ehughes/NEOS_2ND_GENERATION/TOOLS/NEOS_CAN_ADAPTER/SRC/WINDOWS/CAN_SNIFFER/bin/Debug/LightRingSelectorPanel.png

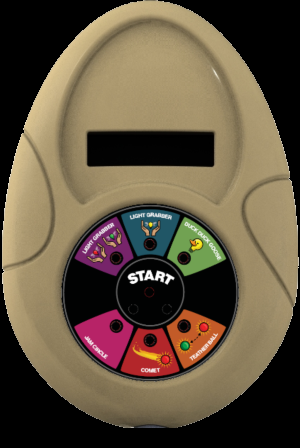
TOOLS/NEOS_CAN_ADAPTER/SRC/WINDOWS/CAN_SNIFFER/bin/Debug/LightRingSelectorPanel.png
