ehughes/NEOS_2ND_GENERATION/TOOLS/NEOS_CAN_ADAPTER/SRC/WINDOWS/CAN_SNIFFER/bin/Debug/AllAroundSelectorPanel.bmp

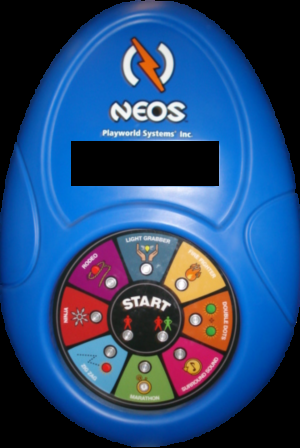
TOOLS/NEOS_CAN_ADAPTER/SRC/WINDOWS/CAN_SNIFFER/bin/Debug/AllAroundSelectorPanel.bmp
