ehughes/NEOS_2ND_GENERATION/SCH/ELC0102 - Scoreboard/BUILD_PACKAGE/GERBERS/readme.txt

Technical POC:   Eli Hughes    ehughes@wavenumber.net  814 574 7755

PCB Fab Notes.

File List:
---------------------------------------------
PCB0010.GM1   Outline
PCB0010.GM2   Dimensions
PCB0010.GM3   Cutouts

PCB0010.GTL   Top Copper
PCB0010.GTS   Top Soldermask
PCB0010.GTO   Top Silkscreen
PCB0010.GTP   Top Pastemask

PCB0010.GP1   Ground Plane   -  Negative Layer!
PCB0010.GP2   Power Plane    -  Negative Layer!

PCB0010.GBL   Bottom Copper
PCB0010.GBO   Bottom Silkscreen
PCB0010.GBS   Bottom Soldermask
PCB0010.GBP   Bottom Pastemask

PCB0010.TXT   NC Drill

4-layer Stack Up:
-------------------------------
Top  Copper
Ground Plane
Power Plane
Botton Copper

Notes:
--------------------------------------------
ALL DIMENSIONS ARE FINISHED DIMENSIONS
OVERAL DIMENSION: 15" x 7"
ALL HOLES ARE PLATED THRU W/ MIN .001 (1 OZ) COPPER.
FINISH: GOLD FLASH OVER ALL EXPOSED COPPER
MAT'L: FR-406 OR EQUIVALENT ROHS COMPLIANT, .062 THK.
NOTES:  UNLESS OTHERWISE SPECIFIED
POWER AND GROUND LAYER - 0.5 OZ COPPER.
RADIUS OF INSIDE CUTOUT - 50 MIL - SEE CUTOUTS LAYER
SILKSCREEN COMP SIDE W/ WHITE EPOXY INK, OVER SOLDERMASK.
SOLDERMASK BOTH SIDES OF BOARD. L.P.I. OVER BARE COPPER, RED.
TOP AND BOTTOM LAYER - 1 OZ COPPER AFTER PLATING.
VENDOR'S UL APPROVAL MARK MUST BE ON BOARD, 94V-0.
WEEK & YEAR OF FABRICATION TO BE STAMPED ON BOARD.
