ehughes/NEOS_2ND_GENERATION/DOCS/USB_CAN_IF.pptx

NEOS Can Bus Interface Module

FT245 USB/FIFO Interface IC

Incoming Message Queue

Outgoing Message Queue

NEOS
CAN Bus

NEOS Microcontroller

FT245 low level Interface

USB Cable to PC
