ehughes/NEOS_2ND_GENERATION/SRC/PRODUCTION_RELEASE/MASTER/SHREK/Shrek Game Mods.docx

Don’t reset back to station ID

Three chances for full game

Generate new sequence on failure

Time on inactivity should be 10 seconds, After 6 second of inactivity, count as a bad

Play sequence at One Second per button
