ehughes/NEOS_2ND_GENERATION/TOOLS/NEOS_ALL_AROUND_CONTROL_PANEL/Images/dagobert83_USB.png

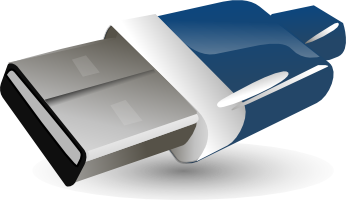
TOOLS/NEOS_ALL_AROUND_CONTROL_PANEL/Images/dagobert83_USB.png
