ehughes/NEOS_2ND_GENERATION/SCH/ELC0102 - Scoreboard/BUILD_PACKAGE/BOM/Bill of Materials-ELC0102 - Scoreboard(MAIN_BUILD).xls

Sheet: Part List Report
 | Assembly Sheet |  |  | ELC0102 - NEOS Scoreboard
 |  |  | Variant: | MAIN_BUILD
 | Report Date: |  | 12/13/2010 | 7:01:08 AM
 | Print Date: |  | 2010-12-13 | 7:05:29
# | Quantity | Designator | Description | Manufacturer | Manufacturer Part Number | Supplier 1 | Supplier Part Number 1
1 | 18 | C1, C3, C4, C10, C11, C17, C28, C30, C31, C37, C46, C47, C48, C49, C50, C51, C52, C53 | CAP .10UF 50V CERAMIC X7R 0805 | Kemet | C0805C104K5RACTU | Digi-Key | 399-1170-1-ND
2 | 3 | C2, C23, C32 | Panasonic 10uF 16V SMT | Panasonic - ECG | EEE-FK1C100R | Digi-Key | PCE3782CT-ND
3 | 2 | C8, C9 | Kemet Tantalum 47uF 35V EIA7343-43 | Kemet | T491X476K035AT | Digi-Key | 399-3821-1-ND
4 | 1 | C15 | CAP 10000PF 50V CERAMIC X7R 0805 | Kemet | C0805C103K5RACTU | Digi-Key | 399-1158-1-ND
5 | 2 | C20, C24 | CAPACITOR TANT 68UF 16V 10% SMD | Kemet | T495D686K016ATE150 | Digi-Key | 399-3889-1-ND
6 | 2 | C22, C26 | CAP CERAMIC 18PF 50V NP0 0805 | Kemet | C0805C180J5GACTU | Digi-Key | 399-1112-1-ND
7 | 1 | D1 | Diode 3A 600V SMC | ON Semiconductor | MURS360T3G | Digi-Key | MURS360T3GOSCT-ND
8 | 1 | D2 | IR Schottky Diode 8A 80V D2PAK | Vishay IR | 8TQ080SPBF | Digi-Key | 8TQ080SPBF-ND
9 | 20 | D3, D4, D5, D6, D7, D8, D9, D10, D11, D15, D16, D17, D18, D19, D20, D21, D22, D23, D24, D25 | Zener 3.0V SOD-123 | ON Semiconductor | MMSZ5225BT1G | Digi-Key | MMSZ5225BT1GOSCT-ND
10 | 84 | DS1, DS2, DS3, DS4, DS5, DS6, DS13, DS14, DS15, DS16, DS17, DS18, DS25, DS26, DS27, DS28, DS29, DS30, DS37, DS38, DS39, DS40, DS41, DS42, DS49, DS50, DS51, DS52, DS53, DS54, DS61, DS62, DS63, DS64, DS65, DS66, DS73, DS74, DS75, DS76, DS77, DS78, DS85, DS86, DS87, DS88, DS89, DS90, DS97, DS98, DS99, DS100, DS101, DS102, DS109, DS110, DS111, DS112, DS113, DS114, DS121, DS122, DS123, DS124, DS125, DS126, DS133, DS134, DS135, DS136, DS137, DS138, DS145, DS146, DS147, DS148, DS149, DS150, DS157, DS158, DS159, DS160, DS161, DS162 | Optek LED Red /Clear High Brightness T1-3/4 | TT Electronics/Optek Technology | OVLFR3C7 | Digi-Key | 365-1182-ND
11 | 84 | DS7, DS8, DS9, DS10, DS11, DS12, DS19, DS20, DS21, DS22, DS23, DS24, DS31, DS32, DS33, DS34, DS35, DS36, DS43, DS44, DS45, DS46, DS47, DS48, DS55, DS56, DS57, DS58, DS59, DS60, DS67, DS68, DS69, DS70, DS71, DS72, DS79, DS80, DS81, DS82, DS83, DS84, DS91, DS92, DS93, DS94, DS95, DS96, DS103, DS104, DS105, DS106, DS107, DS108, DS115, DS116, DS117, DS118, DS119, DS120, DS127, DS128, DS129, DS130, DS131, DS132, DS139, DS140, DS141, DS142, DS143, DS144, DS151, DS152, DS153, DS154, DS155, DS156, DS163, DS164, DS165, DS166, DS167, DS168 | Optek LED Green/Clear High Brightness T1-3/4 | OPTEK | OVLFG3C7 | Digi-Key | 365-1181-ND
12 | 4 | J11, J12, J16, J17 | Deutsch 12P Sealed PCB connector | Deutsch | DT15-12PA | LADD Industries Inc. | DT15-12PA
13 | 1 | J13 | CONN HEADER VERT 6POS 5.08MM | Phoenix Contact | 1755778 | Digi-Key | 277-1154-ND
14 | 1 | L1 | Magnetic-Core Inductor | Coilcraft | DO5022P-333MLD | Coilcraft | DO5022P-333MLD
15 | 20 | Q1, Q2, Q3, Q4, Q5, Q6, Q7, Q8, Q9, Q10, Q11, Q12, Q13, Q14, Q15, Q16, Q17, Q18, Q19, Q20 | HEXFET Power MOSFET | STMicroelectronics | VNB14NV04 | Digi-Key | VNB14NV04-ND
16 | 42 | Q22, Q23, Q24, Q25, Q26, Q27, Q28, Q29, Q30, Q31, Q32, Q33, Q34, Q35, Q36, Q37, Q38, Q39, Q40, Q41, Q42, Q43, Q44, Q45, Q46, Q47, Q48, Q49, Q50, Q51, Q52, Q53, Q54, Q55, Q56, Q57, Q58, Q59, Q60, Q61, Q62, Q63 | NPN SOT23 Silicon Planar Small Signal Transistor | Fairchild Semiconductor | BCX70K | Digi-Key | BCX70KINCT-ND
17 | 108 | R3, R6, R7, R8, R9, R10, R11, R12, R13, R14, R15, R17, R19, R33, R34, R35, R36, R37, R38, R39, R40, R41, R42, R43, R44, R45, R46, R47, R48, R49, R50, R51, R52, R55, R62, R63, R64, R65, R66, R69, R70, R71, R72, R73, R84, R85, R86, R87, R88, R89, R90, R91, R92, R93, R94, R95, R96, R97, R98, R99, R100, R101, R102, R103, R104, R105, R106, R107, R108, R109, R110, R123, R124, R125, R126, R127, R128, R141, R142, R143, R144, R145, R146, R159, R160, R161, R162, R163, R164, R177, R178, R179, R180, R181, R182, R195, R196, R197, R198, R199, R200, R213, R214, R215, R216, R217, R218, R231 | RES 5.10K OHM 1/8W 1% 0805 SMD | Panasonic - ECG | ERJ-6ENF5101V | Digi-Key | P5.10KCDKR-ND
18 | 1 | R18 | RES 1.00K OHM 1/8W 1% 0805 SMD | Panasonic - ECG | ERJ-6ENF1001V | Digi-Key | P1.00KCCT-ND
19 | 1 | R29 | RES 5.60K OHM 1/8W 1% 0805 SMD | Panasonic - ECG | ERJ-6ENF5601V | Digi-Key | P5.60KCCT-ND
20 | 1 | R32 | RES 0.0 OHM 1/8W 5% 0805 SMD | Panasonic - ECG | ERJ-6GEY0R00V | Digi-Key | P0.0ADKR-ND
21 | 1 | R56 | RES 7.50K OHM 1/8W 1% 0805 SMD | Panasonic - ECG | ERJ-6ENF7501V | Digi-Key | P7.50KCCT-ND
22 | 1 | R57 | RES 2.49K OHM 1/8W 1% 0805 SMD | Panasonic - ECG | ERJ-6ENF2491V | Digi-Key | P2.49KCCT-ND
23 | 42 | R111, R112, R113, R117, R118, R119, R129, R130, R131, R135, R136, R137, R147, R148, R149, R153, R154, R155, R165, R166, R167, R171, R172, R173, R183, R184, R185, R189, R190, R191, R201, R202, R203, R207, R208, R209, R219, R220, R221, R225, R226, R227 | RES 180 OHM 1/4W 1% 1206 SMD | Panasonic - ECG | ERJ-8ENF1800V | Digi-Key | P180FTR-ND
24 | 42 | R114, R115, R116, R120, R121, R122, R132, R133, R134, R138, R139, R140, R150, R151, R152, R156, R157, R158, R168, R169, R170, R174, R175, R176, R186, R187, R188, R192, R193, R194, R204, R205, R206, R210, R211, R212, R222, R223, R224, R228, R229, R230 | RES 120 OHM 1/4W 1% 1206 SMD | Panasonic - ECG | ERJ-8ENF1200V | Digi-Key | P120FCT-ND
25 | 8 | U1, U14, U19, U20, U21, U22, U23, U24 | Octal D-Type Transparent Latch with 3-State Outputs | NXP Semiconductors | 74HC573D-T | Digi-Key | 568-1477-1-ND
26 | 1 | U3 | Microchip dsPIC30F6014A 80-TQFP | Microchip Technology | DSPIC30F6014A-30I/PT | Digi-Key | DSPIC30F6014A30IP-ND
27 | 1 | U5 | CAN Transceiver 3.3V w/standby | Texas Instruments | SN65HVD230DR | Digi-Key | 296-11654-1-ND
28 | 1 | U7 | Simple Switcher Power Converter 150 kHz 3A Step Down Voltage Regulator | NATIONAL SEMICONDUCTOR | LM2676S-ADJ/NOPB | Newark | 41K4150
29 | 2 | U8, U12 | National Voltage reculator 3.3V DPAK | National Semiconductor | LP2950CDT-3.0 | Digi-Key | LP2950CDT-3.0-ND
30 | 2 | U10, U18 | Octal Buffer and Line Driver with 3-State Outputs | Texas Instruments | SN74HC541DWR | Digi-Key | 296-1202-1-ND
31 | 1 | U25 | 3-Line to 8-Line Decoder / Demultiplexer | STMicroelectronics | M74HC238RM13TR | Digi-Key | 497-1800-1-ND
32 | 1 | Y1 | CRYSTAL 8.192MHZ 18PF SMD | Abracon Corporation | ABLS-8.192MHZ-B2-T | Digi-Key | 535-9090-1-ND
Approved |  |  |  | Notes

Sheet: Project Information
Project Full Path | C:\eli\DATA\consulting\PLAYWORLD_SYSTEMS\NEOS\SCH\ELC0102 - Scoreboard\ELC0102 - Scoreboard.PrjPcb
Project Filename | ELC0102 - Scoreboard.PrjPcb
Variant Name | MAIN_BUILD
Data-Source Filename | ELC0102 - Scoreboard.PrjPcb
Data-Source Full Path | C:\eli\DATA\consulting\PLAYWORLD_SYSTEMS\NEOS\SCH\ELC0102 - Scoreboard\ELC0102 - Scoreboard.PrjPcb
Title | ELC102 - NEOS Scoreboard
Total Quantity | 500
Report Time | 7:01:08 AM
Report Date | 12/13/2010
Report Date & Tine | 12/13/2010 7:01:08 AM
Output Name | Bill of Materials
Output Type | BOM_PartType
Output Generator Name | BOM
Output Generator Description | Bill of Materials
