ehughes/NEOS_2ND_GENERATION/SCH/ELC0205 - Power Entry Module/BUILD_PACKAGE/BOM/Bill of Materials-ELC0205.xls

Sheet: Part List Report
 | Assembly Sheet |  |  | Bill of Materials For Schematic Document [ELC0205.SchDoc]
 |  |  | Variant: | None
 | Report Date: |  | 11/3/2010 | 6:34:29 AM
 | Print Date: |  | 2010-11-03 | 6:34:32
# | Quantity | Designator | Description | Manufacturer | Manufacturer Part Number | Supplier 1 | Supplier Part Number 1
1 | 1 | D1 | 15000W Axial Leaded Transient Voltage Suppressor | Littelfuse Inc | 15KPA24CA-B | Arrow | 15KPA24CA-B
2 | 1 | D2 | LED 5MM GAP RED RT ANGLE HOUSING | Avago Technologies US Inc. | HLMP-3301-D00B2 | Digikey | 516-1761-ND
3 | 1 | F1 | Shock-Safe Fuseholder, 5 x 20 / 6.3 x 32 mm, Slot Knob, horizontal | Schurter | 0031.2500 | Avnet | 0031.2500
4 | 1 | JP1 | Fixed Terminal Blocks MKDSP 10 HV/ 3-10. | Phoenix Contact | 1929520 | Mouser | 651-1929520
5 | 1 | R1 | RES 1.0K OHM CARBON FILM 1/4W 5% | Panasonic - ECG | ERD-S2TJ102V | Digikey | P1.0KBACT-ND
Approved |  |  |  | Notes

Sheet: Project Information
Project Full Path | C:\eli\DATA\consulting\PLAYWORLD_SYSTEMS\NEOS\SCH\ELC0205 - Power Entry Module\ELC0205 - Power Entry Module.PrjPCB
Project Filename | ELC0205 - Power Entry Module.PrjPCB
Variant Name | None
Data-Source Filename | ELC0205.SchDoc
Data-Source Full Path | C:\eli\DATA\consulting\PLAYWORLD_SYSTEMS\NEOS\SCH\ELC0205 - Power Entry Module\ELC0205.SchDoc
Title | Bill of Materials For Schematic Document [ELC0205.SchDoc]
Total Quantity | 5
Report Time | 6:34:29 AM
Report Date | 11/3/2010
Report Date & Tine | 11/3/2010 6:34:29 AM
Output Name | Bill of Materials
Output Type | BOM_PartType
Output Generator Name | BOM
Output Generator Description | Bill of Materials
