ehughes/NEOS_2ND_GENERATION/TOOLS/NEOS_CAN_ADAPTER/SCH/Project Outputs for NEOS_CAN/BOM.xls

Sheet: Part List Report
 | Assembly Sheet |  |  | NEOS USB to CAN
 |  |  | Variant: | None
 | Report Date: |  | 4/1/2008 | 11:42:52 AM
 | Print Date: |  | 2008-04-01 | 11:42:53
# | Quantity | Designator | Description | Manufacturer | Manufacturer Part Number | Source | Source Part Number
1 | 10 | C1, C2, C6, C7, C8, C9, C10, C11, C12, C13 | 0.1uF | Murata Electronics North America | GRM188R71C104KA01D | Digikey | 490-1532-1-ND
2 | 2 | C3, C4 | CAP CER 18PF 50V 5% C0G 0603 | Murata Electronics North America | CAP CER 18PF 50V 5% C0G 0603, GRM1885C1H180JA01D | Digikey | 490-1409-1-ND
3 | 1 | C5 | 10uF 1206 | Murata Electronics North America | GRM31CF51E106ZA01L | Digikey | 490-3382-1-ND
4 | 4 | D1, D2, D3, D4 | LED ALINGAP RED CLEAR 0805 SMD | Dialight | 598-8110-107F | Digikey | 598-8110-107F
5 | 1 | J1 | DTM13-12PA-R008 | Duetsch IPD | DTM13-12PA-R008 | Ladd Industries | DTM13-12PA-R008
6 | 1 | J2 | USB TYPE B R/A PCB | FCI | 61729-0010BLF | Digikey | 609-1039-ND
7 | 1 | J14 | CONN HEADER VERT 6POS 5.08MM | Phoenix Contact | 1758050 | Digikey | 277-1132-ND
8 | 2 | Q1, Q2 | TRANSISTOR NPN 100V 3A SOT-23 | Zetex Inc | ZXTN25100BFHTA | Digikey | ZXTN25100BFHCT-ND
9 | 1 | R1 | 100 | Yageo | RC0805FR-07100RL | Digikey | 311-100CRCT-ND
10 | 1 | R2 | 10k | Yageo | RC0805FR-071KL | Digikey | 311-1.00KCRCT-ND
11 | 1 | R3 | 0 | Yageo | RC0603JR-070RL | Digikey | 311-0.0GRCT-ND
12 | 1 | R4 | 3.9k | Yageo | RC0805FR-073K9L | Digikey | 311-3.90KCRCT-ND
13 | 5 | R5, R7, R8, R12, R13 | 1k | Panasonic - ECG, Yageo | RC0805FR-071KL | Digikey | 311-1.00KCRCT-ND
14 | 4 | R6, R9, R10, R11 | 300 | Yageo | RC0805FR-07300RL | Digikey | 311-300CRCT-ND
15 | 1 | U1 | IC REG LDO 500MA 3.3V SOT-223 | National Semiconductor | LM2937IMP-3.3/NOPB | Digikey | LM2937IMP-3.3CT-ND
16 | 1 | U2 | Microchip dsPIC30F6014 80-TQFP | Microchip Technology | DSPIC30F6014A-30I/PT | Digikey | DSPIC30F6014A30IP-ND
17 | 1 | U3 | IC 3.3V CAN TXRX W/STNDBY 8-SOIC | Texas Instruments | SN65HVD230DR | Digikey | 296-11654-1-ND
18 | 1 | U4 | CRYSTAL 12.288 MHZ SMT 18PF | Citizen America Corporation - Component Sales Division | HCM49 12.288MABJ-UT | Digikey | 300-8550-1-ND
19 | 1 | U5 | USB Interface ICs USB TO PARALLEL FIFO 28 PIN SSOP | FTDI | FT245RL | Mouser | 895-FT245RL
20 | 1 | U6 | PHOTOCOUPLER PHOTORELAY 4-SOP | Toshiba | TLP172A(F) | Digikey | TLP172AF-ND
Approved |  |  |  | Notes

Sheet: Project Information
Project Full Path | C:\ELI\DEVELOPMENT\NEOS_CAN_ADAPTER\SCH\NEOS_CAN.PrjPcb
Project Filename | NEOS_CAN.PrjPcb
Variant Name | None
Data-Source Filename | NEOS_CAN.PrjPcb
Data-Source Full Path | C:\ELI\DEVELOPMENT\NEOS_CAN_ADAPTER\SCH\NEOS_CAN.PrjPcb
Title | NEOS USB to CAN
Total Quantity | 41
Report Time | 11:42:52 AM
Report Date | 4/1/2008
Report Date & Tine | 4/1/2008 11:42:52 AM
Output Name | Bill of Materials
Output Type | BOM_PartType
Output Generator Name | ReportComponents
Output Generator Description | Component Reports
