ehughes/NEOS_2ND_GENERATION/SCH/ELC0103 - Master & ELC104 - Slave/BUILD_PACKAGE/ELC0104_NEOS_MASTER/BOM/Bill of Materials-NEOS Master-Slave(MASTER - ELC0104).xls

Sheet: Part List Report
 | Assembly Sheet |  |  | Bill of Materials For Variant [MASTER - ELC0104] of Project [NEOS Master-Slave.PrjPcb] (No PCB Document Selected)
 |  |  | Variant: | MASTER - ELC0104
 | Report Date: |  | 10/30/2010 | 5:32:35 PM
 | Print Date: |  | 2010-10-30 | 17:32:39
# | Quantity | Designator | Description | Manufacturer | Manufacturer Part Number | Supplier 1 | Supplier Part Number 1
1 | 10 | C1, C3, C4, C8, C11, C13, C23, C33, C37, C42 | CAP .10UF 50V CERAMIC X7R 0805 | Kemet | C0805C104K5RACTU | Digikey | 399-1170-1-ND
2 | 2 | C2, C21 | CAP ELECT 10UF 16V FK SMD | Panasonic - ECG | EEE-FK1C100R | Digikey | PCE3782CT-ND
3 | 2 | C16, C20 | CAP CERAMIC 18PF 50V NP0 0805 | Kemet | C0805C180J5GACTU | Digikey | 399-1112-1-ND
4 | 1 | D1 | DIODE ULTRA FAST 3A 600V SMC | ON Semiconductor | MURS360T3G | Digikey | MURS360T3GOSCT-ND
5 | 3 | D3, D4, D5 | Diodes Inc BAS16 75V 200mA | Diodes Inc | BAS16-7-F | Digikey | BAS16-7-F
6 | 1 | DS49 | LED 631NM TAPERED RED 5MM | TT Electronics/Optek Technology | OVLGS0C8B9 | Digikey | 365-1189-ND
7 | 1 | DS50 | LED 525NM ROUND GREEN 5MM | TT Electronics/Optek Technology | OVLFG3C7 | Digikey | 365-1181-ND
8 | 1 | J14 | CONN HEADER VERT 6POS 5.08MM | Phoenix Contact | 1755778 | Digikey | 277-1154-ND
9 | 3 | JP3, JP4, R8 | RES 0.0 OHM 1/8W 5% 0805 SMD | Panasonic - ECG | ERJ-6GEY0R00V | Digikey | P0.0ACT-ND
10 | 11 | R1, R2, R3, R6, R10, R14, R19, R21, R23, R26, R27 | RES 100K OHM 1/8W 1% 0805 SMD | Panasonic - ECG | RC0805JR-07100KL | Digikey | 311-100KARCT-ND
11 | 2 | R4, R112 | RES 10.0K OHM 1/8W 1% 0805 SMD | Panasonic - ECG | ERJ-6ENF1002V | Digikey | P10.0KCCT-ND
12 | 1 | R24 | RES 7.50K OHM 1/8W 1% 0805 SMD | Panasonic - ECG | ERJ-6ENF7501V | Digikey | P7.50KCCT-ND
13 | 1 | R25 | RES 2.49K OHM 1/8W 1% 0805 SMD | Panasonic - ECG | ERJ-6ENF2491V | Digikey | P2.49KCCT-ND
14 | 2 | R28, R40 | RES 1.00K OHM 1/8W 1% 0805 SMD | Yageo | RC0805FR-071KL | Digikey | 311-1.00KCRCT-ND
15 | 1 | R128 | RES 3.16K OHM 1/8W 1% 0805 SMD | Panasonic - ECG | ERJ-6ENF3161V | Digikey | P3.16KCCT-ND
16 | 1 | R129 | RES 20.0K OHM 1/8W 1% 0805 SMD | Panasonic - ECG | ERJ-6ENF2002V | Digikey | P20.0KCCT-ND
17 | 4 | U1, U4, U8, U9 | 64 MBit Serial SPI NOR FLASH | STMicroelectronics / Numonyx | M25P64-VMF6P | Mouser | M25P64-VMF6P
18 | 1 | U2 | IC DSPIC MCU/DSP 144K 80TQFP | Microchip Technology | DSPIC30F6014A-30I/PT | Digikey | DSPIC30F6014A30IP-ND
19 | 1 | U3 | IC 3.3V CAN TXRX W/STNDBY 8-SOIC | Texas Instruments | SN65HVD230DR | Digikey | SN65HVD230D-ND
20 | 1 | U7 | IC REG VOLT MICROPWR 3.3V TO-252 | National Semiconductor | LP2950CDT-3.3/NOPB | Digikey | LP2950CDT-3.3-ND
21 | 1 | U12 | OPTOCOUPLER TRANS-OUT 2CH 8-SOIC | Fairchild Optoelectronics Group | MOCD207M | Digikey | MOCD207M-ND
22 | 1 | U14 | IC USB-TO-UART BRIDGE 28MLP | Silicon Laboratories Inc | CP2102-GM |  | Digikey
23 | 1 | Y1 | CRYSTAL 8.192MHZ 18PF FUND SMD | Abracon Corporation | ABLS-8.192MHZ-B2-T | Digikey | 535-9090-1-ND
Approved |  |  |  | Notes

Sheet: Project Information
Project Full Path | C:\eli\DATA\consulting\PLAYWORLD_SYSTEMS\NEOS\SCH\ELC0103 - Master & ELC104 - Slave\NEOS Master-Slave.PrjPcb
Project Filename | NEOS Master-Slave.PrjPcb
Variant Name | MASTER - ELC0104
Data-Source Filename | NEOS Master-Slave.PrjPcb
Data-Source Full Path | C:\eli\DATA\consulting\PLAYWORLD_SYSTEMS\NEOS\SCH\ELC0103 - Master & ELC104 - Slave\NEOS Master-Slave.PrjPcb
Title | Bill of Materials For Variant [MASTER - ELC0104] of Project [NEOS Master-Slave.PrjPcb] (No PCB Document Selected)
Total Quantity | 53
Report Time | 5:32:35 PM
Report Date | 10/30/2010
Report Date & Tine | 10/30/2010 5:32:35 PM
Output Name | Bill of Materials
Output Type | BOM_PartType
Output Generator Name | BOM
Output Generator Description | Bill of Materials
