ehughes/NEOS_2ND_GENERATION/SCH/ELC0103 - Master & ELC104 - Slave/BUILD_PACKAGE/ELC0104_NEOS_SLAVE/BOM/Slave Board BOM-NEOS Master-Slave(SLAVE - ELC0104).xls

Sheet: Part List Report
 | Assembly Sheet |  |  | Slave Board BOM For Variant [SLAVE - ELC0104] of Project [NEOS Master-Slave.PrjPcb]
 |  |  | Variant: | SLAVE - ELC0104
 | Report Date: |  | 10/30/2010 | 5:31:55 PM
 | Print Date: |  | 2010-10-31 | 9:49:32
# | Quantity | Designator | Description | Manufacturer | Manufacturer Part Number | Supplier 1 | Supplier Part Number 1
1 | 11 | C1, C3, C6, C8, C10, C13, C17, C24, C32, C34, C37 | CAP .10UF 50V CERAMIC X7R 0805 | Kemet | C0805C104K5RACTU | Digikey | 399-1170-1-ND
2 | 5 | C2, C9, C14, C19, C21 | CAP ELECT 10UF 16V FK SMD | Panasonic - ECG | EEE-FK1C100R | Digikey | PCE3782CT-ND
3 | 2 | C5, C7 | CAPACITOR TANT 47UF 35V 10% SMD 7343-43 (EIA) | Kemet | T491X476K035AT | Digikey | 399-3821-1-ND
4 | 2 | C12, C26 | CAP 10000PF 50V CERAMIC X7R 0805 | Kemet | C0805C103K5RACTU | Digikey | 399-1158-1-ND
5 | 2 | C15, C28 | CAP 1UF 25V CERAMIC X7R 1206 | Panasonic - ECG | ECJ-3YB1E105K | Digikey | PCC1893CT-ND
6 | 2 | C16, C20 | CAP CERAMIC 18PF 50V NP0 0805 | Kemet | C0805C180J5GACTU | Digikey | 399-1112-1-ND
7 | 4 | C18, C22, C30, C31 | CAPACITOR TANT 68UF 16V 10% SMD | Kemet | T495D686K016ATE150 | Digikey | 399-3889-1-ND
8 | 1 | C25 | CAP .33UF 25V CERAMIC X7R 1206 | Panasonic - ECG | ECJ-3VB1E334K | Digikey | PCC1889CT-ND
9 | 1 | D1 | DIODE ULTRA FAST 3A 600V SMC | ON Semiconductor | MURS360T3G | Digikey | MURS360T3GOSCT-ND
10 | 2 | D2, D7 | DIODE SCHOTTKY 80V 8A D2PAK | Vishay IR | 8TQ100SPBF | Digikey | 844-8TQ100SPBF
11 | 24 | DS1, DS2, DS5, DS6, DS9, DS10, DS13, DS14, DS17, DS18, DS21, DS22, DS25, DS26, DS29, DS30, DS33, DS34, DS37, DS38, DS41, DS42, DS45, DS46 | Vishay Red LED PLCC-3 | Vishay | TLMK3210-GS08 | Future | TLMK3210-GS08
12 | 24 | DS3, DS4, DS7, DS8, DS11, DS12, DS15, DS16, DS19, DS20, DS23, DS24, DS27, DS28, DS31, DS32, DS35, DS36, DS39, DS40, DS43, DS44, DS47, DS48 | 120-degree, 3.3 x 3.5-mm, SMT LED in green color with water-transparent lens | Cree | LM1-PPG1-01-N1 | Marktech Optoelectronics | LM1-PPG1-01-N1
13 | 1 | J14 | CONN HEADER VERT 6POS 5.08MM | Phoenix Contact | 1755778 | Digikey | 277-1154-ND
14 | 2 | JP3, R8 | RES 0.0 OHM 1/8W 5% 0805 SMD | Panasonic - ECG | ERJ-6GEY0R00V | Digikey | P0.0ACT-ND
15 | 2 | L1, L2 | 33uH 3A Surface Mount Inductor | CoilCraft | DO5022P-333MLB | CoilCraft | DO5022P-333MLB
16 | 2 | Q1, Q2 | MOSFET N-CH 30V 8.5A 8-SOIC | Fairchild Semiconductor | FDS8884 | Digikey | FDS8884CT-ND
17 | 5 | R4, R11, R20, R112, R130 | RES 10.0K OHM 1/8W 1% 0805 SMD | Panasonic - ECG | ERJ-6ENF1002V | Digikey | P10.0KCCT-ND
18 | 4 | R7, R17, R28, R40 | RES 1.00K OHM 1/8W 1% 0805 SMD | Yageo | RC0805FR-071KL | Digikey | 311-1.00KCRCT-ND
19 | 2 | R9, R128 | RES 3.16K OHM 1/8W 1% 0805 SMD | Panasonic - ECG | ERJ-6ENF3161V | Digikey | P3.16KCCT-ND
20 | 1 | R12 | RES 499 OHM 1/8W 1% 0805 SMD | Panasonic - ECG | ERJ-6ENF4990V | Digikey | P499CCT-ND
21 | 1 | R13 | RES 3.32K OHM 1/8W 1% 0805 SMD | Panasonic - ECG | ERJ-6ENF3321V | Digikey | P3.32KCCT-ND
22 | 1 | R15 | RES 47.5K OHM 1/8W 1% 0805 SMD | Panasonic - ECG | ERJ-6ENF4752V | Digikey | P47.5KCCT-ND
23 | 2 | R16, R129 | RES 20.0K OHM 1/8W 1% 0805 SMD | Panasonic - ECG | ERJ-6ENF2002V | Digikey | P20.0KCCT-ND
24 | 1 | R18 | RES 1.65K OHM 1/8W 1% 0805 SMD | Panasonic - ECG | ERJ-6ENF1651V | Digikey | P1.65KCCT-ND
25 | 6 | R19, R21, R23, R26, R27, R30 | RES 100K OHM 1/8W 1% 0805 SMD | Panasonic - ECG | RC0805JR-07100KL | Digikey | 311-100KARCT-ND
26 | 1 | R24 | RES 7.50K OHM 1/8W 1% 0805 SMD | Panasonic - ECG | ERJ-6ENF7501V | Digikey | P7.50KCCT-ND
27 | 1 | R25 | RES 2.49K OHM 1/8W 1% 0805 SMD | Panasonic - ECG | ERJ-6ENF2491V | Digikey | P2.49KCCT-ND
28 | 24 | R46, R47, R48, R49, R50, R51, R52, R53, R54, R55, R56, R57, R88, R89, R90, R91, R92, R93, R94, R95, R96, R97, R98, R99 | RES 15.0 OHM 1/4W 1% 1206 SMD | Panasonic - ECG | ERJ-8ENF15R0V | Digikey | P15.0FTR-ND
29 | 24 | R58, R59, R60, R61, R62, R63, R64, R65, R66, R67, R68, R69, R100, R101, R102, R103, R104, R105, R106, R107, R108, R109, R110, R111 | RES 32.4 OHM 1/4W 1% 1206 SMD | Panasonic - ECG | ERJ-8ENF32R4V | Digikey | P32.4FTR-ND
30 | 1 | U2 | IC DSPIC MCU/DSP 144K 80TQFP | Microchip Technology | DSPIC30F6014A-30I/PT | Digikey | DSPIC30F6014A30IP-ND
31 | 1 | U3 | IC 3.3V CAN TXRX W/STNDBY 8-SOIC | Texas Instruments | SN65HVD230DR | Digikey | SN65HVD230D-ND
32 | 1 | U5 | IC DAC 24BIT 192KHZ 10-TSSOP | Cirrus Logic Inc | CS4344-CZZ | Digikey | 598-1051-5-ND
33 | 2 | U6, U11 | Simple Switcher Power Converter 150 kHz 3A Step Down Voltage Regulator | NATIONAL SEMICONDUCTOR | LM2676S-ADJ/NOPB | Newark | 41K4150
34 | 1 | U7 | IC REG VOLT MICROPWR 3.3V TO-252 | National Semiconductor | LP2950CDT-3.3/NOPB | Digikey | LP2950CDT-3.3-ND
35 | 1 | U10 | IC AMP AUDIO PWR W/SHUTDN 8-SOIC | National Semiconductor | LM4861M | Digikey | LM4861M-ND
36 | 1 | U12 | OPTOCOUPLER TRANS-OUT 2CH 8-SOIC | Fairchild Optoelectronics Group | MOCD207M | Digikey | MOCD207M-ND
37 | 1 | U13 | TI Tri State Buffer Single Gate | Texas Instruments | SN74AHC1G125DBVR | Digikey | 296-8744-1-ND
38 | 1 | Y1 | CRYSTAL 8.192MHZ 18PF FUND SMD | Abracon Corporation | ABLS-8.192MHZ-B2-T | Digikey | 535-9090-1-ND
Approved |  |  |  | Notes

Sheet: Project Information
Project Full Path | C:\eli\DATA\consulting\PLAYWORLD_SYSTEMS\NEOS\SCH\ELC0103 - Master & ELC104 - Slave\NEOS Master-Slave.PrjPcb
Project Filename | NEOS Master-Slave.PrjPcb
Variant Name | SLAVE - ELC0104
Data-Source Filename | NEOS Master-Slave.PrjPcb
Data-Source Full Path | C:\eli\DATA\consulting\PLAYWORLD_SYSTEMS\NEOS\SCH\ELC0103 - Master & ELC104 - Slave\NEOS Master-Slave.PrjPcb
Title | Slave Board BOM For Variant [SLAVE - ELC0104] of Project [NEOS Master-Slave.PrjPcb] (No PCB Document Selected)
Total Quantity | 170
Report Time | 5:31:55 PM
Report Date | 10/30/2010
Report Date & Tine | 10/30/2010 5:31:55 PM
Output Name | Slave Board BOM
Output Type | BOM_PartType
Output Generator Name | BOM
Output Generator Description | Bill of Materials
