ehughes/NEOS_2ND_GENERATION/SCH/ELC0205 - Power Entry Module/BUILD_PACKAGE/GERBERS/readme.txt

Technical POC:   Eli Hughes    ehughes@wavenumber.net  814 574 7755

PCB Fab Notes.

File List:
---------------------------------------------
PCB0007.GM1   Outline
PCB0007.GM2   Dimensions

PCB0007.GTL   Top Copper
PCB0007.GTS   Top Soldermask
PCB0007.GTO   Top Silkscreen
PCB0007.GTP   Top Pastemask

PCB0007.GBL   Bottom Copper
PCB0007.GBS   Bottom Soldermask
PCB0007.GBP   Bottom Pastemask

PCB0007.TXT   NC Drill

2-layer Stack Up:
-------------------------------
Top  Copper
Botton Copper

Notes:
--------------------------------------------
ALL DIMENSIONS ARE FINISHED DIMENSIONS
OVERAL DIMENSION: 4.0" x 2.5"
TOP AND BOTTOM LAYER - 2 OZ COPPER AFTER PLATING.
ALL HOLES ARE PLATED THRU W/ MIN .001 (1 OZ) COPPER.
FINISH: GOLD FLASH OVER ALL EXPOSED COPPER
MAT'L: FR-406 OR EQUIVALENT ROHS COMPLIANT, .062 THK.
NOTES:  UNLESS OTHERWISE SPECIFIED
SILKSCREEN COMP SIDE W/ WHITE EPOXY INK, OVER SOLDERMASK.
SOLDERMASK BOTH SIDES OF BOARD. L.P.I. OVER BARE COPPER, RED.
VENDOR'S UL APPROVAL MARK MUST BE ON BOARD, 94V-0.
WEEK & YEAR OF FABRICATION TO BE STAMPED ON BOARD.
