ehughes/NEOS_2ND_GENERATION/SCH/ELC0103 - Master & ELC104 - Slave/BUILD_PACKAGE/ELC0104_NEOS_MASTER/GERBERS/readme.txt

See PCB0010 gerbers with the slave build package.  NEOS Master and Slave Assemblies use the same PCB.
