ehughes/NEOS_2ND_GENERATION/SCH/ELC0103 - Master & ELC104 - Slave/BUILD_PACKAGE/ELC0104_NEOS_MASTER/PCB_PRINTS/readme.txt

See PCB prints with the NEOS slave build package.  NEOS Master and Slave Assemblies use the same PCB (PCB0009).
