ehughes/NEOS_2ND_GENERATION/SCH/ELC0103 - Master & ELC104 - Slave/BUILD_PACKAGE/ELC0104_NEOS_SLAVE/GERBERS/readme.txt

Technical POC:   Eli Hughes    ehughes@wavenumber.net  814 574 7755

PCB Fab Notes.

File List:
---------------------------------------------
PCB0008.GM1   Outline
PCB0008.GM2   Dimensions
PCB0008.GM3   Cutouts

PCB0008.GTL   Top Copper
PCB0008.GTS   Top Soldermask
PCB0008.GTO   Top Silkscreen
PCB0008.GTP   Top Pastemask

PCB0008.GP1   Ground Plane   -  Negative Layer!
PCB0008.GP2   Power Plane    -  Negative Layer!

PCB0008.GBL   Bottom Copper
PCB0008.GBO   Bottom Silkscreen
PCB0008.GBS   Bottom Soldermask
PCB0008.GBP   Bottom Pastemask

PCB0008.TXT   NC Drill

4-layer Stack Up:
-------------------------------
Top  Copper
Ground Plane
Power Plane
Botton Copper

Notes:
--------------------------------------------
ALL DIMENSIONS ARE FINISHED DIMENSIONS
OVERAL DIMENSION: 5.5" x 5.5"
ALL HOLES ARE PLATED THRU W/ MIN .001 (1 OZ) COPPER.
FINISH: GOLD FLASH OVER ALL EXPOSED COPPER
MAT'L: FR-406 OR EQUIVALENT ROHS COMPLIANT, .062 THK.
NOTES:  UNLESS OTHERWISE SPECIFIED
POWER AND GROUND LAYER - 0.5 OZ COPPER.
RADIUS OF INSIDE CUTOUT - 50 MIL - SEE CUTOUTS LAYER
SILKSCREEN COMP SIDE W/ WHITE EPOXY INK, OVER SOLDERMASK.
SOLDERMASK BOTH SIDES OF BOARD. L.P.I. OVER BARE COPPER, RED.
TOP AND BOTTOM LAYER - 1 OZ COPPER AFTER PLATING.
VENDOR'S UL APPROVAL MARK MUST BE ON BOARD, 94V-0.
WEEK & YEAR OF FABRICATION TO BE STAMPED ON BOARD.
