ehughes/NEOS_2ND_GENERATION/SCH/ELC0102 - Scoreboard/BUILD_PACKAGE/ELC0102 - Scoreboard Post Assembly Wiring Notes.pdf

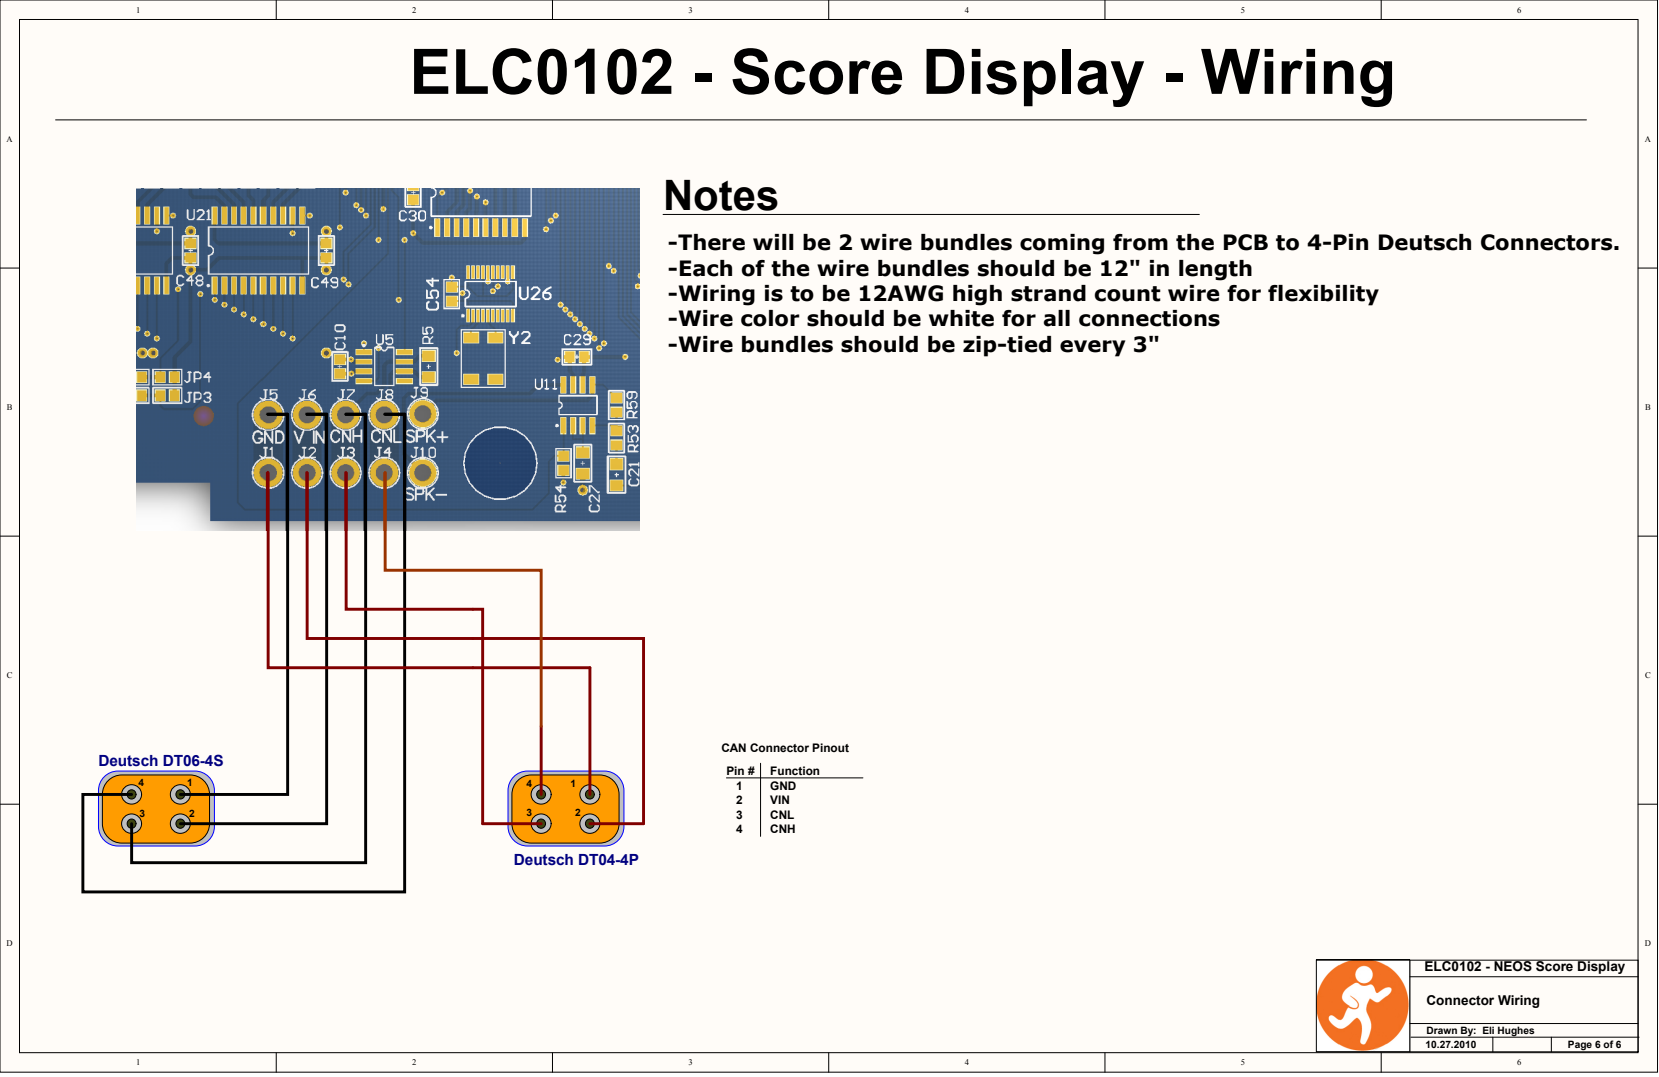
[picture p5: page 1]

-There will be 2 wire bundles coming from the PCB to 4-Pin Deutsch Connectors.
-Each of the wire bundles should be 12" in length
-Wiring is to be 12AWG high strand count wire for flexibility
-Wire color should be white for all connections
-Wire bundles should be zip-tied every 3"

Drawn By: Eli Hughes
10.27.2010 Page 6 of 6
