ehughes/NEOS_2ND_GENERATION/SCH/ELC0205 - Power Entry Module/BUILD_PACKAGE/WIRING_NOTES.pdf

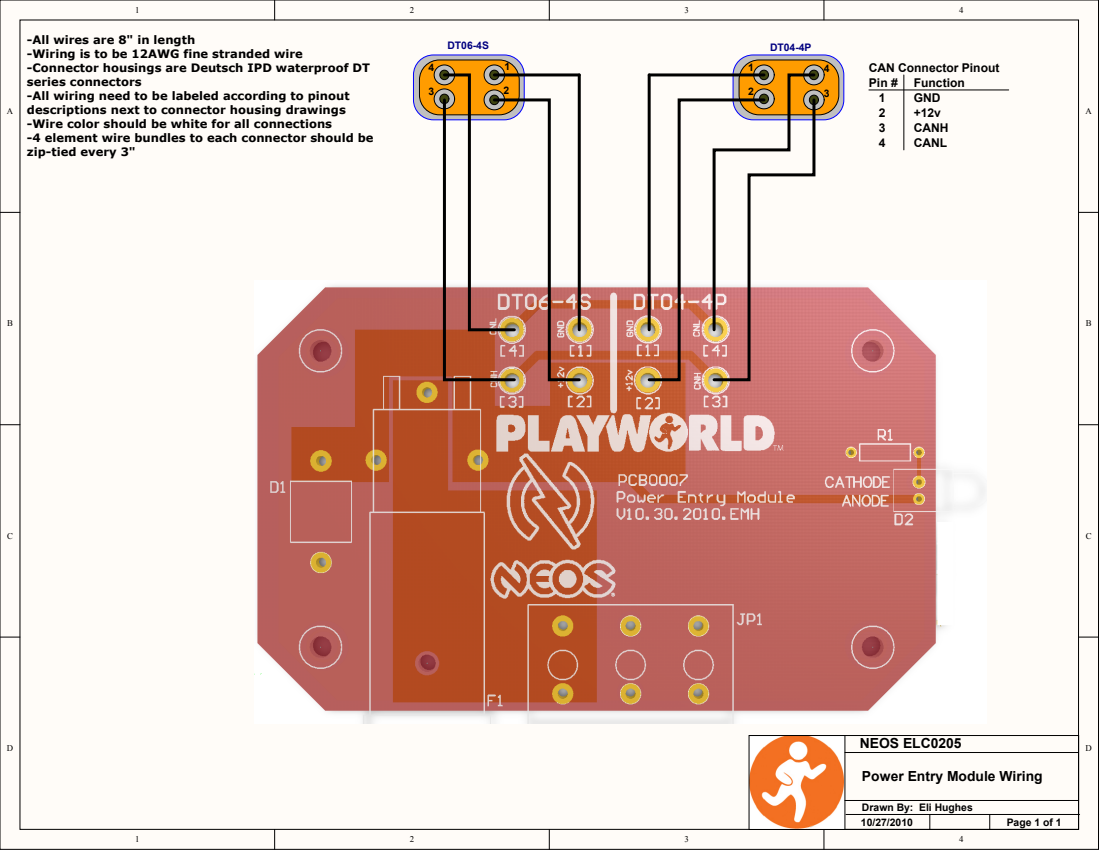
[picture p6: page 1]

-All wires are 8" in length
-Wiring is to be 12AWG fine stranded wire
-Connector housings are Deutsch IPD waterproof DT
series connectors
-All wiring need to be labeled according to pinout
descriptions next to connector housing drawings
-Wire color should be white for all connections
-4 element wire bundles to each connector should be
zip-tied every 3"

Power Entry Module Wiring

Drawn By: Eli Hughes
