ehughes/NEOS_2ND_GENERATION/SCH/ELC0102 - Scoreboard/BUILD_PACKAGE/SCHEMATICS_PRINTS/ELC0102 - ScoreBoard Schematics.pdf

-There will be 2 wire bundles coming from the PCB to 4-Pin Deutsch Connectors.
-Each of the wire bundles should be 12" in length
-Wiring is to be 12AWG high strand count wire for flexibility
-Wire color should be white for all connections
-Wire bundles should be zip-tied every 3"

Drawn By: Eli Hughes
10.27.2010 Page 6 of 6

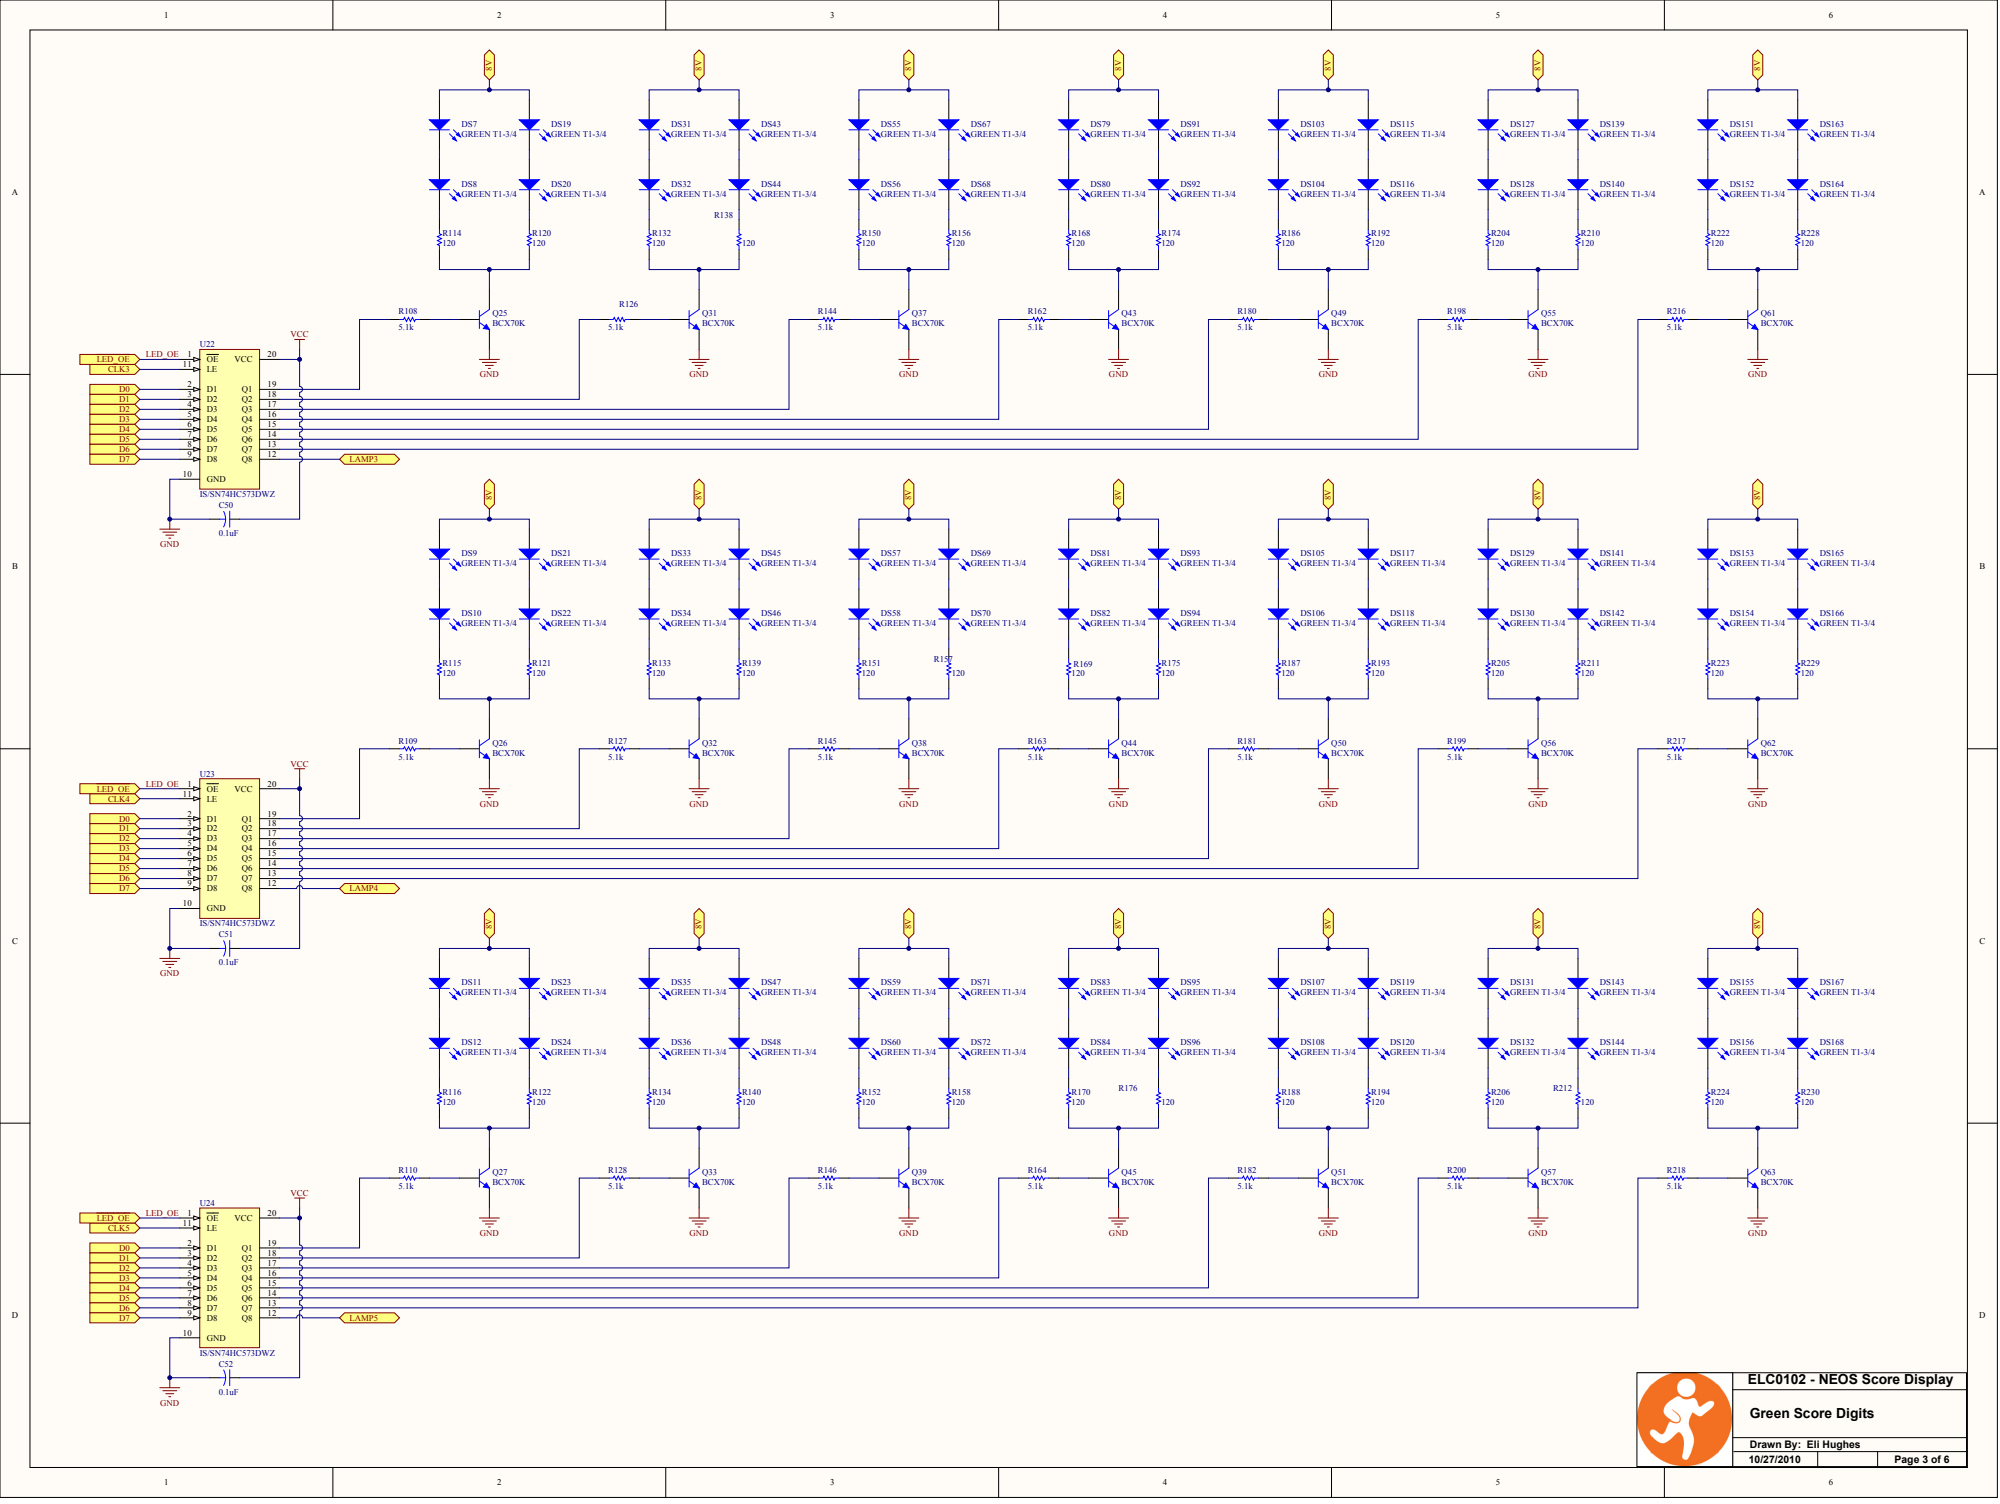
[picture p7: page 2]

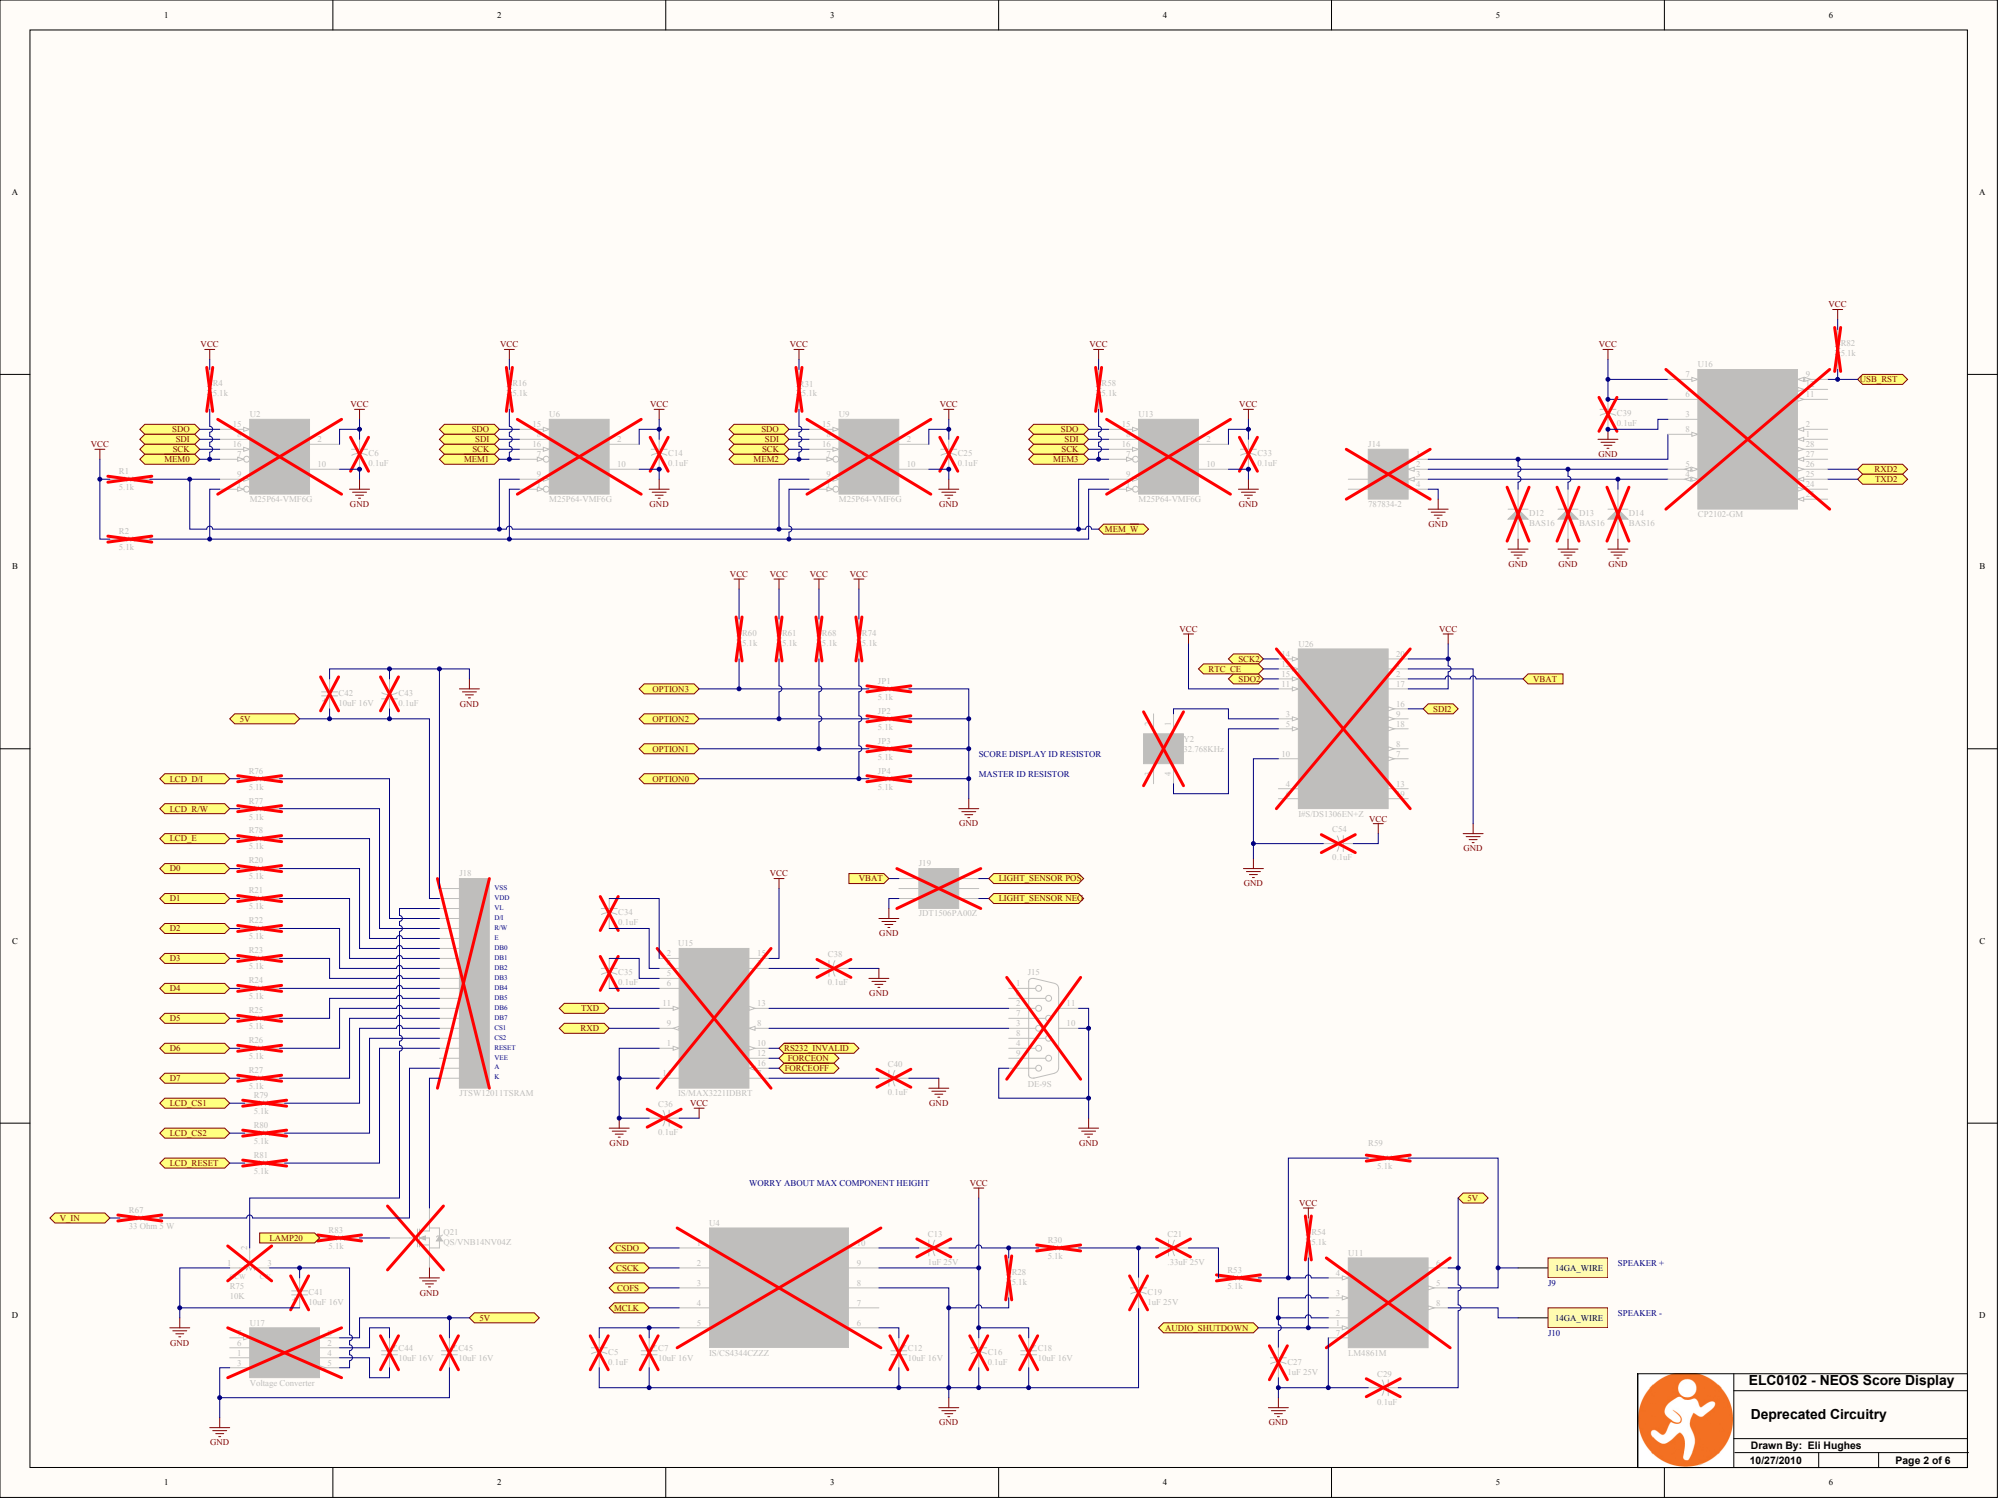
[picture p8: page 3]

SCORE DISPLAY ID RESISTOR

WORRY ABOUT MAX COMPONENT HEIGHT

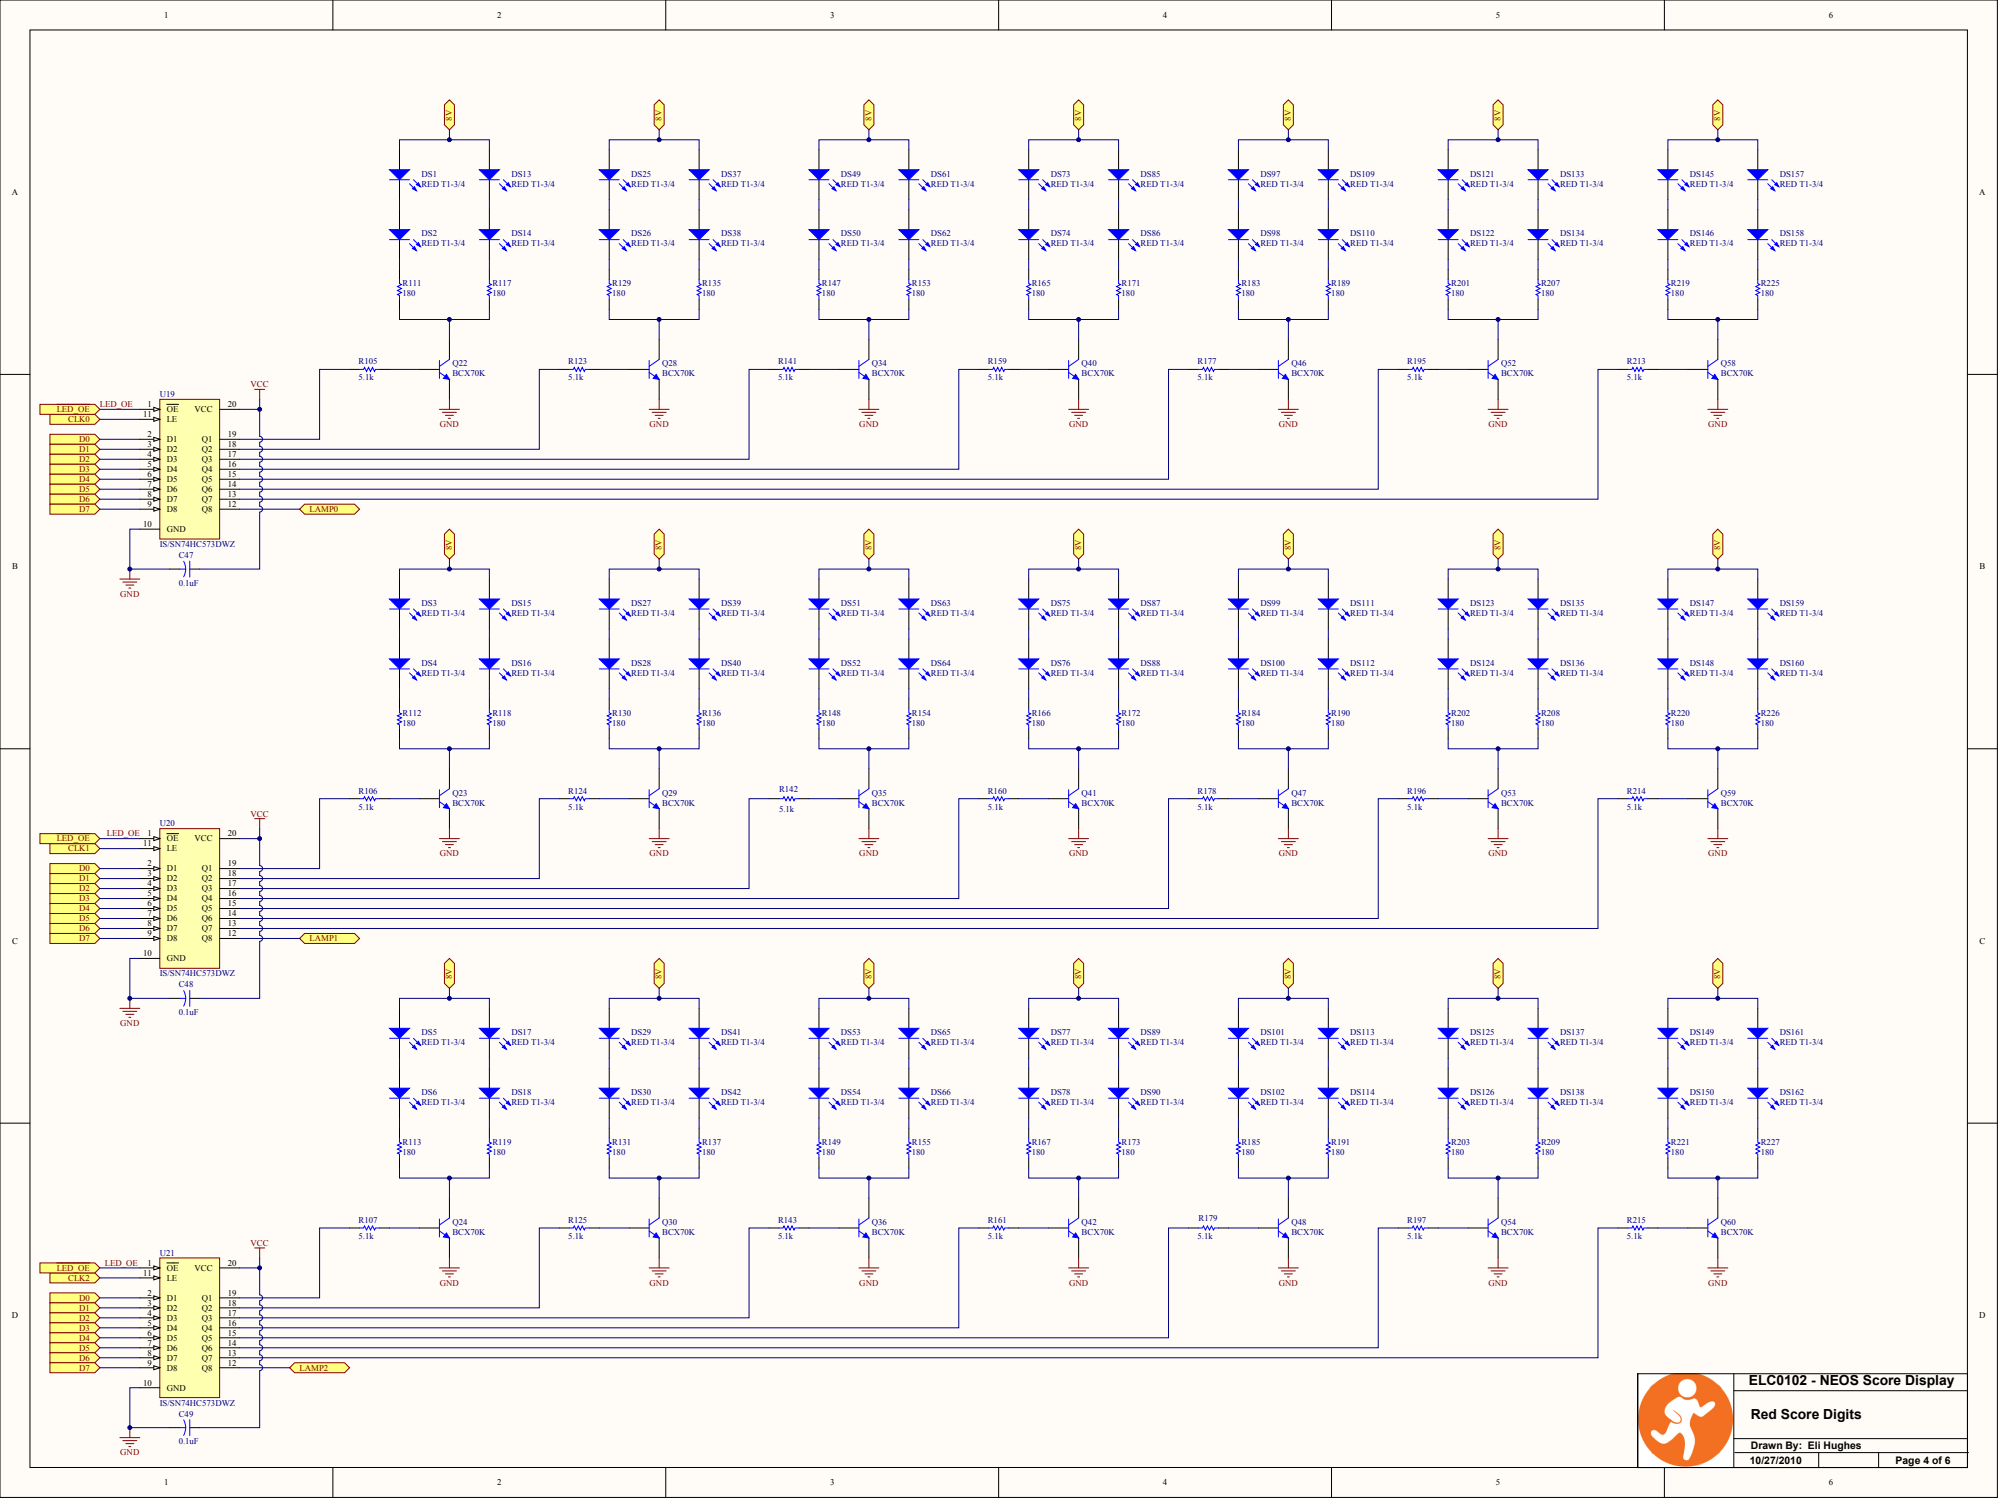
[picture p9: page 4]

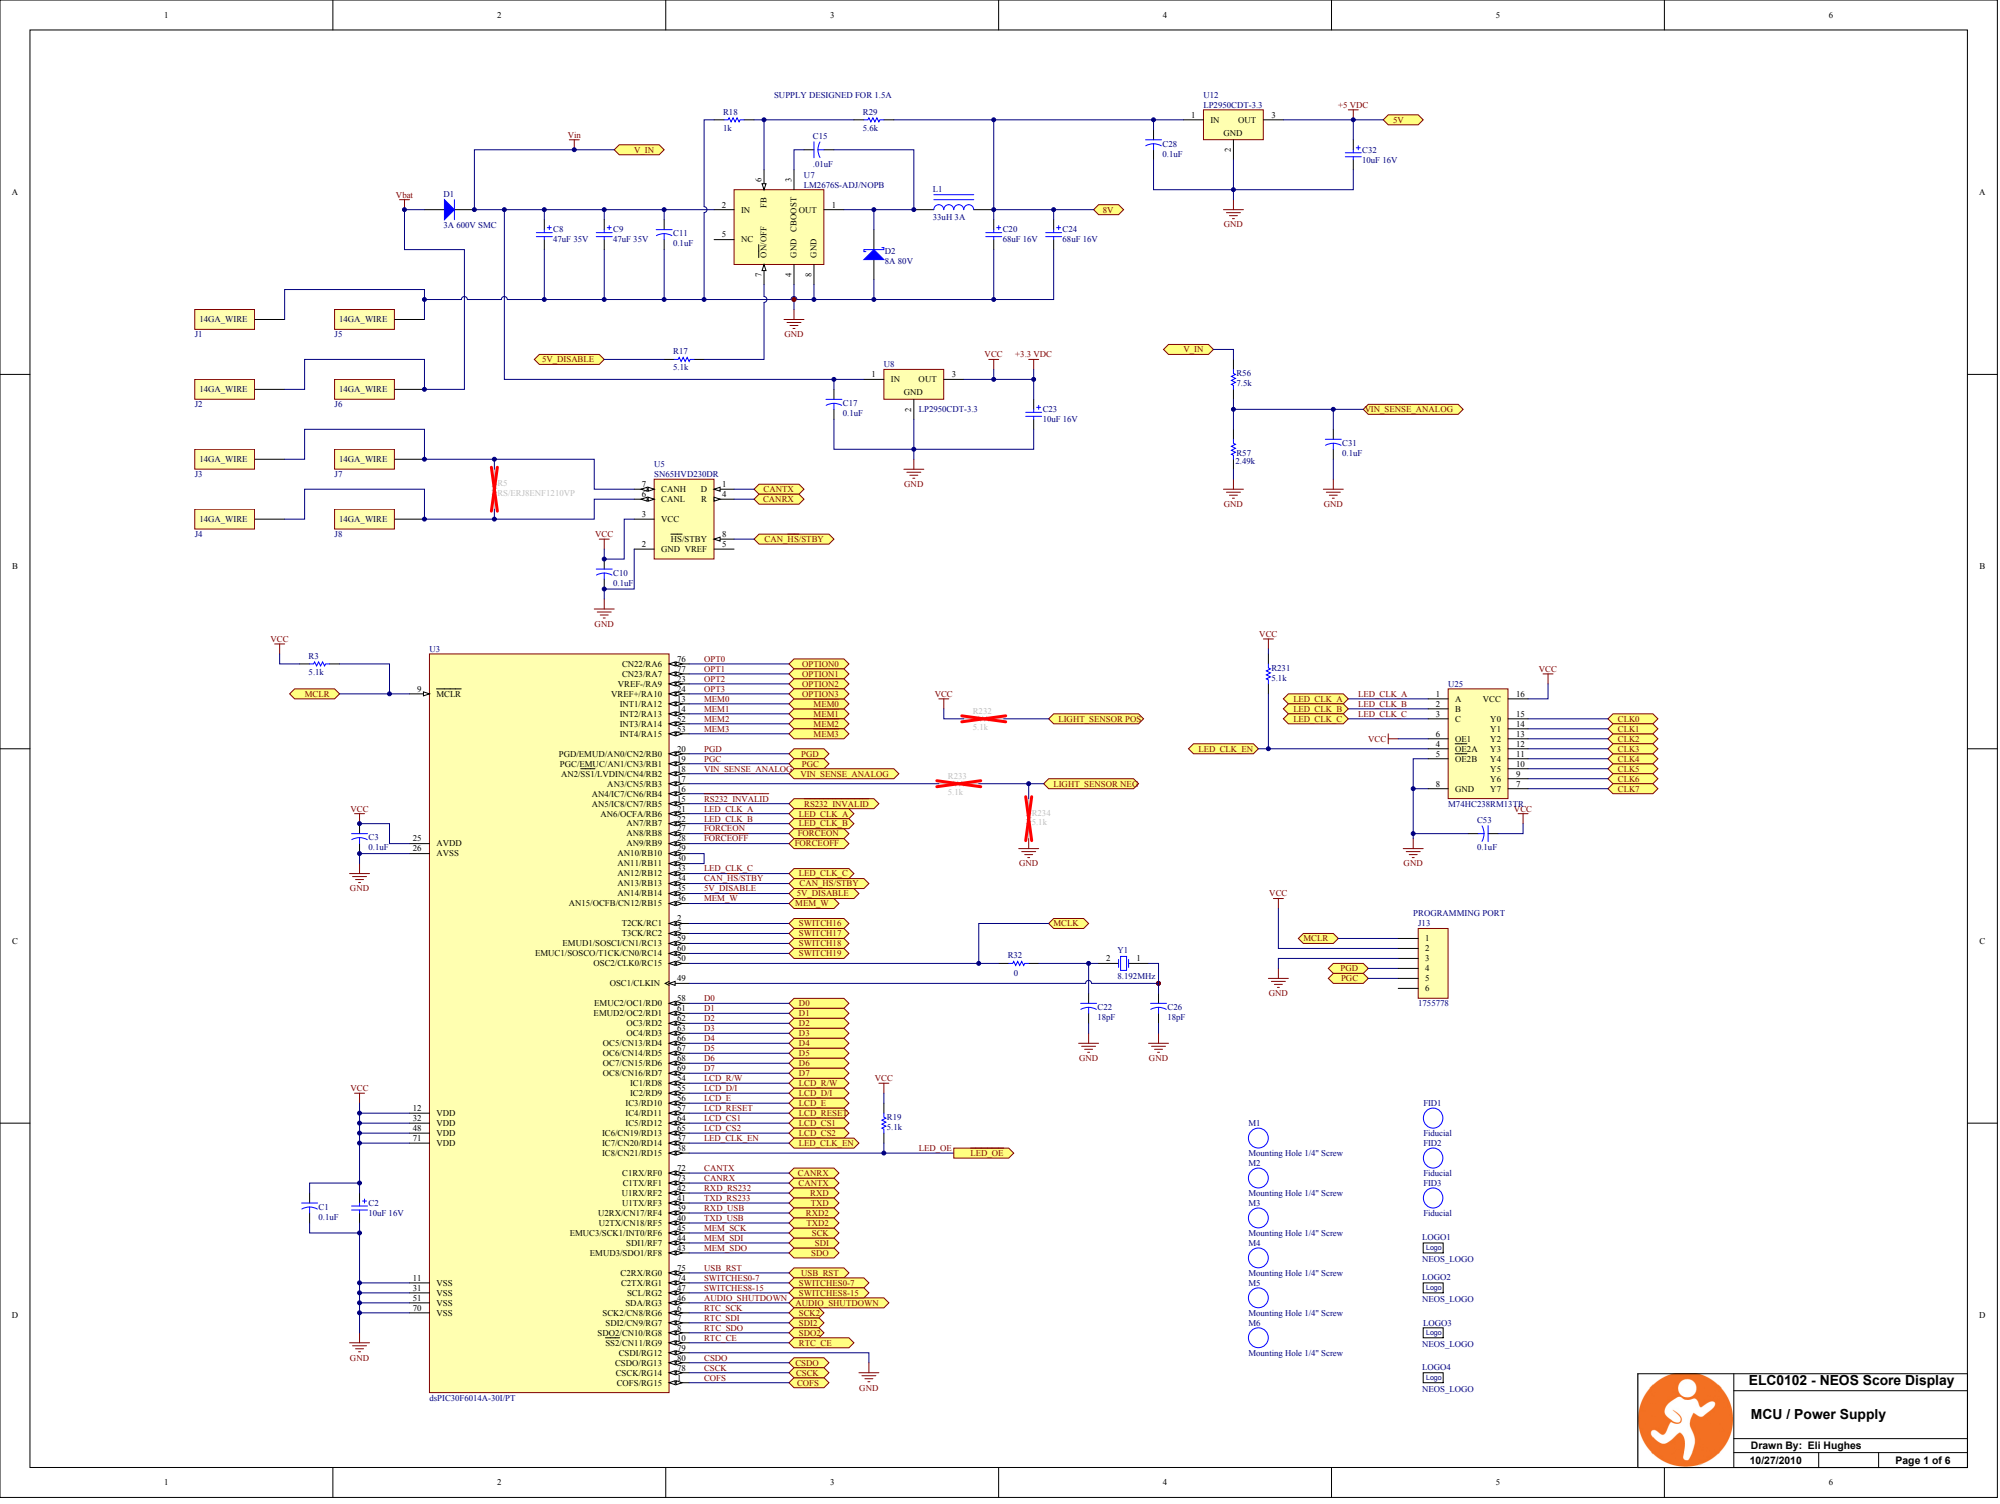
[picture p10: page 5]

SWITCH17 SWITCH18 SWITCH19 R32

D0 | | 8.192MHz

VDD 32
VDD 48
VDD 71 | LED_CLK_EN

VSS 11

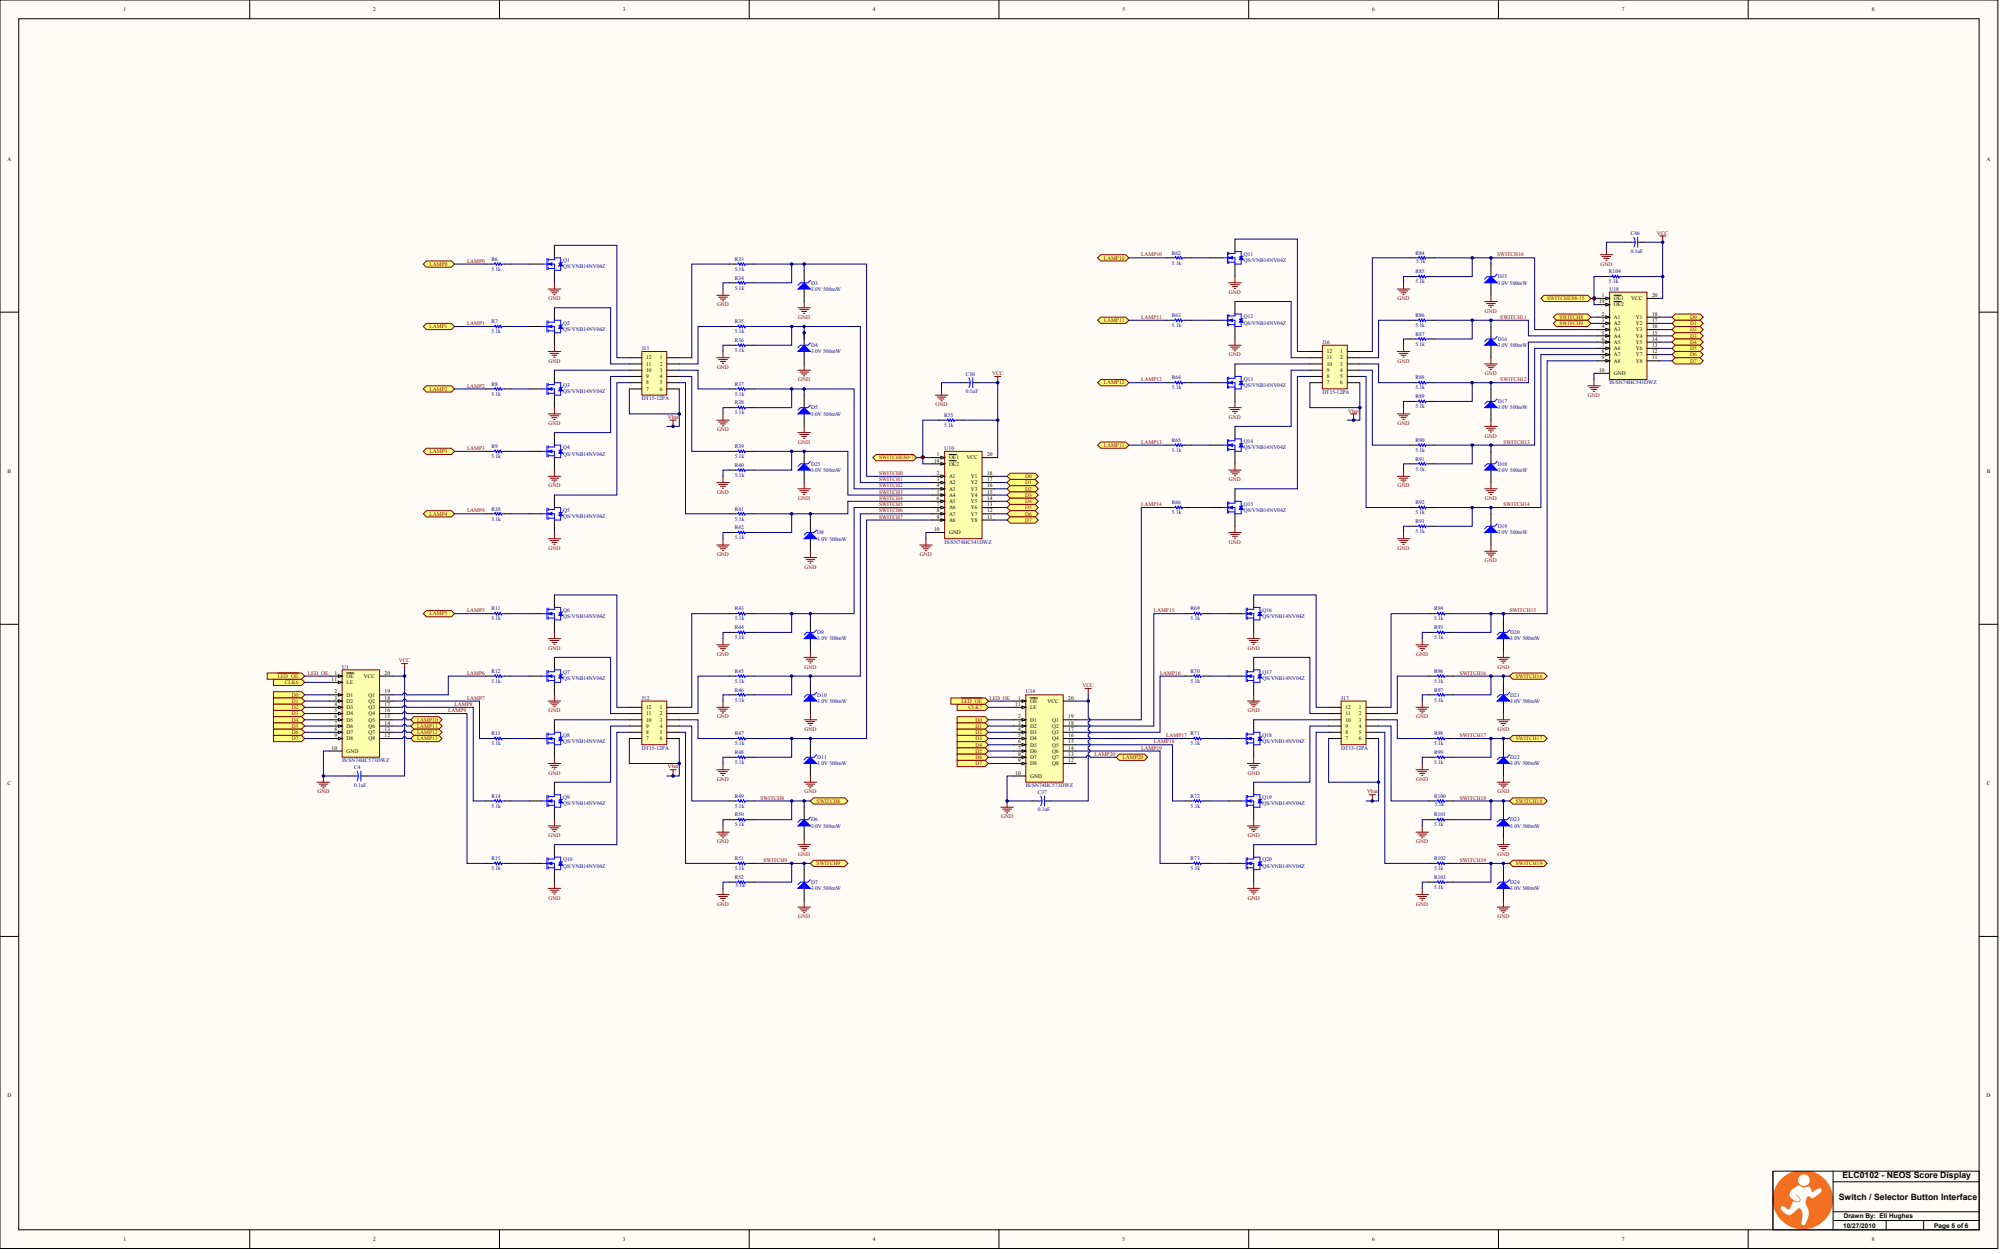
[picture p11: page 6]

SWITCH9

GND 10

D17 3.0V 500m | W SWITCH13

D18 3.0V 500m | W SWITCH14

SWITCH1 | 3
SWITCH2 | 4
SWITCH3 | | 5

SWITCH5 | 7
SWITCH6 | 8

GND

Switch / Selector Button Interface
