ehughes/NEOS_2ND_GENERATION/SCH/ELC0103 - Master & ELC104 - Slave/BUILD_PACKAGE/ELC0104_NEOS_MASTER/WIRING_NOTES.pdf

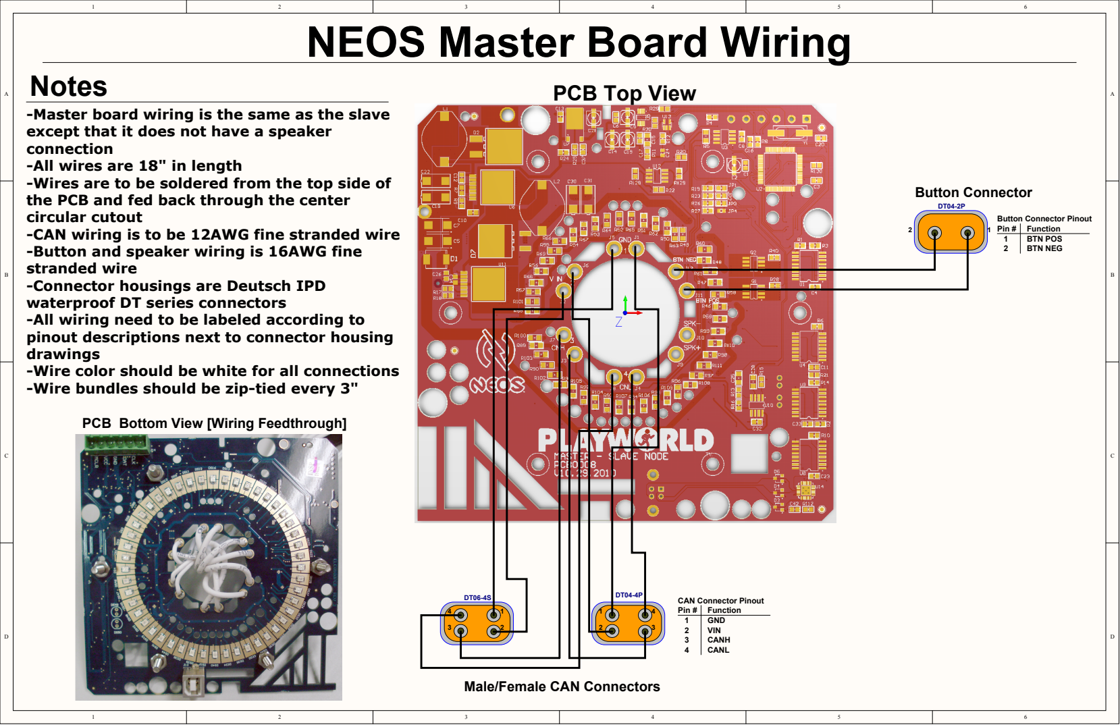
[picture p12: page 1]

NEOS Master Board Wiring

-Master board wiring is the same as the slave
except that it does not have a speaker
connection
-All wires are 18" in length
-Wires are to be soldered from the top side of
the PCB and fed back through the center
circular cutout
-CAN wiring is to be 12AWG fine stranded wire
-Button and speaker wiring is 16AWG fine
stranded wire
-Connector housings are Deutsch IPD
waterproof DT series connectors
-All wiring need to be labeled according to
pinout descriptions next to connector housing
drawings
-Wire color should be white for all connections
-Wire bundles should be zip-tied every 3"

PCB Bottom View [Wiring Feedthrough]

Male/Female CAN Connectors
