ehughes/NEOS_2ND_GENERATION/SCH/ELC0102 - Scoreboard/BUILD_PACKAGE/PCB_PRINTS/ELC0102 - ScoreBoard.pdf

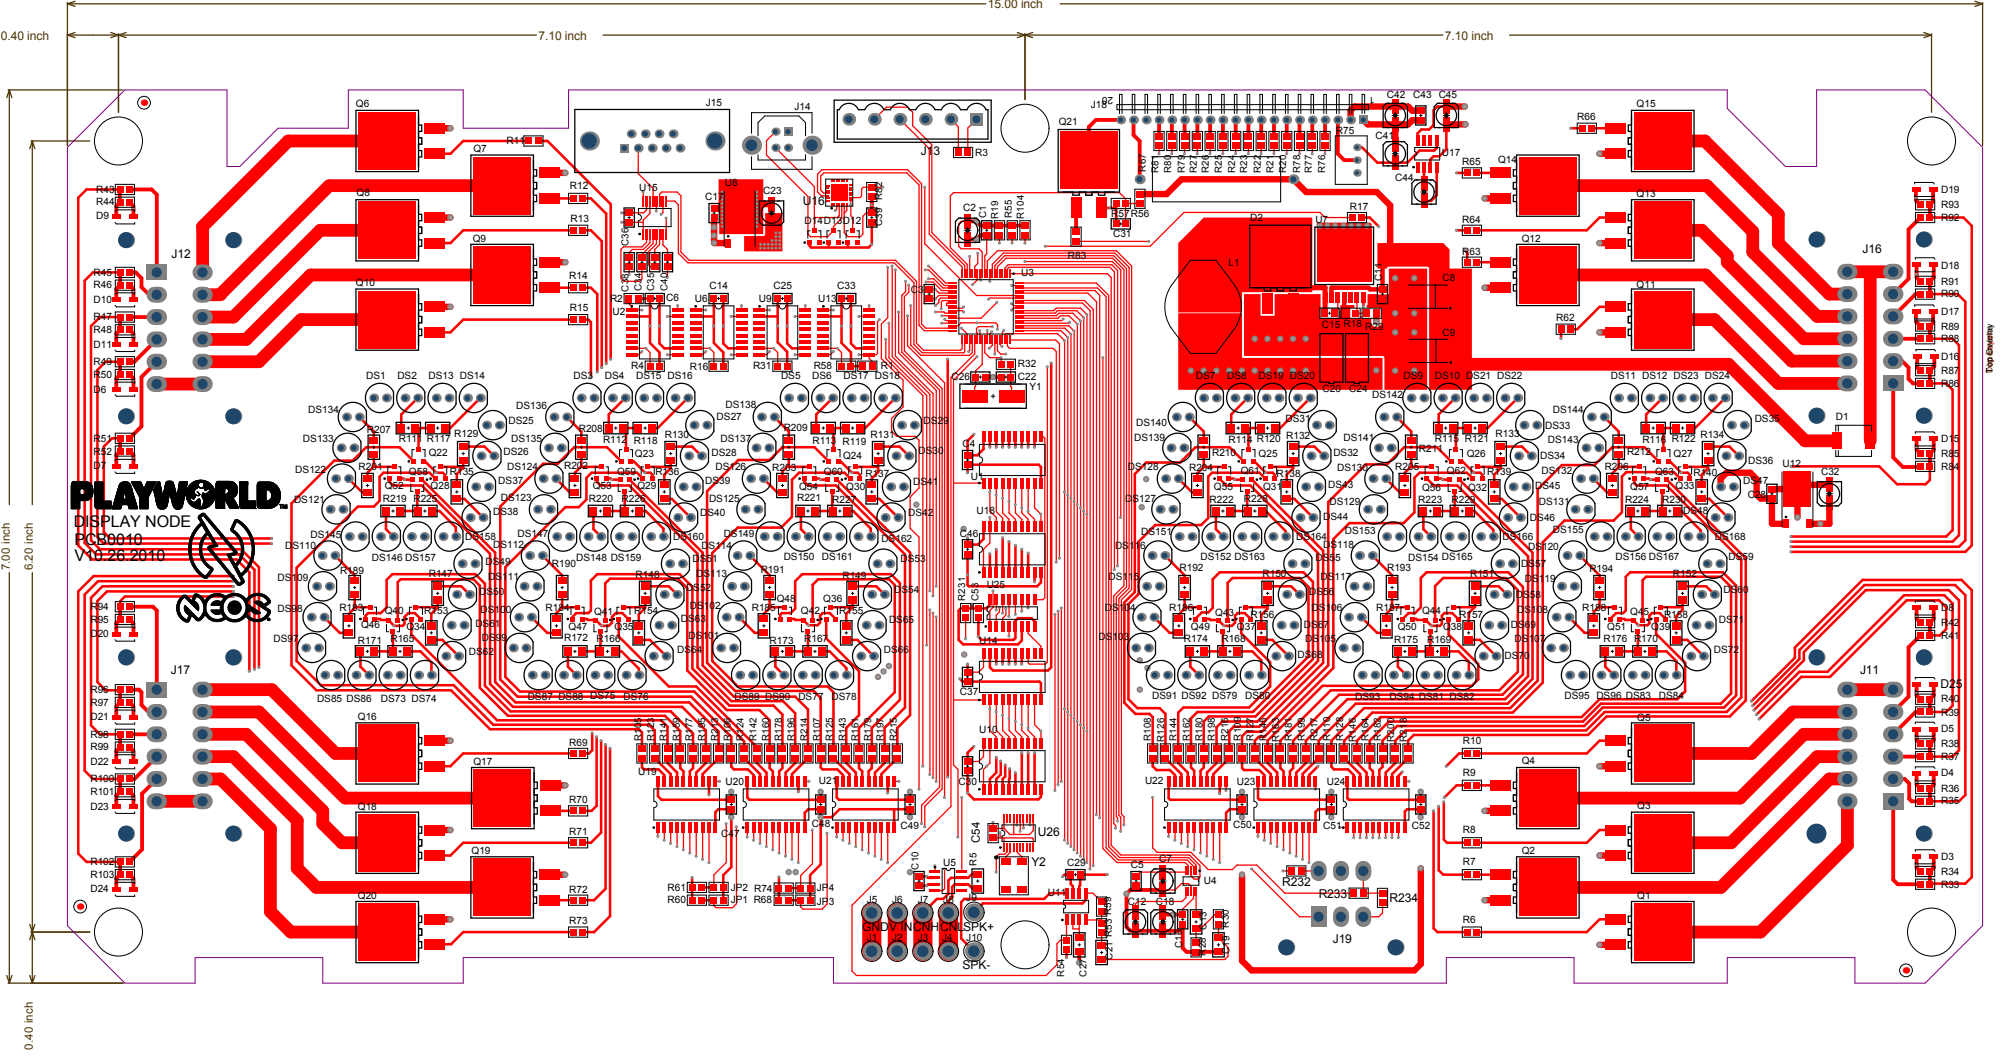
[picture p13: page 1]
