ehughes/NEOS_2ND_GENERATION/SCH/ELC0205 - Power Entry Module/BUILD_PACKAGE/PCB_PRINTS/PCB0007.pdf

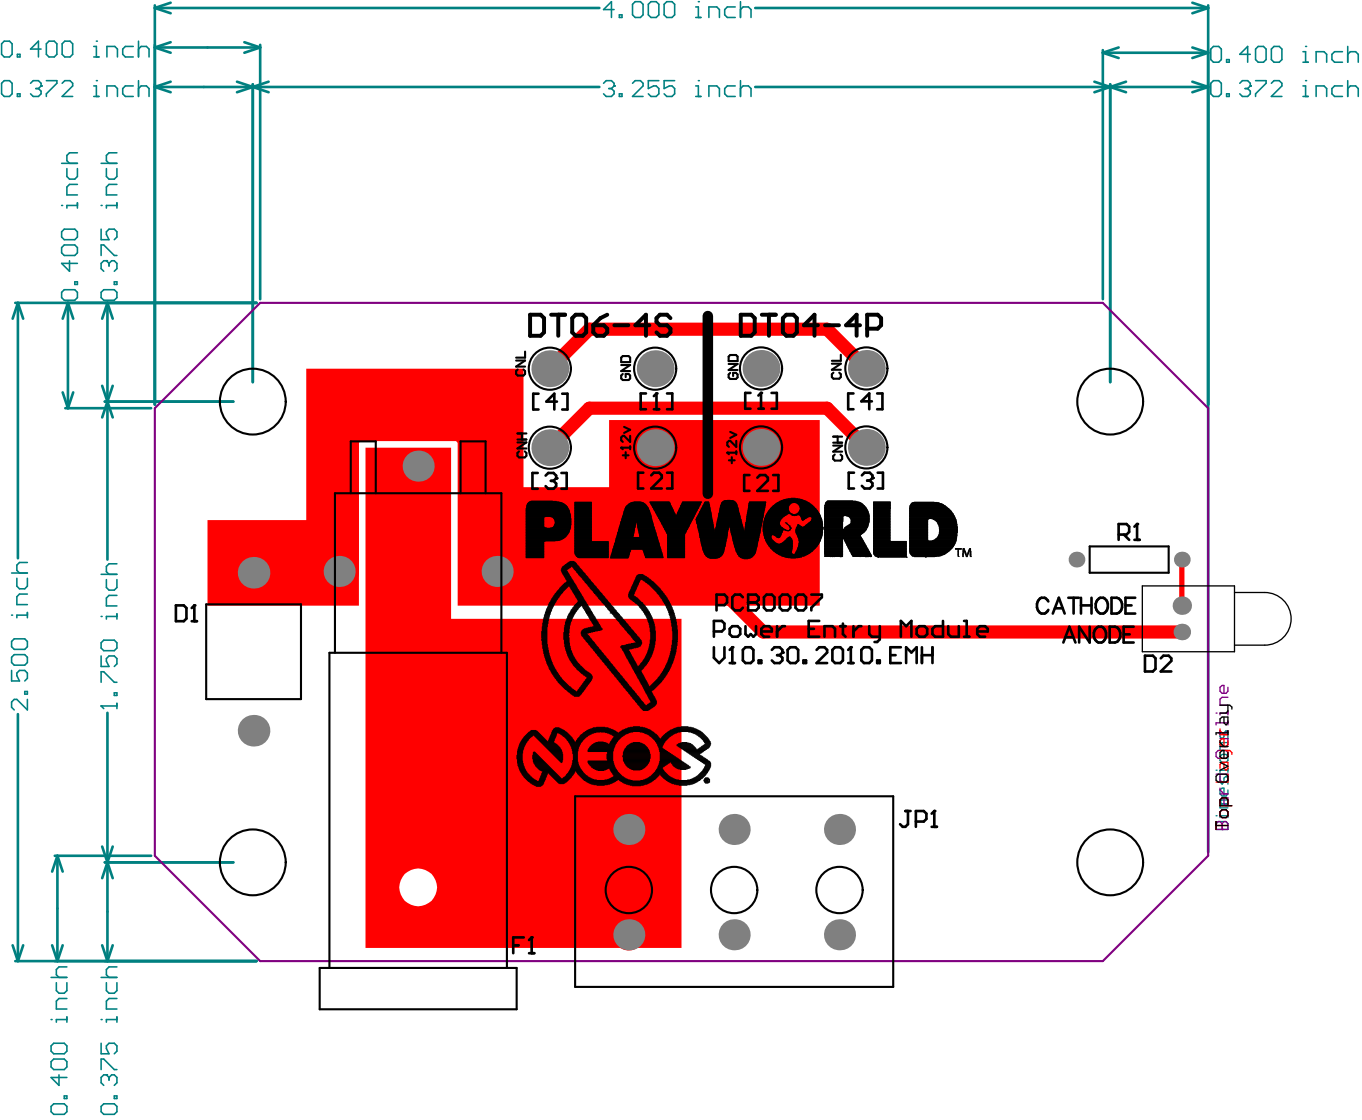
[picture p14: page 1]
