ehughes/NEOS_2ND_GENERATION/SCH/ELC0103 - Master & ELC104 - Slave/BUILD_PACKAGE/ELC0104_NEOS_SLAVE/PCB_PRINTS/PCB0008.pdf

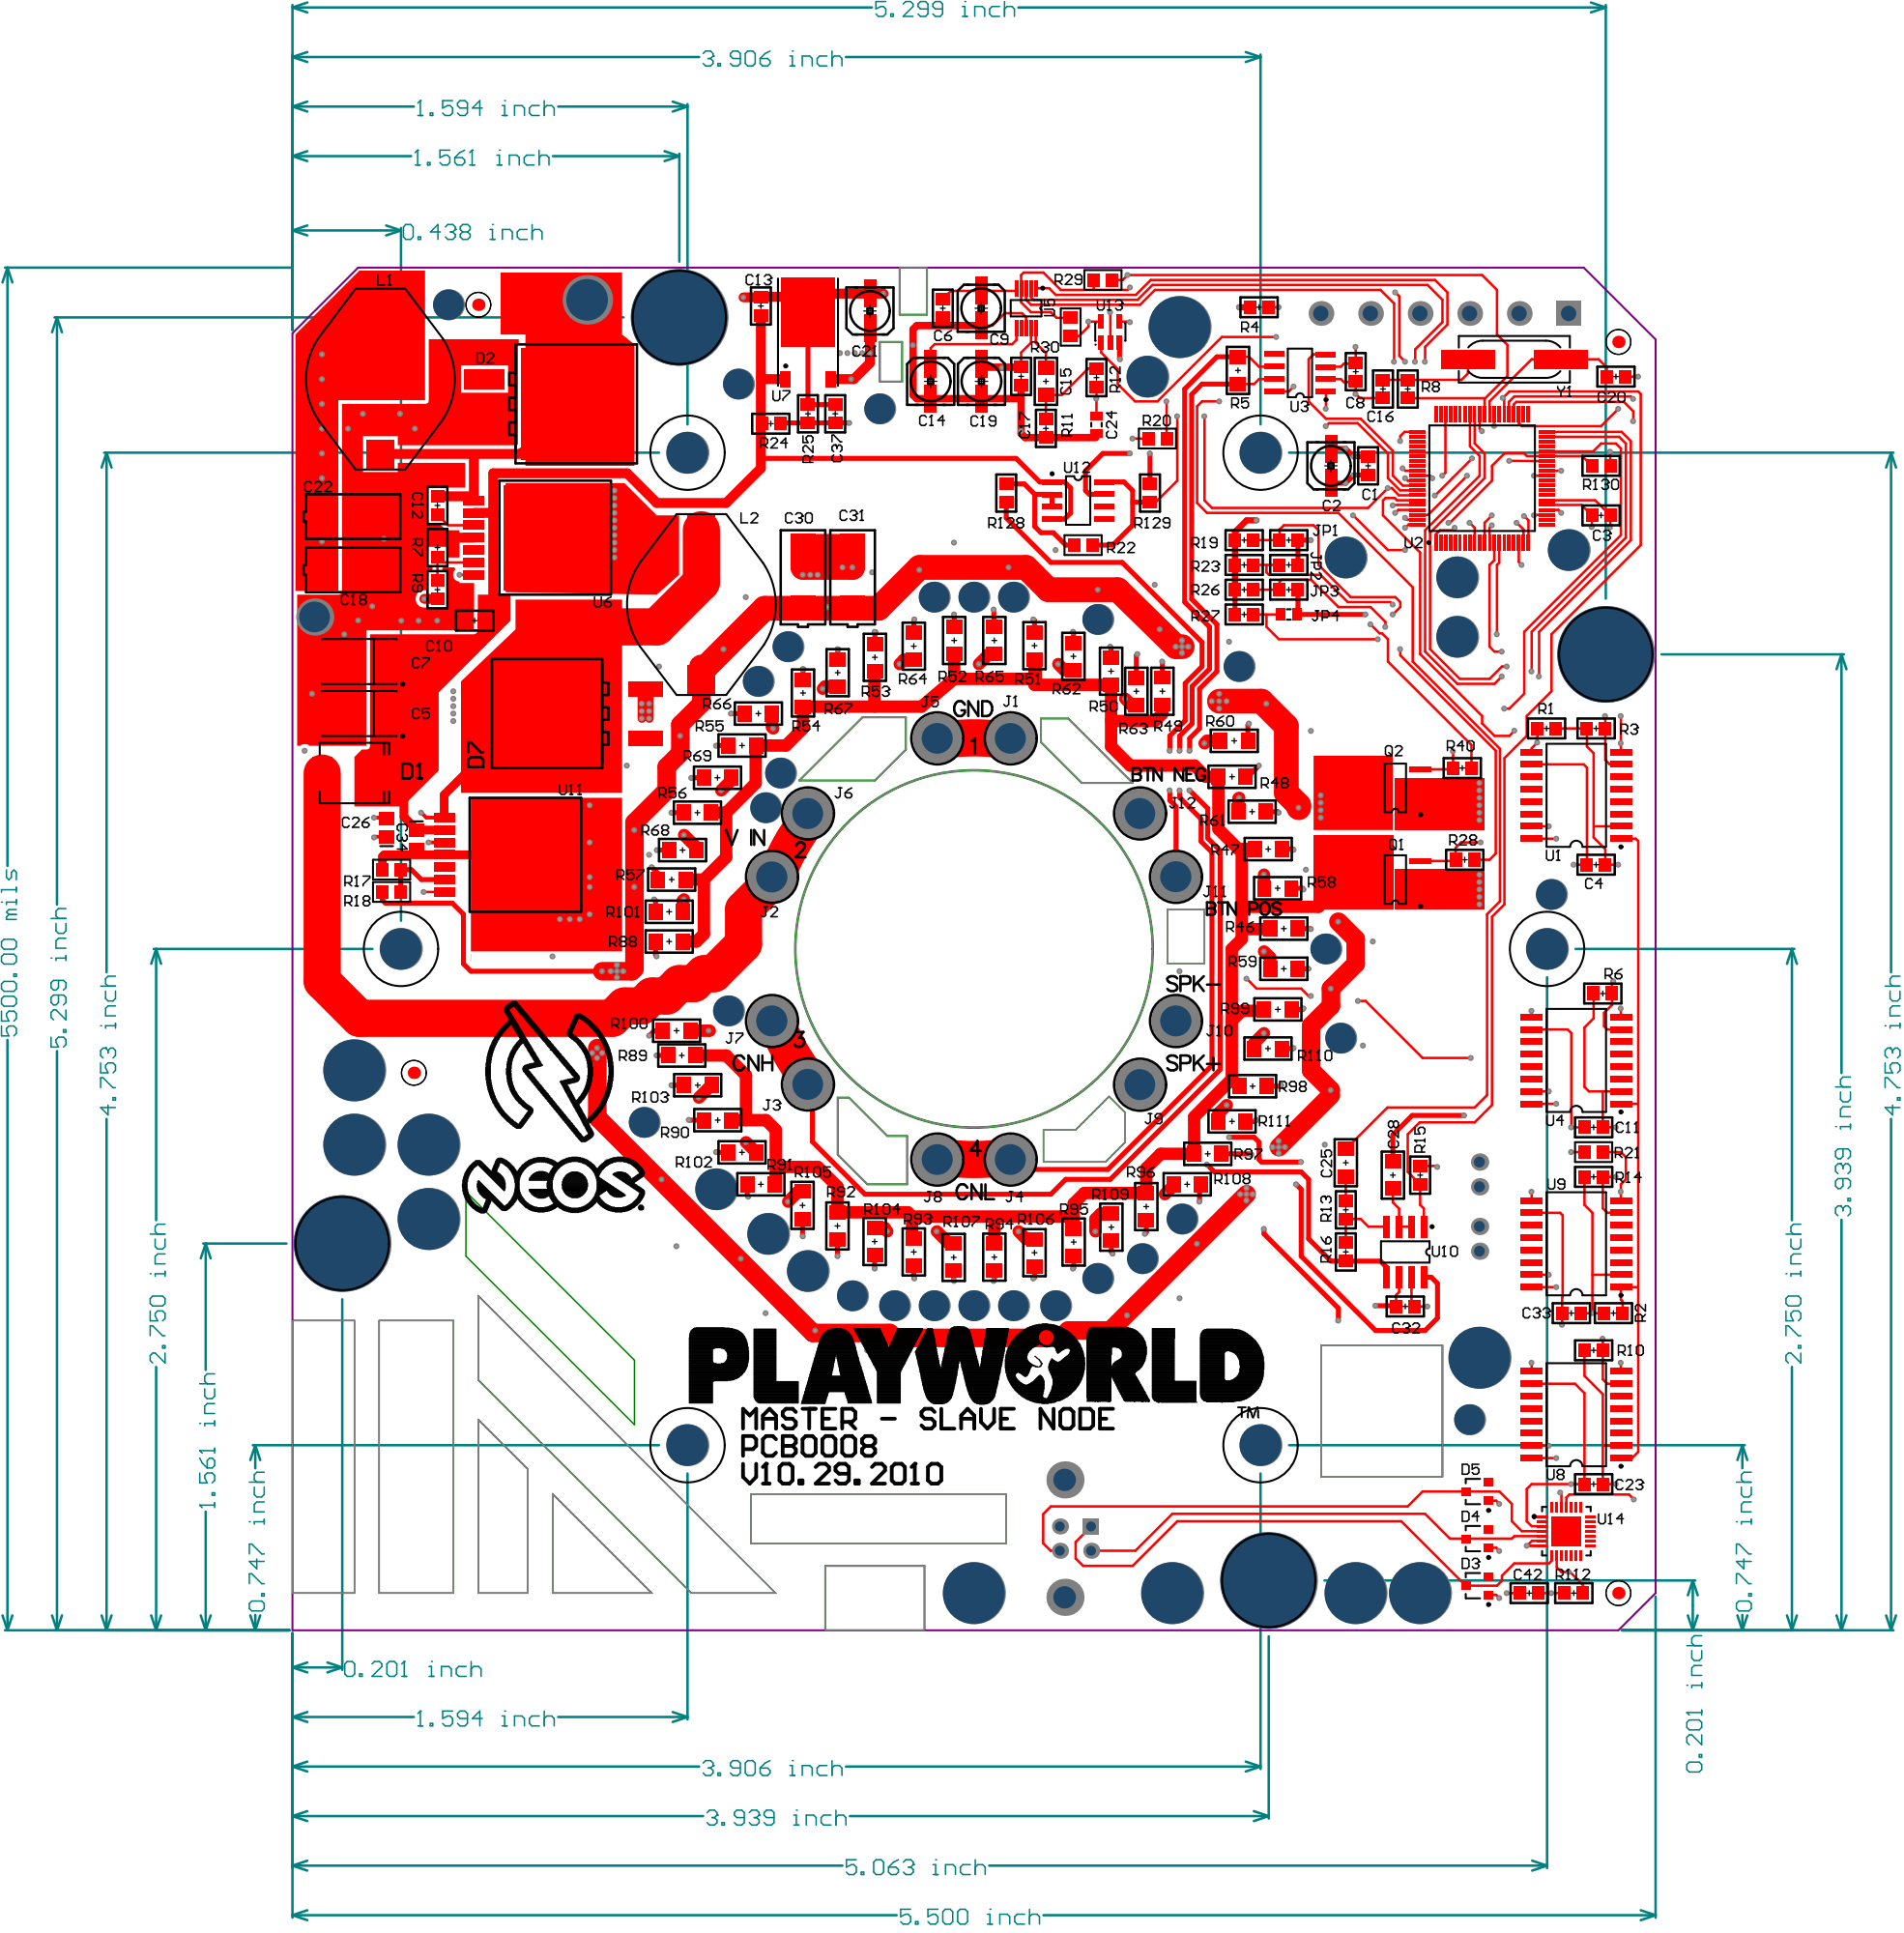
[picture p15: page 1]

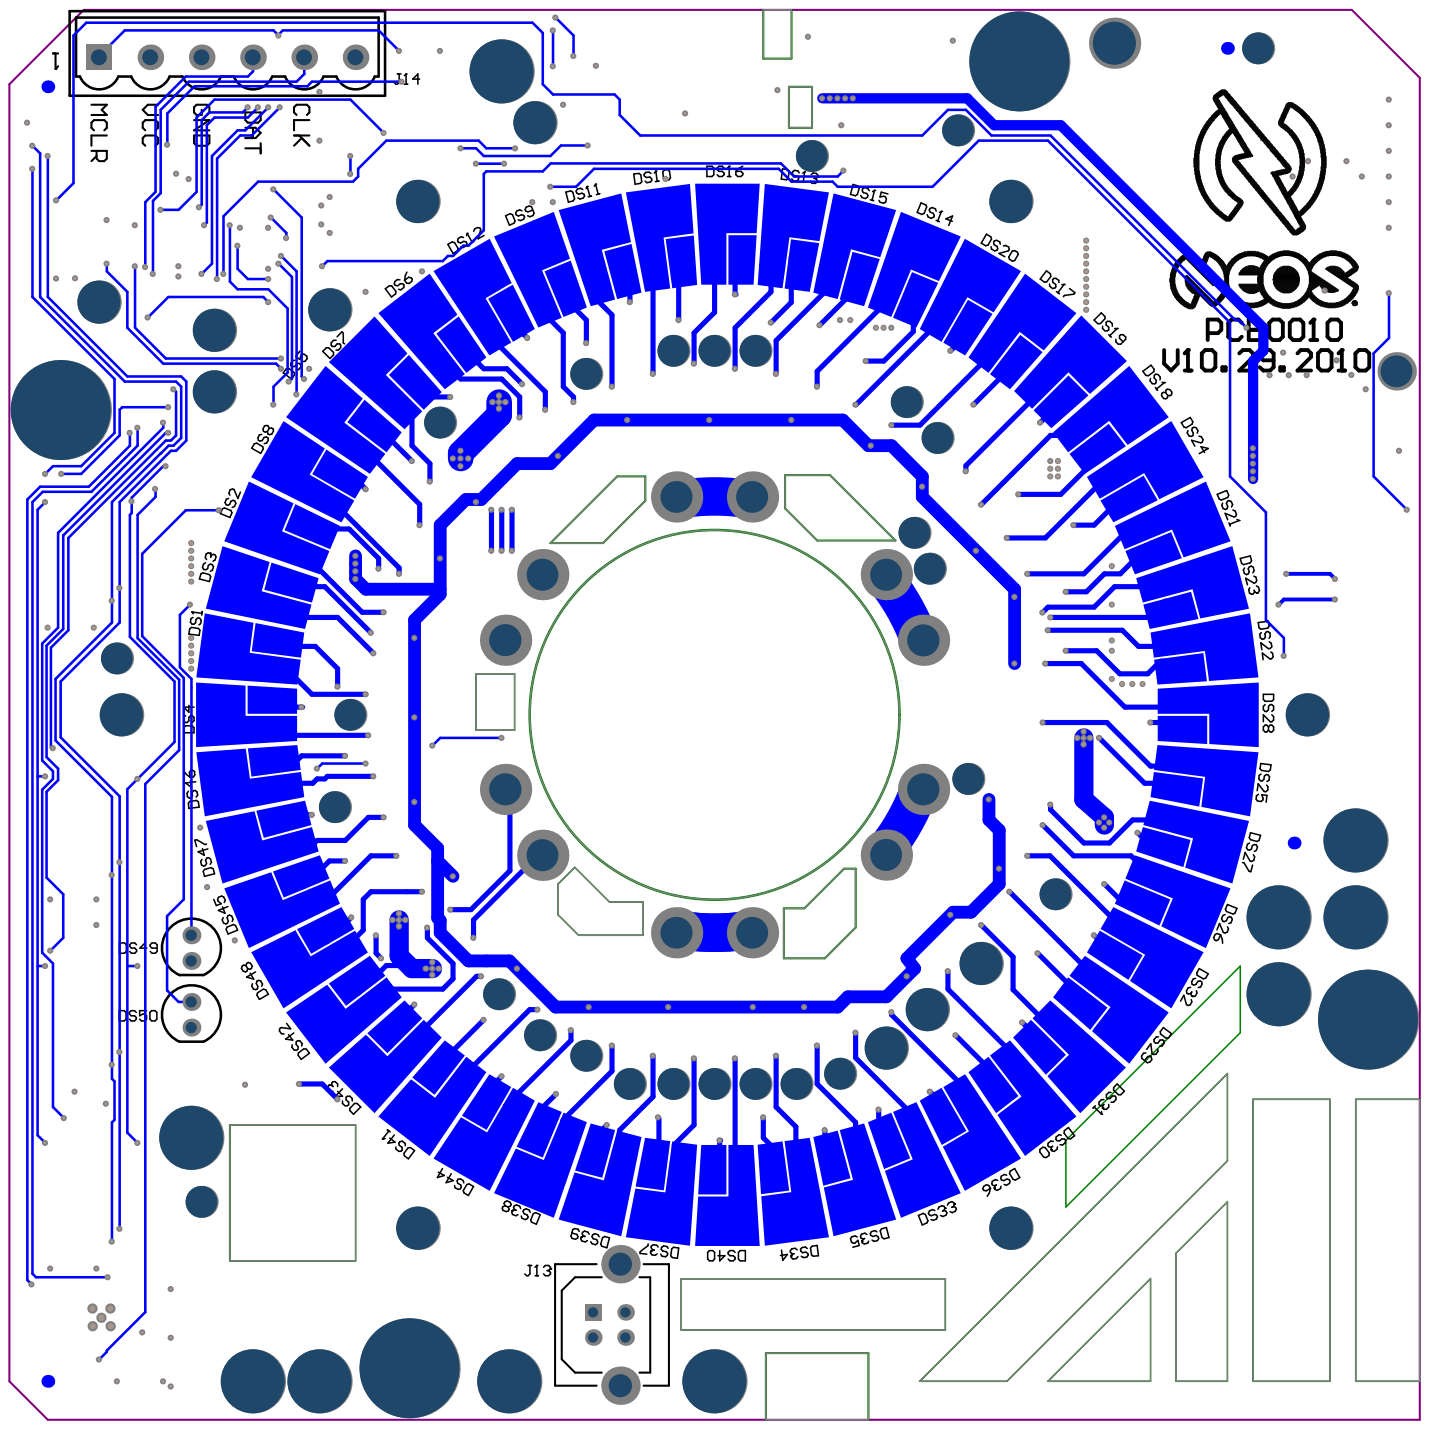
[picture p16: page 2]
