ehughes/NEOS_2ND_GENERATION/TOOLS/NEOS_CAN_ADAPTER/SCH/NEOS_CAN.pdf

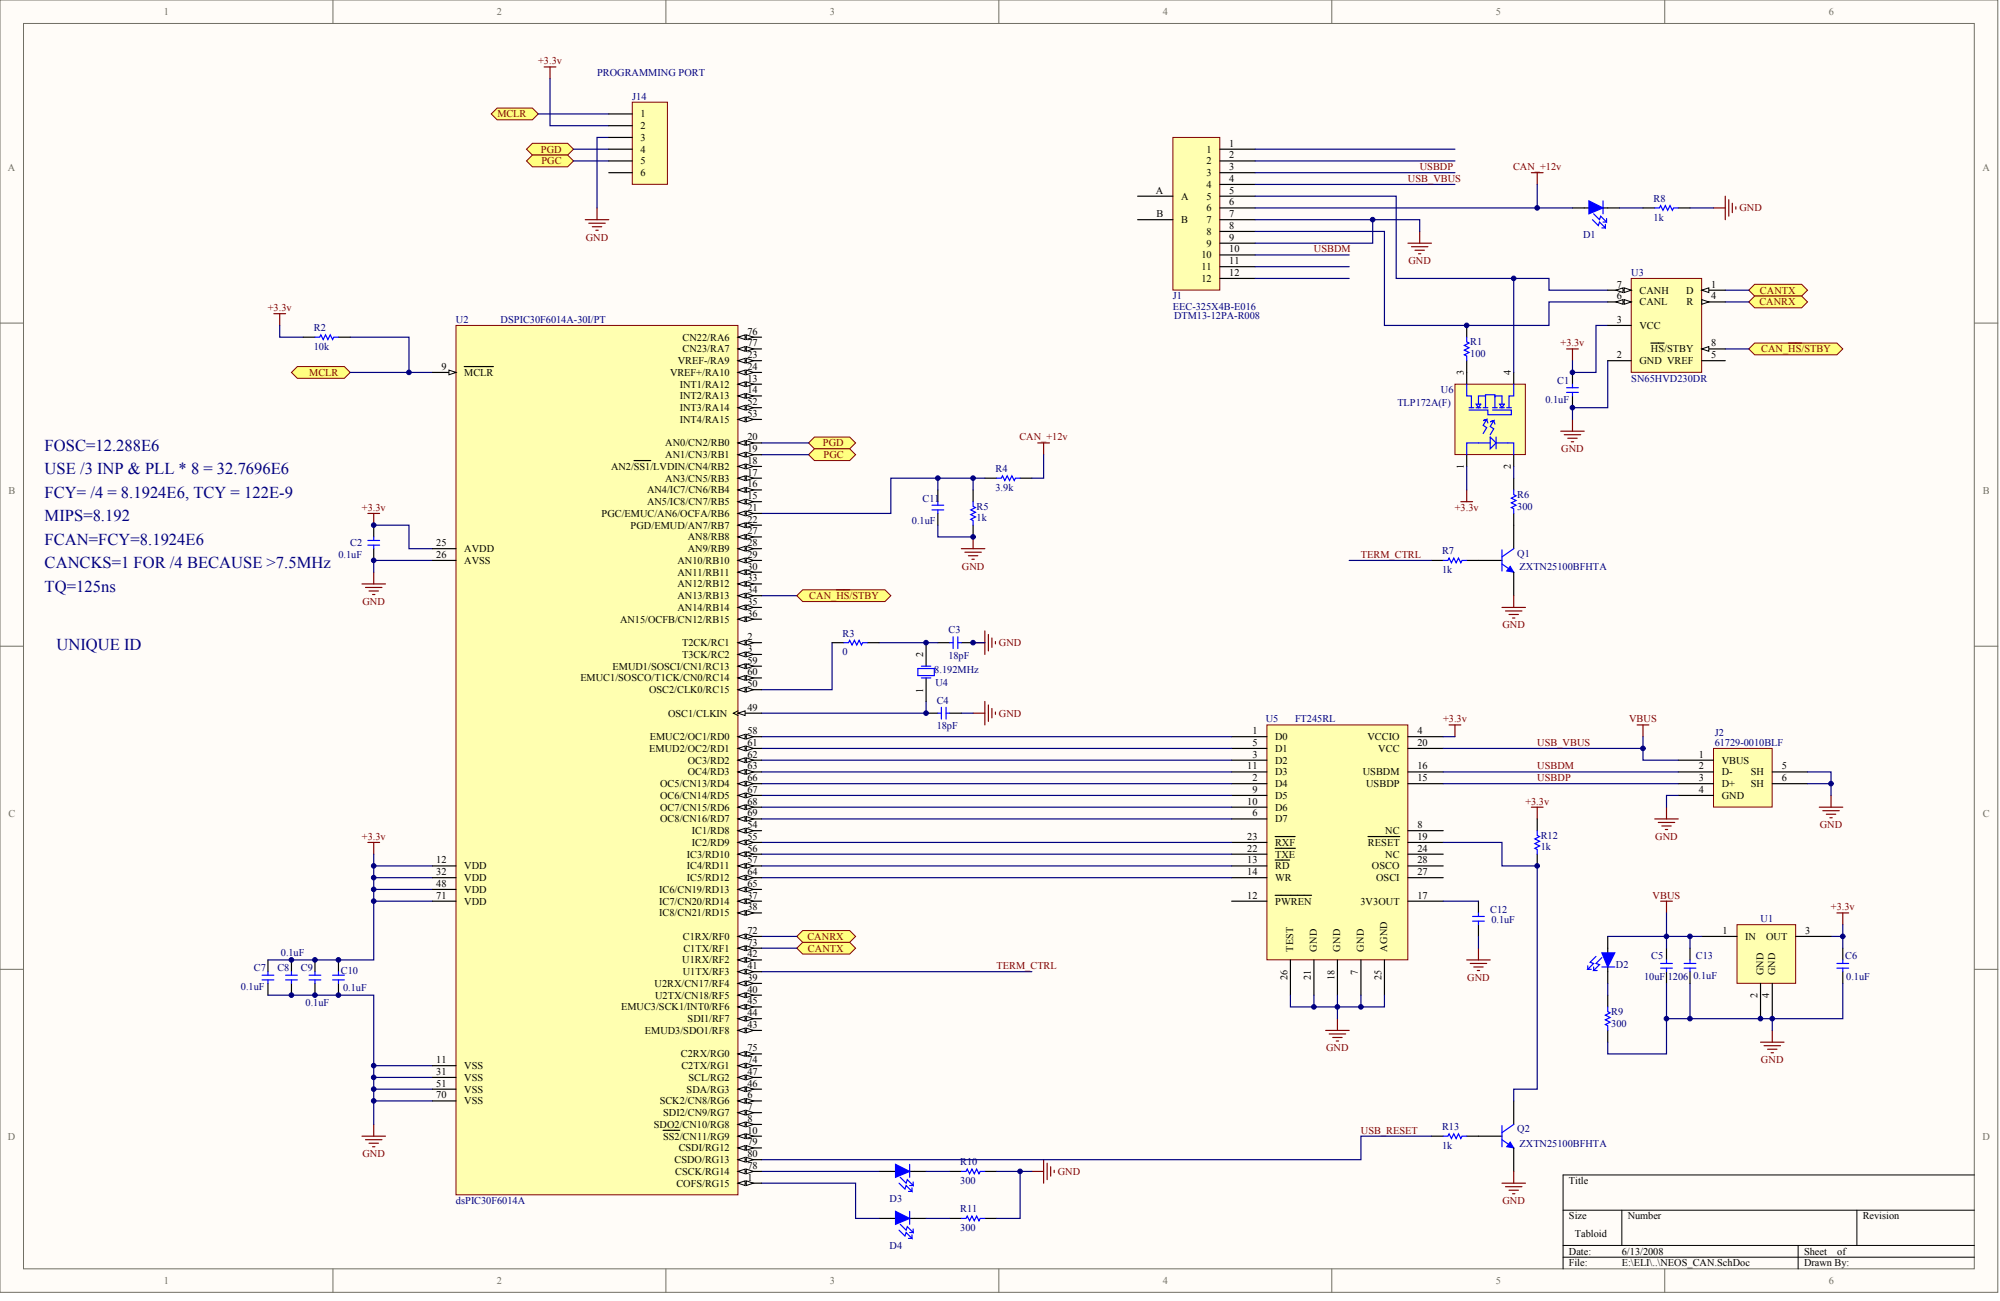
[picture p17: page 1]

P0J105 P0J105 P0J105 5
P0J106 P0J106 P0J106 6

P0J108 P0J108 P0J108 8
P0J109 P0J109 P0J109 9

P0U5011 | | USBDM 2 N0USBDM P0J202 P0U5016 P0J202 P0U5016 P0J202
2 P0U502 | P0U5015 | USBDP N0USBDP 3 P0J203 P0U5015 P0J203 P0U5015 P0J203 | P0J206 P0J206 P0J206 6
9 P0U509 | | 4

VDD 32 | P0U5014 | WR 14 P0U5027 P0U5027 P0U5027
VDD 48

0.1uF | VSS 11

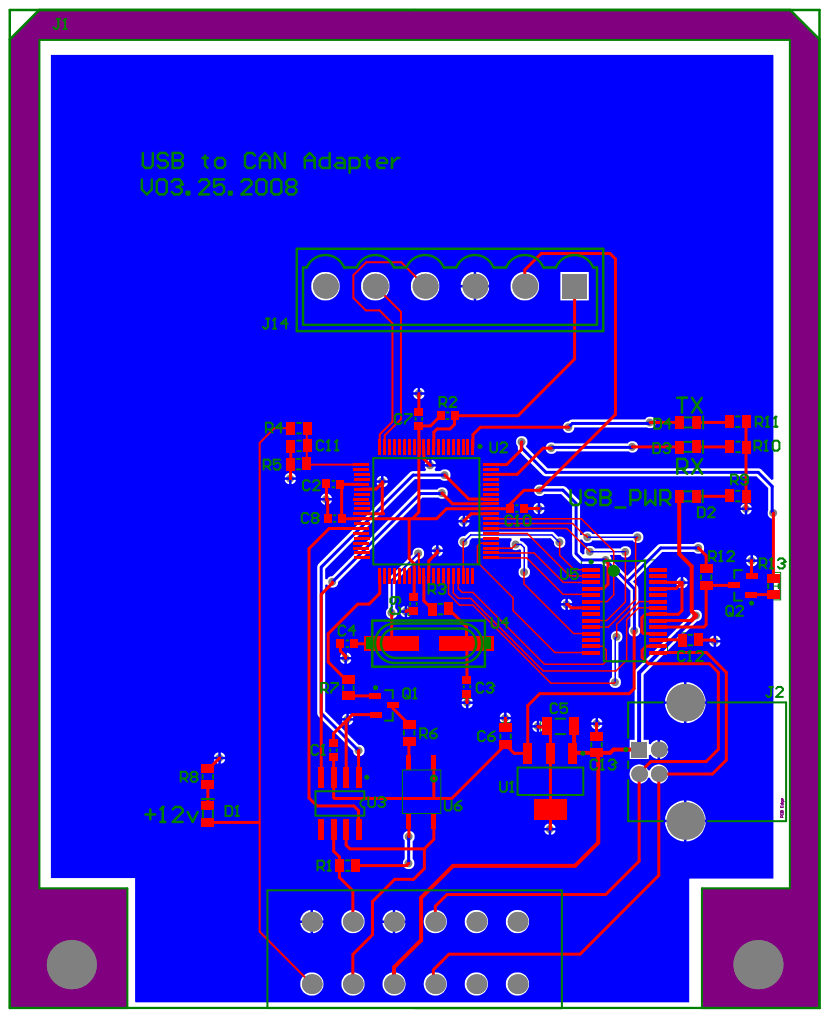
[picture p18: page 2]
