ehughes/NEOS_2ND_GENERATION/(list of files, drawings)

Other design files:
SCH/ELC0102 - Scoreboard/ELC0102 - Assembly Notes.SchDoc
SCH/ELC0102 - Scoreboard/ELC0102 - Green Digits.SchDoc
SCH/ELC0102 - Scoreboard/ELC0102 - Old Circuits.SchDoc
SCH/ELC0102 - Scoreboard/ELC0102 - Red Digits.SchDoc
SCH/ELC0102 - Scoreboard/ELC0102 - ScoreBoard - TopLevel.SchDoc
SCH/ELC0102 - Scoreboard/ELC0102 - Scoreboard.PrjPcb
SCH/ELC102 - Scoreboard/ELC102 - Scoreboard.PrjPcb
SCH/ELC0102 - Scoreboard/ELC0102 - Switch Interface.SchDoc
SCH/ELC0102 - Scoreboard/PCB0010 - Score Board.PcbDoc
SCH/ELC0103 - Master & ELC104 - Slave/ELC0103 - MasterBoard - Wiring.SchDoc
SCH/ELC0103 - Master & ELC104 - Slave/ELC0104 - SlaveBoard - Wiring.SchDoc
SCH/ELC0103 - Master & ELC104 - Slave/Master-Slave.SchDoc
SCH/ELC0103 - Master & ELC104 - Slave/NEOS Master-Slave.PrjPcb
SCH/ELC0103 - Master & ELC104 - Slave/NEOS Master-Slave.SchDoc
SCH/ELC0103 - Master & ELC104 - Slave/PCB0008.PcbDoc
SCH/ELC0205 - Power Entry Module/ELC0205 - Power Entry Module.PrjPCB
SCH/ELC0205 - Power Entry Module/ELC0205-Wiring.SchDoc
SCH/ELC0205 - Power Entry Module/ELC0205.PcbDoc
SCH/ELC0205 - Power Entry Module/ELC0205.SchDoc
SCH/ELC0205 - Power Entry Module/PCB0007.PcbDoc
TOOLS/ICD_ADAPTER/ICD_ADAPTER.PcbDoc
TOOLS/ICD_ADAPTER/ICD_ADAPTER.PrjPcb
TOOLS/ICD_ADAPTER/ICD_ADAPTER.SchDoc
TOOLS/NEOS_CAN_ADAPTER/SCH/C.SchDoc
TOOLS/NEOS_CAN_ADAPTER/SCH/NEOS_CAN1/NEOS_CAN1.PcbLib
TOOLS/NEOS_CAN_ADAPTER/SCH/NEOS_CAN1/NEOS_CAN.SCHLIB
TOOLS/NEOS_CAN_ADAPTER/SCH/NEOS_CAN1/PlayworldIC.PcbLib
TOOLS/NEOS_CAN_ADAPTER/SCH/NEOS_CAN.PcbDoc
TOOLS/NEOS_CAN_ADAPTER/SCH/NEOS_CAN.PcbLib
TOOLS/NEOS_CAN_ADAPTER/SCH/NEOS_CAN.PrjPcb
TOOLS/NEOS_CAN_ADAPTER/SCH/NEOS_CAN.SchDoc
TOOLS/NEOS_CAN_ADAPTER/SCH/WiringHarness.SchDoc
