ehughes/NEOS_2ND_GENERATION/SRC/PRODUCTION_RELEASE/MASTER/SHREK/SOUNDS/include/SoundMapping.h

#ifndef _SOUND_MAPPING_H
#define _SOUND_MAPPING_H


#define BUTTON1_1_WAV                                                 0
#define BUTTON1_1_WAV_LENGTH                                          226
#define BUTTON1_2_WAV                                                 1
#define BUTTON1_2_WAV_LENGTH                                          225
#define BUTTON1_3_WAV                                                 2
#define BUTTON1_3_WAV_LENGTH                                          226
#define BUTTON1_4_WAV                                                 3
#define BUTTON1_4_WAV_LENGTH                                          225
#define BUTTON2_1_WAV                                                 4
#define BUTTON2_1_WAV_LENGTH                                          236
#define BUTTON2_2_WAV                                                 5
#define BUTTON2_2_WAV_LENGTH                                          237
#define BUTTON2_3_WAV                                                 6
#define BUTTON2_3_WAV_LENGTH                                          237
#define BUTTON2_4_WAV                                                 7
#define BUTTON2_4_WAV_LENGTH                                          238
#define BUTTON3_1_WAV                                                 8
#define BUTTON3_1_WAV_LENGTH                                          301
#define BUTTON3_2_WAV                                                 9
#define BUTTON3_2_WAV_LENGTH                                          301
#define BUTTON3_3_WAV                                                 10
#define BUTTON3_3_WAV_LENGTH                                          301
#define BUTTON3_4_WAV                                                 11
#define BUTTON3_4_WAV_LENGTH                                          301
#define BUTTON4_1_WAV                                                 12
#define BUTTON4_1_WAV_LENGTH                                          401
#define BUTTON4_2_WAV                                                 13
#define BUTTON4_2_WAV_LENGTH                                          402
#define BUTTON4_3_WAV                                                 14
#define BUTTON4_3_WAV_LENGTH                                          401
#define BUTTON4_4_WAV                                                 15
#define BUTTON4_4_WAV_LENGTH                                          401
#define BELCH_WAV                                                     16
#define BELCH_WAV_LENGTH                                              78
#define FART_WAV                                                      17
#define FART_WAV_LENGTH                                               125
#define GETREADY_WAV                                                  18
#define GETREADY_WAV_LENGTH                                           157
#define MAGICMIRRORWELCOMETRACK_WAV                                   19
#define MAGICMIRRORWELCOMETRACK_WAV_LENGTH                            199
#define ONEMORECHANCE_WAV                                             20
#define ONEMORECHANCE_WAV_LENGTH                                      115
#define POSTIVECOMMENT_WAV                                            21
#define POSTIVECOMMENT_WAV_LENGTH                                     400
#define SENDOFF_WAV                                                   23
#define SENDOFF_WAV_LENGTH                                            75
#define STATION1_IDLE_WAV                                             24
#define STATION1_IDLE_WAV_LENGTH                                      2317
#define STATION2_IDLE_WAV                                             25
#define STATION2_IDLE_WAV_LENGTH                                      2750
#define STATION3_IDLE_WAV                                             26
#define STATION3_IDLE_WAV_LENGTH                                      3273
#define STATION4_IDLE_WAV                                             27
#define STATION4_IDLE_WAV_LENGTH                                      3773
#define STATIONID_1_WAV                                               28
#define STATIONID_1_WAV_LENGTH                                        141
#define STATIONID_2_WAV                                               29
#define STATIONID_2_WAV_LENGTH                                        132
#define STATIONID_3_WAV                                               30
#define STATIONID_3_WAV_LENGTH                                        140
#define STATIONID_4_WAV                                               31
#define STATIONID_4_WAV_LENGTH                                        138
#define TWOMORECHANCES_WAV                                            32
#define TWOMORECHANCES_WAV_LENGTH                                     143
#define WIN_WAV                                                       33
#define WIN_WAV_LENGTH                                                112
#define MM_FL_WELCOME_01A_WAV                                         34
#define MM_FL_WELCOME_01A_WAV_LENGTH                                  1064
#define MM_FL_WELCOME_01B_WAV                                         35
#define MM_FL_WELCOME_01B_WAV_LENGTH                                  1221
#define MM_FL_WELCOME_01C_WAV                                         36
#define MM_FL_WELCOME_01C_WAV_LENGTH                                  1344
#define MM_FL_WELCOME_01D_WAV                                         37
#define MM_FL_WELCOME_01D_WAV_LENGTH                                  1211
#define MM_FL_WELCOME_02B_WAV                                         38
#define MM_FL_WELCOME_02B_WAV_LENGTH                                  1121
#define MM_FL_WELCOME_03A_WAV                                         39
#define MM_FL_WELCOME_03A_WAV_LENGTH                                  1848
#define MM_FL_WELCOME_04B_WAV                                         40
#define MM_FL_WELCOME_04B_WAV_LENGTH                                  1761
#define MM_FL_WELCOME_04C_WAV                                         41
#define MM_FL_WELCOME_04C_WAV_LENGTH                                  1868
#define MM_FL_WELCOME_05A_WAV                                         42
#define MM_FL_WELCOME_05A_WAV_LENGTH                                  2108
#define MM_FL_WELCOME_06A_WAV                                         43
#define MM_FL_WELCOME_06A_WAV_LENGTH                                  2108
#define MM_FL_WELCOME_07A_WAV                                         44
#define MM_FL_WELCOME_07A_WAV_LENGTH                                  2082
#define MM_FL_WELCOME_08B_WAV                                         45
#define MM_FL_WELCOME_08B_WAV_LENGTH                                  1995
#define MM_FL_WELCOME_09A_WAV                                         46
#define MM_FL_WELCOME_09A_WAV_LENGTH                                  2409
#define MM_FL_WELCOME_09B_WAV                                         47
#define MM_FL_WELCOME_09B_WAV_LENGTH                                  2535
#define MM_FL_GETREADY_01A_WAV                                        48
#define MM_FL_GETREADY_01A_WAV_LENGTH                                 210
#define MM_FL_GETREADY_01B_WAV                                        49
#define MM_FL_GETREADY_01B_WAV_LENGTH                                 216
#define MM_FL_GETREADY_01C_WAV                                        50
#define MM_FL_GETREADY_01C_WAV_LENGTH                                 233
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
#define MM_FL_SENDOFF_07B_WAV                                         219
#define MM_FL_SENDOFF_07B_WAV_LENGTH                                  997
#define MM_FL_SENDOFF_07C_WAV                                         220
#define MM_FL_SENDOFF_07C_WAV_LENGTH                                  924
#define MM_FL_SENDOFF_07D_WAV                                         221
#define MM_FL_SENDOFF_07D_WAV_LENGTH                                  970


#endif
