ehughes/NEOS_2ND_GENERATION/SRC/DEVELOPMENT_RELEASE/MASTER/360/SOUNDS_JACKETS/SOUNDS/include/SoundMapping.h

#ifndef _SOUND_MAPPING_H
#define _SOUND_MAPPING_H


#define SELECTIONBUTTON_WAV                                           0
#define SELECTIONBUTTON_WAV_LENGTH                                    41
#define COUNTDOWN_WAV                                                 1
#define COUNTDOWN_WAV_LENGTH                                          254
#define BUTTONFEEDBACK_WAV                                            4
#define BUTTONFEEDBACK_WAV_LENGTH                                     62
#define ENDING_WAV                                                    5
#define ENDING_WAV_LENGTH                                             800
#define MAINTHEME_L_WAV                                               6
#define MAINTHEME_L_WAV_LENGTH                                        13217
#define MAINTHEME_LS_WAV                                              7
#define MAINTHEME_LS_WAV_LENGTH                                       13217
#define MAINTHEME_R_WAV                                               8
#define MAINTHEME_R_WAV_LENGTH                                        13217
#define MAINTHEME_RS_WAV                                              9
#define MAINTHEME_RS_WAV_LENGTH                                       13217
#define NODE0_WAV                                                     10
#define NODE0_WAV_LENGTH                                              83
#define NODE1_WAV                                                     11
#define NODE1_WAV_LENGTH                                              45
#define NODE2_WAV                                                     12
#define NODE2_WAV_LENGTH                                              53
#define NODE3_WAV                                                     13
#define NODE3_WAV_LENGTH                                              47
#define NODE4_WAV                                                     14
#define NODE4_WAV_LENGTH                                              95
#define NODE5_WAV                                                     15
#define NODE5_WAV_LENGTH                                              77
#define NODE6_WAV                                                     16
#define NODE6_WAV_LENGTH                                              40
#define NODE7_WAV                                                     17
#define NODE7_WAV_LENGTH                                              97
#define BONUSSOUND_WAV                                                18
#define BONUSSOUND_WAV_LENGTH                                         80
#define LIGHTGRABBERBACKGROUNDMUSIC_WAV                               19
#define LIGHTGRABBERBACKGROUNDMUSIC_WAV_LENGTH                        4800
#define LIGHTGRABBERBACKGROUNDMUSIC_BONUS_WAV                         20
#define LIGHTGRABBERBACKGROUNDMUSIC_BONUS_WAV_LENGTH                  999
#define LG_END_WAV                                                    21
#define LG_END_WAV_LENGTH                                             65
#define BALL_SERVE_WAV                                                31
#define BALL_SERVE_WAV_LENGTH                                         68
#define BALL_HIT_WAV                                                  32
#define BALL_HIT_WAV_LENGTH                                           24
#define BALL_BOUNCE_WAV                                               33
#define BALL_BOUNCE_WAV_LENGTH                                        10
#define ZIGZAGSFX1_WAV                                                34
#define ZIGZAGSFX1_WAV_LENGTH                                         74
#define ZIGZAGSFX2_WAV                                                35
#define ZIGZAGSFX2_WAV_LENGTH                                         69
#define ZIGZAGSFX3_WAV                                                36
#define ZIGZAGSFX3_WAV_LENGTH                                         60
#define ZIGZAGSFX4_WAV                                                37
#define ZIGZAGSFX4_WAV_LENGTH                                         59
#define ZIGZAGSFX5_WAV                                                38
#define ZIGZAGSFX5_WAV_LENGTH                                         59
#define ZIGZAGSFX6_WAV                                                39
#define ZIGZAGSFX6_WAV_LENGTH                                         60
#define ZIGZAGSFX7_WAV                                                40
#define ZIGZAGSFX7_WAV_LENGTH                                         55
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
#define NINJA_HUGEHIT_05_WAV                                          73
#define NINJA_HUGEHIT_05_WAV_LENGTH                                   194
#define NINJA_BADGONG_01_WAV                                          74
#define NINJA_BADGONG_01_WAV_LENGTH                                   147
#define RODEO_CRISSCROSS_01_WAV                                       80
#define RODEO_CRISSCROSS_01_WAV_LENGTH                                110
#define RODEO_SOLIDWALL_01_WAV                                        81
#define RODEO_SOLIDWALL_01_WAV_LENGTH                                 109
#define RODEO_TOPBOTTOM_01_WAV                                        82
#define RODEO_TOPBOTTOM_01_WAV_LENGTH                                 216
#define RODEOBACKGROUND_A_WAV                                         84
#define RODEOBACKGROUND_A_WAV_LENGTH                                  4691
#define RODEOBACKGROUND_B_WAV                                         85
#define RODEOBACKGROUND_B_WAV_LENGTH                                  4691
#define RODEOEND_WAV                                                  86
#define RODEOEND_WAV_LENGTH                                           105
#define MARATHON_INTRO_WAV                                            90
#define MARATHON_INTRO_WAV_LENGTH                                     457
#define MARATHON_LEVEL_FANFARE_WAV                                    91
#define MARATHON_LEVEL_FANFARE_WAV_LENGTH                             210
#define MARATHON_SECTION_1_WAV                                        92
#define MARATHON_SECTION_1_WAV_LENGTH                                 1371
#define MARATHON_SECTION_2_WAV                                        93
#define MARATHON_SECTION_2_WAV_LENGTH                                 1371
#define MARATHON_SECTION_3_WAV                                        94
#define MARATHON_SECTION_3_WAV_LENGTH                                 1371
#define MARATHON_SECTION_4_WAV                                        95
#define MARATHON_SECTION_4_WAV_LENGTH                                 1371
#define MARATHON_ENDING_FANFARE_WAV                                   96
#define MARATHON_ENDING_FANFARE_WAV_LENGTH                            279
#define MARATHON_JUMP_WAV                                             97
#define MARATHON_JUMP_WAV_LENGTH                                      25
#define MARATHON_HIT_WAV                                              98
#define MARATHON_HIT_WAV_LENGTH                                       11
#define BUZZER_WAV                                                    99
#define BUZZER_WAV_LENGTH                                             155
#define DDBACKGROUND_WAV                                              100
#define DDBACKGROUND_WAV_LENGTH                                       3918
#define DDBUTTONFX_WAV                                                101
#define DDBUTTONFX_WAV_LENGTH                                         1385
#define DDCORRECT_WAV                                                 102
#define DDCORRECT_WAV_LENGTH                                          94
#define DDINCORRECT_WAV                                               103
#define DDINCORRECT_WAV_LENGTH                                        14
#define DDEND_WAV                                                     104
#define DDEND_WAV_LENGTH                                              100
#define FF_BACKGROUND_WAV                                             110
#define FF_BACKGROUND_WAV_LENGTH                                      4896
#define FF_END_WAV                                                    111
#define FF_END_WAV_LENGTH                                             99
#define FIREFIGHTER_FIREAPPEAR_WAV                                    112
#define FIREFIGHTER_FIREAPPEAR_WAV_LENGTH                             96
#define FIREFIGHTER_FIREOUT_WAV                                       113
#define FIREFIGHTER_FIREOUT_WAV_LENGTH                                42
#define FIREFIGHTER_HIT_WAV                                           114
#define FIREFIGHTER_HIT_WAV_LENGTH                                    25
#define FIREFIGHTER_MISS_WAV                                          115
#define FIREFIGHTER_MISS_WAV_LENGTH                                   8
#define BUILDUP_A_WAV                                                 128
#define BUILDUP_A_WAV_LENGTH                                          1000
#define BUILDUP_B_WAV                                                 129
#define BUILDUP_B_WAV_LENGTH                                          1000
#define HEARTBEAT_WAV                                                 130
#define HEARTBEAT_WAV_LENGTH                                          234
#define GTR1A_WAV                                                     162
#define GTR1A_WAV_LENGTH                                              391
#define GTR1B_WAV                                                     163
#define GTR1B_WAV_LENGTH                                              242
#define GTR1C_WAV                                                     164
#define GTR1C_WAV_LENGTH                                              551
#define GTR2A_WAV                                                     165
#define GTR2A_WAV_LENGTH                                              404
#define GTR2B_WAV                                                     166
#define GTR2B_WAV_LENGTH                                              293
#define GTR2C_WAV                                                     167
#define GTR2C_WAV_LENGTH                                              391
#define GTR3A_WAV                                                     168
#define GTR3A_WAV_LENGTH                                              475
#define GTR3B_WAV                                                     169
#define GTR3B_WAV_LENGTH                                              491
#define ROCKBACKGROUND_WAV                                            174
#define ROCKBACKGROUND_WAV_LENGTH                                     4613


#endif
