ehughes/NEOS_2ND_GENERATION/SRC/PRODUCTION_RELEASE/MASTER/LIGHT_RING/SRC/__Game_RootGame0.c

#include "__Game_RootGame0.h"
#include "SystemVariables.h"
#include "_GameVariables.h"
#include "_RootButtonHandler.h"
#include "_GameProcess.h"
#include <stdlib.h>
#include "LED-Display.h"
#include "EEPROMRoutines.h"
#include "SystemUtilities.h"
#include "Audio.h"
#include "CanRoutines.h"
#include "DataTypes.h"
#include "SoundMapping.h"
#include "GameMapping.h"
#include "USB.h"
#include "InternalButtonSoundMapping.h"
#include "TimerRoutines.h"
#include "config.h"
#include "BoardSupport.h"


//*************************************************
//******** GAME STATE MACROS*** *******************
//*************************************************
#define WAIT1 					0x01
#define MAIN_SELECTOR			0x02
#define SELECT_TO_START_DELAY	0x03
#define COUNT_DOWN_TO_GAME 		0x04
#define SLEEP					0x05				
#define BOOT_DELAY				0x06
#define VOLUME_CHANGE_INIT	  	0x07
#define VOLUME_CHANGE		  	0x08
#define DISPLAY_GAME_COUNT	  	0x09

#define MUSIC_IDLE					0
#define MUSIC_MAIN_THEME			1


#define LIGHT_GRABBER_2P_BUTTON		5
#define START_BUTTON 				6

#define LIGHT_GRABBER_1P_BUTTON		10
#define DUCK_DUCK_GOOSE_BUTTON 		11
#define TEATHER_BALL_BUTTON			12
#define FLIP_FLOP_BUTTON 			13
#define JAM_CIRCLE_BUTTON 			14

#define TIME_TO_SLEEP				18000

//*************************************************
//******** System Timer MACROS*********************
//*************************************************

#define MAIN_GAME_TIMER					GPTimer[0]
#define COUNT_TIMER						GPTimer[1]
#define SELECT_TO_START_TIMER			GPTimer[2]
#define GAME_BUTTON_ANIMATION_TIMER		GPTimer[3]
#define SCORE_DISPLAY_ANIMATION_TIMER 	GPTimer[4]
#define START_BUTTON_ANIMATION_TIMER 	GPTimer[5]
#define SELECTOR_SPIN_ANIMATION_TIMER 	GPTimer[6]
#define MUSIC_TIMER					 	GPTimer[7]
#define SOUND_CHANNEL0_TIMER			GPTimer[8]
#define SOUND_CHANNEL1_TIMER			GPTimer[9]
#define VC_ENTRY_TIMER					GPTimer[10]
#define GC_ENTRY_TIMER					GPTimer[2]
#define VOLUME_CHANGE_TIMER				GPTimer[11]


//*************************************************
//*******Game Parameters***************************
//*************************************************

#define GAME_BUTTON_ANIMATION_TIME	     15
#define SCORE_DISPLAY_ANIMATION_TIME	 8
#define SELECTOR_SPIN_ANIMATION_TIME 	 8
#define START_BUTTON_ANIMATION_TIME		 8
#define HEARTBEAT_TIME				 	 HEARTBEAT_WAV_LENGTH * 30
#define VC_ENTRY_TIME					 150
#define GC_ENTRY_TIME					 100

//*************************************************
//******** AUDIO STREAM MAPPING *******************
//*************************************************
#define BACKGROUND_MUSIC_STREAM 0
#define MAINTHEME_L_STREAM		2
#define MAINTHEME_R_STREAM		3

//*************************************************
//*******Game Variables****************************
//*************************************************
  
 BYTE SelectorCircle[6] = {LIGHT_GRABBER_2P_BUTTON,
						  LIGHT_GRABBER_1P_BUTTON,
						  DUCK_DUCK_GOOSE_BUTTON,
						  TEATHER_BALL_BUTTON,
						  FLIP_FLOP_BUTTON,
						  JAM_CIRCLE_BUTTON,
	};					
						  
BYTE GameButtonSpin = 0;
BYTE SpinSeg1 = 0;
BYTE SpinSeg2 = 2;
BYTE Color1 =0;
BYTE Color2 =0;
BYTE PendingGameSelection =  LIGHT_GRABBER_1P_BUTTON;
WORD CountDownLength;
BYTE Count;
BYTE SelectorSpin = 0;
BYTE SelectState;
BYTE MusicState;

BYTE VolumeChangeEntrySequence [5] = {LIGHT_GRABBER_1P_BUTTON,FLIP_FLOP_BUTTON,LIGHT_GRABBER_2P_BUTTON,TEATHER_BALL_BUTTON,LIGHT_GRABBER_1P_BUTTON};
BYTE VolumeChangeEntrySequencePosition = 0;


BYTE GameCountEntrySequence [5] = {FLIP_FLOP_BUTTON,FLIP_FLOP_BUTTON,FLIP_FLOP_BUTTON,FLIP_FLOP_BUTTON,FLIP_FLOP_BUTTON};
BYTE GameCountEntrySequencePosition = 0;



#define TOP			0x01
#define UPPER_RIGHT 0x02
#define LOWER_RIGHT	0x04
#define BOTTOM		0x08
#define LOWER_LEFT	0x10	
#define UPPER_LEFT	0x20
#define CENTER		0x40


const BYTE SpinSegments[6] = {TOP,UPPER_RIGHT,LOWER_RIGHT,BOTTOM,LOWER_LEFT,UPPER_LEFT};
const BYTE SpinBig1[10]={TOP,0	,0	,0			,0			,0		,0		,BOTTOM	,LOWER_LEFT	,UPPER_LEFT};
const BYTE SpinBig2[10]={0	,TOP,0	,0			,0			,0		,BOTTOM ,0		,0			,0		   };
const BYTE SpinBig3[10]={0  ,0	,TOP,UPPER_RIGHT,LOWER_RIGHT,BOTTOM ,0		,0		,0			,0		   };	


BOOL IntroMusicOn = FALSE;
#define NO_MATCH	0xFF


#define NUM_SOUND_CHANNELS	2
#define NUM_SOUND_EFFECTS	12

struct {
	
		BOOL Active;
		DWORD CurrentSoundLength;
		WORD ButtonAssignment;
	
}	LRSoundChannelInfo[NUM_SOUND_CHANNELS];	

struct{
	
	WORD Index[NUM_SOUND_EFFECTS];
	DWORD Length[NUM_SOUND_EFFECTS];
	
} LightRingSoundEffect ;


//*************************************************
//*******Game Helper Function Declarations*********
//*************************************************

void StartCountDown();
void UpdateGameSettings();
void PlayCountDown();
void StartMainThemeMusic();
void AnimateGameButtons();
void AnimateScoreDisplay();
void SelectorButtonSpin();
void PlaySelectorSound();
void MusicWake();


void SelectorPlayButtonFeebackSound();
void CheckSoundEffectChannels();
void InitLightRingSoundEffects();
void InitSoundEffectChannels();
BYTE LRMatchButtonToActiveSoundChannel(BYTE button);
BYTE LRGetNextSoundChannel(BYTE button);
void LRResetSoundChannelTimer(BYTE  Channel);
void PlayLightRingSoundEffect(BYTE button);
void MoveToMainSelector();
void MoveToSleep();
void Game0PlayButtonFeebackSound(BYTE Volume, BYTE Repeats);
void MoveToVolumeChange();
BOOL CheckVolumeChangeEntrySequence(BYTE button);
BOOL CheckGameCountEntrySequence(BYTE button);
void MoveToGameCountDisplay();


//*************************************************
//*******Game Functions****************************
//*************************************************

void Root_Game0 (void)
{
			
	switch (GameState)
	{
		
		case INIT:
			RED_LED_OFF;
			GREEN_LED_ON;
			
			ResetAudioAndLEDS();
		
			ScoreManagerEnabled = FALSE;
			SpinSeg1 = 0;
			SpinSeg2 = 2;
			Color1 =0;
			Color2 =0;
			ScoreSendLights(248,  1<<(PendingGameSelection),0x0);
			MusicState = MUSIC_IDLE;
			InitSoundEffectChannels();
			InitLightRingSoundEffects();
			CurrentGameSettings.GameSoundEffectVolume = 0xFF;
			CurrentGameSettings.GameBackgroundMusicVolume = 0xFF;
	
			GameState = BOOT_DELAY;
			
			GAME_BUTTON_ANIMATION_TIMER = 0;
			MAIN_GAME_TIMER = 0;
			SCORE_DISPLAY_ANIMATION_TIMER=0;
			SELECTOR_SPIN_ANIMATION_TIMER=0;
			START_BUTTON_ANIMATION_TIMER=0;
			
			CurrentGameSettings.GameBackgroundMusicVolume = ((WORD)(0xC8)*(WORD)(AudioGlobalVolume))>>8;
			CurrentGameSettings.GameSoundEffectVolume = 	((WORD)(0xFF)*(WORD)(AudioGlobalVolume))>>8;
					
		break;
		
		case BOOT_DELAY:
		
			if(MAIN_GAME_TIMER >100)
			{
				MusicWake();
				
				MAIN_GAME_TIMER = 0;	
				GameState = MAIN_SELECTOR;
			}
		
		break;

		
		case SLEEP:
		break;
		
		
		
		case MAIN_SELECTOR:
			
			
			if(MAIN_GAME_TIMER > TIME_TO_SLEEP)
			{
				MoveToSleep();		
			}
				
			switch(MusicState)
			{
				case MUSIC_IDLE:
				break;
				
				case MUSIC_MAIN_THEME:
					if(MUSIC_TIMER > (LIGHTRINGMAINTHEME_L_WAV_LENGTH - 75))
					{
						MusicState = MUSIC_IDLE;
						AudioOffAllNodes();
					}
				break;
				
			
				
				default:
					MusicState = MUSIC_IDLE;
				break;
					
				
			}
			
			CheckSoundEffectChannels();
			AnimateGameButtons();
			AnimateScoreDisplay();
				
			
		break;
		
			
		case SELECT_TO_START_DELAY:
		//This state was added to ensure that the coundown dsound happens.   If the 1 or 2p start happens right after a selector
		//button press, the count down wont happen.  THis is because the selector sound is played with internal sounds now.  
		//The coundown sound sound is stream.  When playing internal sounds, the buttons ignore stream commands.  So there has to be
		//at least a delay of the Selector sound length before attemping count down.
		
		if(SELECT_TO_START_TIMER>SELECTIONBUTTON_WAV_LENGTH+1)
		{
			StartCountDown();
			PlayCountDown();
		}
		
		break;
			
		case COUNT_DOWN_TO_GAME:
		
		
		if(COUNT_TIMER > CountDownLength/3)
		{
			Count--;
			COUNT_TIMER = 0;
			switch(Count)
			{
				case 3:
					if(GamePlayers == 2)
					{
						LEDSendDigits(DISPLAY_ADDRESS, 0xFF ,3,BLANK_DIGIT,BLANK_DIGIT, 3,BLANK_DIGIT, BLANK_DIGIT);
					}
					else
					{
						LEDSendDigits(DISPLAY_ADDRESS, 0xFF ,3,BLANK_DIGIT,BLANK_DIGIT, BLANK_DIGIT,BLANK_DIGIT, BLANK_DIGIT);
					}
				break;	
				
				case 2:
					if(GamePlayers == 2)
					{
						LEDSendDigits(DISPLAY_ADDRESS, 0xFF ,BLANK_DIGIT,2,BLANK_DIGIT,BLANK_DIGIT,2,BLANK_DIGIT);
					}
					else
					{
						LEDSendDigits(DISPLAY_ADDRESS, 0xFF ,BLANK_DIGIT,2,BLANK_DIGIT,BLANK_DIGIT,BLANK_DIGIT,BLANK_DIGIT);	
					}
				break;
				
				case 1:
					if(GamePlayers == 2)
					{
						LEDSendDigits(DISPLAY_ADDRESS, 0xFF ,BLANK_DIGIT,BLANK_DIGIT,1,BLANK_DIGIT,BLANK_DIGIT,1);
					}
					else
					{
						LEDSendDigits(DISPLAY_ADDRESS, 0xFF ,BLANK_DIGIT,BLANK_DIGIT,1,BLANK_DIGIT,BLANK_DIGIT,BLANK_DIGIT);
					}
				break;
				
				
				case 0:
				default:
					if(GamePlayers == 2)
					{
						LEDSendDigits(DISPLAY_ADDRESS, 0xFF ,BLANK_DIGIT,BLANK_DIGIT,0,BLANK_DIGIT,BLANK_DIGIT,0);
					}
					else
					{
						LEDSendDigits(DISPLAY_ADDRESS, 0xFF ,BLANK_DIGIT,BLANK_DIGIT,0,BLANK_DIGIT,BLANK_DIGIT,BLANK_DIGIT);
					}
				break;
					
			}
			
		}
		
		if(MAIN_GAME_TIMER>CountDownLength)
			{
				GameState = INIT;
		
				LEDSendScores(DISPLAY_ADDRESS,0xFF , BLANK_SCORE,BLANK_SCORE);		
				Player1Score = 0;
				Player2Score = 0;		
				InitRandomButton();	
				switch(PendingGameSelection)
				{
								
					case LIGHT_GRABBER_1P_BUTTON:
						GamePlayers = 1;
						GameSelected = GAME_LIGHT_GRABBER;
					break;
				
					case LIGHT_GRABBER_2P_BUTTON:
						GamePlayers =2 ;
						GameSelected = GAME_LIGHT_GRABBER;
					break;
					
					case TEATHER_BALL_BUTTON:
						GamePlayers = 1;
						GameSelected = GAME_TEATHERBALL;
					break;
				
					case FLIP_FLOP_BUTTON:
						GamePlayers =1;
						GameSelected = GAME_FLIP_FLOP;
					break;
					
					case JAM_CIRCLE_BUTTON:
						GamePlayers =1;
						GameSelected = GAME_JAM_CIRCLE;
					break;
				
					case DUCK_DUCK_GOOSE_BUTTON:
						GamePlayers =1;
						GameSelected = GAME_DUCKDUCKGOOSE;
					break;
				
				
					default:
						GameSelected = GAME_ROOT_GAME0;
					break;
							
				}
				
				UpdateGameSettings();
			
				if(GameCount >= 999999)
				{
					GameCount = 999999;	
				}		
				else
				{
					GameCount++;
					StoreGameCount();	
				}	
				
			}
		
			
		break;
	
		
			case VOLUME_CHANGE_INIT:
		
		if(MAIN_GAME_TIMER > 25)
		{
			Game0PlayButtonFeebackSound(0xFF,1);
			LEDSendVariable(DISPLAY_VOL, AudioGlobalVolumeIndex);
			GameState = VOLUME_CHANGE;
			MAIN_GAME_TIMER = 0xFFFF;
			VOLUME_CHANGE_TIMER = 0;
			SelectState = 0;
		}
		
		break;	
		
		
		case VOLUME_CHANGE:
		
			if(VOLUME_CHANGE_TIMER>1000)
			{
				GameState = INIT;		
				
			}	
			if(MAIN_GAME_TIMER > 50)
			{
				MAIN_GAME_TIMER= 0;
				if(SelectState)
				{
					ScoreSendLights(248, (1<<LIGHT_GRABBER_1P_BUTTON),0x0);
					SelectState = 0;
					
				}
				else
				{
					ScoreSendLights(248, (1<<FLIP_FLOP_BUTTON),0x0);
					SelectState = 1;
					
				}
			}
		break;
		
		
			
		case DISPLAY_GAME_COUNT:
		
			if(MAIN_GAME_TIMER > 1000)
			{
				GameState = INIT;	
			}	
			
		break;
	
	
		
		default:
		GameState = INIT;
		break;
		
	}
}


void AnimateScoreDisplay()
{
		if(SCORE_DISPLAY_ANIMATION_TIMER > SCORE_DISPLAY_ANIMATION_TIME)
		{
			SCORE_DISPLAY_ANIMATION_TIMER = 0;
	  		CANQueueTxMessage(0x70,248+(0xFF<<8),SpinBig1[SpinSeg1]+(SpinBig2[SpinSeg1]<<8),SpinBig3[SpinSeg1]+(SpinBig1[SpinSeg2]<<8),SpinBig2[SpinSeg2]+(SpinBig3[SpinSeg2]<<8));
		   	SpinSeg1++;if(SpinSeg1>9)SpinSeg1=0;
		   	SpinSeg2--;if(SpinSeg2>9)SpinSeg2=9;
	   }			 
	
}	


void AnimateGameButtons()
{
	if(GAME_BUTTON_ANIMATION_TIMER > GAME_BUTTON_ANIMATION_TIME)
	{
		GAME_BUTTON_ANIMATION_TIMER = 0;
		
		GameButtonSpin += 1;
	   	
	   	if(GameButtonSpin == NUM_BUTTONS)
	   	{
		   GameButtonSpin = 0;	
		 }
		
	
		Color1++;
	   	Color1 &= 0x3f;
	   	if(Color1==0)
	   	{
		 	Color2++;
		 	Color2&=0x3F;
		}
	   	LEDSendMessage(GameButtonSpin, Color1,Color2,0, LEDOFF, 60, 50);	
	 }			 	
	
}	


void MoveToSleep()
{
	CANQueueTxMessage(0x70,248,0,0,0);
	AudioOffAllNodes();	
	ScoreSendLights(248,  0x0,0x0);
	CANQueueTxMessage(0x70,248,0,0,0);
	
	GameState = SLEEP;		
}	

void OnButtonPressRootGame0(unsigned char button)
{
	
	switch(GameState)
	{
		case SLEEP:
			
			MoveToMainSelector();
			MusicState = MUSIC_IDLE;
			MusicWake();
			ScoreSendLights(248,  1<<(PendingGameSelection),0x0);
			
		break;
		
		case MAIN_SELECTOR:
		
			if(MusicState == MUSIC_IDLE)
			{
				MusicWake();
			}
			else
			{
				PlayLightRingSoundEffect(button);	
				MAIN_GAME_TIMER = 0;
			}
		break;
			
		default:
		break;	
		
	}

		
}

void MoveToMainSelector()
{
	PendingGameSelection =  LIGHT_GRABBER_1P_BUTTON;
	 ScoreSendLights(248,  1<<(PendingGameSelection),0x0);
	GameState = MAIN_SELECTOR;
	
}	

void OnMasterSwitchPressRootGame0(void)
{
	AudioNodeEnable(ENABLE_ALL,3,1,1,0,BUTTONFEEDBACK_WAV_LENGTH,0xFF,0xFF);
	SendNodeNOP();
	EAudioPlaySound(3,BUTTONFEEDBACK_WAV);
}




void OnSelectPressRootGame0(unsigned char button)
{
	
	switch(GameState)
	{
		case SLEEP:
			MoveToMainSelector();
			MAIN_GAME_TIMER = 0;
			MusicState = MUSIC_IDLE;
			MusicWake();
			if(button == START_BUTTON)
			{
				button = LIGHT_GRABBER_1P_BUTTON;	
				
			}
			PendingGameSelection = button;
			ScoreSendLights(248,  1<<(PendingGameSelection),0x0);
			
		break;
		
		case DISPLAY_GAME_COUNT:
			
			ResetToGameSelector();
			
		break;
		
			case VOLUME_CHANGE:
		
			VOLUME_CHANGE_TIMER = 0;
			
			switch(button)
			{
				case LIGHT_GRABBER_1P_BUTTON:
				
					if(AudioGlobalVolumeIndex < GLOBAL_VOLUME_INDEX_MAX)
					{
						AudioGlobalVolumeIndex++;
					}
					
					LEDSendVariable(DISPLAY_VOL, AudioGlobalVolumeIndex);
					AudioGlobalVolume = VolumeIndexTable[AudioGlobalVolumeIndex];
					Game0PlayButtonFeebackSound(AudioGlobalVolume, 1);
				
				break;
				
				case FLIP_FLOP_BUTTON:
				
					if(AudioGlobalVolumeIndex > GLOBAL_VOLUME_INDEX_MIN)
					{
						AudioGlobalVolumeIndex--;
					}
					
					LEDSendVariable(DISPLAY_VOL, AudioGlobalVolumeIndex);
					AudioGlobalVolume = VolumeIndexTable[AudioGlobalVolumeIndex];
					Game0PlayButtonFeebackSound(AudioGlobalVolume, 1);
				
				break;
				
				default:
				EEStoreVariable(AUDIO_VOLUME_INDEX_LOCATION,  AudioGlobalVolumeIndex);
				ResetToGameSelector();
				break;				
				
				
			}
		break;
		
		case MAIN_SELECTOR:

				if(CheckVolumeChangeEntrySequence(button) == TRUE) { MoveToVolumeChange(); return; }
				if(CheckGameCountEntrySequence(button) == TRUE) { MoveToGameCountDisplay(); return; }
	
				switch(button)
				{
					case START_BUTTON:
						GameState = SELECT_TO_START_DELAY; // added to make sure countdown sound happens
						SELECT_TO_START_TIMER = 0;
					break;
		
					default:
					
						MusicWake();
						MAIN_GAME_TIMER = 0;
						PendingGameSelection = button;
						PlaySelectorSound();
					    ScoreSendLights(248,  1<<(PendingGameSelection),0x0);
					break;
				}

		break;	
		
		default:
		break;
		
	}
			
	  

}	


void MusicWake()
{
	MAIN_GAME_TIMER = 0;
	
	switch(MusicState)
		{
			case MUSIC_IDLE:
				MusicState = MUSIC_MAIN_THEME;
				StartMainThemeMusic();
			break;
			
			default:
			break;
		}	
}	

void PlaySelectorSound()
{
	PlayInternalNodeSound(0,INTERNAL_SOUND_SELECTION,CurrentGameSettings.GameSoundEffectVolume,1,MAINTHEME_L_STREAM	,CurrentGameSettings.GameBackgroundMusicVolume,1);
	PlayInternalNodeSound(2,INTERNAL_SOUND_SELECTION,CurrentGameSettings.GameSoundEffectVolume,1,MAINTHEME_L_STREAM	,CurrentGameSettings.GameBackgroundMusicVolume,1);
	PlayInternalNodeSound(4,INTERNAL_SOUND_SELECTION,CurrentGameSettings.GameSoundEffectVolume,1,MAINTHEME_L_STREAM	,CurrentGameSettings.GameBackgroundMusicVolume,1);
	
	SELECT_TO_START_TIMER = 0;
}



void StartCountDown()
{
		GameState = COUNT_DOWN_TO_GAME;
		CountDownLength = 190;
		MAIN_GAME_TIMER = 0;
		COUNT_TIMER = 0xFFFF;
		Count = 4;
}	

void PlayCountDown()
{
	AudioNodeEnable(ENABLE_ALL,BACKGROUND_MUSIC_STREAM,BACKGROUND_MUSIC_STREAM,1,0,CountDownLength,CurrentGameSettings.GameSoundEffectVolume,0x00);
	SendNodeNOP();				
	EAudioPlaySound( BACKGROUND_MUSIC_STREAM,COUNTDOWN_WAV);	
}	


void UpdateGameSettings()
{
	
	switch (GameSelected)
	{
		case GAME_LIGHT_GRABBER:
		
			CurrentGameSettings.GameBackgroundMusicVolume = ((WORD)(0xFF)*(WORD)(AudioGlobalVolume))>>8;;
			CurrentGameSettings.GameSoundEffectVolume =		 ((WORD)(0xFF)*(WORD)(AudioGlobalVolume))>>8;;
			CurrentGameSettings.FinaleMusicVolume = ((WORD)(0xC0)*(WORD)(AudioGlobalVolume))>>8;;
			
		break;
		
		
	 	case GAME_JAM_CIRCLE:
		
			CurrentGameSettings.GameBackgroundMusicVolume = ((WORD)(0x50)*(WORD)(AudioGlobalVolume))>>8;;
			CurrentGameSettings.GameSoundEffectVolume = ((WORD)(0xFF)*(WORD)(AudioGlobalVolume))>>8;;
			CurrentGameSettings.FinaleMusicVolume = ((WORD)(0xA0)*(WORD)(AudioGlobalVolume))>>8;;
			
		break;
		
		case GAME_DUCKDUCKGOOSE:
		
			CurrentGameSettings.GameBackgroundMusicVolume = ((WORD)(0x60)*(WORD)(AudioGlobalVolume))>>8;;
			CurrentGameSettings.GameSoundEffectVolume = 	((WORD)(0xFF)*(WORD)(AudioGlobalVolume))>>8;;
			CurrentGameSettings.FinaleMusicVolume = 		((WORD)(0xA0)*(WORD)(AudioGlobalVolume))>>8;;
			
		break;
		
	
		default:
			CurrentGameSettings.GameBackgroundMusicVolume = ((WORD)(0xFF)*(WORD)(AudioGlobalVolume))>>8;;
			CurrentGameSettings.GameSoundEffectVolume = 	((WORD)(0xFF)*(WORD)(AudioGlobalVolume))>>8;;
			CurrentGameSettings.FinaleMusicVolume = 		((WORD)(0xC0)*(WORD)(AudioGlobalVolume))>>8;;
			
		break;
	}
	
}	


void StartMainThemeMusic()
{
	MusicState = MUSIC_MAIN_THEME;
	MUSIC_TIMER = 0;
	
	AudioNodeEnable(0,MAINTHEME_L_STREAM,MAINTHEME_L_STREAM,AUDIO_ON_BEFORE_TIMEOUT,LIGHTRINGMAINTHEME_L_WAV_LENGTH,CurrentGameSettings.GameBackgroundMusicVolume,0x00);
	SendNodeNOP();	
	AudioNodeEnable(1,MAINTHEME_L_STREAM,MAINTHEME_L_STREAM,AUDIO_ON_BEFORE_TIMEOUT,LIGHTRINGMAINTHEME_L_WAV_LENGTH,CurrentGameSettings.GameBackgroundMusicVolume,0x00);
	SendNodeNOP();	
	
	AudioNodeEnable(2,MAINTHEME_L_STREAM,MAINTHEME_L_STREAM,AUDIO_ON_BEFORE_TIMEOUT,LIGHTRINGMAINTHEME_L_WAV_LENGTH,CurrentGameSettings.GameBackgroundMusicVolume,0x00);
	SendNodeNOP();	
	AudioNodeEnable(3,MAINTHEME_R_STREAM,MAINTHEME_R_STREAM,AUDIO_ON_BEFORE_TIMEOUT,LIGHTRINGMAINTHEME_R_WAV_LENGTH,CurrentGameSettings.GameBackgroundMusicVolume,0x0);
	
	AudioNodeEnable(4,MAINTHEME_R_STREAM,MAINTHEME_R_STREAM,AUDIO_ON_BEFORE_TIMEOUT,LIGHTRINGMAINTHEME_R_WAV_LENGTH,CurrentGameSettings.GameBackgroundMusicVolume,0x0);
	SendNodeNOP();	
	AudioNodeEnable(5,MAINTHEME_R_STREAM,MAINTHEME_R_STREAM,AUDIO_ON_BEFORE_TIMEOUT,LIGHTRINGMAINTHEME_R_WAV_LENGTH,CurrentGameSettings.GameBackgroundMusicVolume,0x0);
	SendNodeNOP();	

	
	EAudioPlaySound(MAINTHEME_L_STREAM	,LIGHTRINGMAINTHEME_L_WAV);
	EAudioPlaySound(MAINTHEME_R_STREAM	,LIGHTRINGMAINTHEME_R_WAV);
	
		

}	





void InitLightRingSoundEffects()
{

	LightRingSoundEffect.Index[0] = RINGSE0_WAV;
	LightRingSoundEffect.Index[1] = RINGSE1_WAV;
	LightRingSoundEffect.Index[2] = RINGSE2_WAV;
	LightRingSoundEffect.Index[3] = RINGSE3_WAV;
	LightRingSoundEffect.Index[4] = RINGSE4_WAV;
	LightRingSoundEffect.Index[5] = RINGSE5_WAV;
	LightRingSoundEffect.Index[6] = RINGSE6_WAV;
	LightRingSoundEffect.Index[7] = RINGSE7_WAV;
	LightRingSoundEffect.Index[8] = RINGSE8_WAV;
	LightRingSoundEffect.Index[9] = RINGSE9_WAV;
	LightRingSoundEffect.Index[10] = RINGSE10_WAV;
	LightRingSoundEffect.Index[11] = RINGSE11_WAV;
	
	
	
	LightRingSoundEffect.Length[0] = RINGSE0_WAV_LENGTH;
	LightRingSoundEffect.Length[1] = RINGSE1_WAV_LENGTH;
	LightRingSoundEffect.Length[2] = RINGSE2_WAV_LENGTH;
	LightRingSoundEffect.Length[3] = RINGSE3_WAV_LENGTH;
	LightRingSoundEffect.Length[4] = RINGSE4_WAV_LENGTH;
	LightRingSoundEffect.Length[5] = RINGSE5_WAV_LENGTH;
	LightRingSoundEffect.Length[6] = RINGSE6_WAV_LENGTH;
	LightRingSoundEffect.Length[7] = RINGSE7_WAV_LENGTH;
	LightRingSoundEffect.Length[8] = RINGSE8_WAV_LENGTH;
	LightRingSoundEffect.Length[9] = RINGSE9_WAV_LENGTH;
	LightRingSoundEffect.Length[10] = RINGSE10_WAV_LENGTH;
	LightRingSoundEffect.Length[11] = RINGSE11_WAV_LENGTH;
	
	
}	

void InitSoundEffectChannels()
{
	BYTE i;
	
	for(i=0;i<NUM_SOUND_CHANNELS;i++)
	{
		LRSoundChannelInfo[i].Active=FALSE;
		LRSoundChannelInfo[i].CurrentSoundLength=0;
		LRSoundChannelInfo[i].ButtonAssignment=0;
		
	}
	
}		

void CheckSoundEffectChannels()
{
	
			if((SOUND_CHANNEL0_TIMER > LRSoundChannelInfo[0].CurrentSoundLength) && (LRSoundChannelInfo[0].Active == TRUE))
			{
				LRSoundChannelInfo[0].Active = FALSE;
				
				AudioReSync(LRSoundChannelInfo[0].ButtonAssignment);
			}
			
			if((SOUND_CHANNEL1_TIMER > LRSoundChannelInfo[0].CurrentSoundLength) && (LRSoundChannelInfo[1].Active == TRUE) )
			{
				LRSoundChannelInfo[1].Active = FALSE;
				AudioReSync(LRSoundChannelInfo[1].ButtonAssignment);
			}
			/*
			if((SOUND_CHANNEL2_TIMER > LRSoundChannelInfo[0].CurrentSoundLength) && (LRSoundChannelInfo[2].Active == TRUE))
			{
				LRSoundChannelInfo[2].Active = FALSE;
				AudioReSync(SoundChannelInfo[2].ButtonAssignment);
			}*/
			
}	


BYTE LRMatchButtonToActiveSoundChannel(BYTE button)
{
	BYTE i;
	
	for(i=0;i<NUM_SOUND_CHANNELS;i++)
	{
		if(LRSoundChannelInfo[i].Active == TRUE)
		{
			if(LRSoundChannelInfo[i].ButtonAssignment == button)
			{
				return i;	
			}
			
		}
	}
	
	return NO_MATCH;
}	

BYTE LRGetNextSoundChannel(BYTE button)
{
	BYTE Temp;
	BYTE i;
	
	Temp = LRMatchButtonToActiveSoundChannel(button);
	
	
	//if the button already has a sound channel mapped , just reuse it
	if(Temp != NO_MATCH)
	{
		return i;
	}
	
	Temp = NO_MATCH;
	
	for(i=0;i<NUM_SOUND_CHANNELS;i++)
	{
		if(LRSoundChannelInfo[i].Active == FALSE)
		{
			return i;
		}	
	}
	
	//if we are here then all channels are used up.  Just pick a Random one
	
	return (rand()%NUM_SOUND_CHANNELS);

}	


void LRResetSoundChannelTimer(BYTE  Channel)
{
		switch(Channel)
		{
			case 0:
				SOUND_CHANNEL0_TIMER =0; 
			break;
			
			case 1:
				SOUND_CHANNEL1_TIMER =0;
			break;
			
			case 2:
			//	SOUND_CHANNEL2_TIMER =0;
			break;
			
			default:
			break;	
			
		}
}	



void PlayLightRingSoundEffect(BYTE button)
{
BYTE RandomIndex;
BYTE BackgroundSwitchStream;
BYTE SoundChannelTemp;


	LEDSendMessage(button, YELLOW, LEDOFF, 50, 50);

		//See if this button alread has a sound
		
		if(button<3)
		{
			BackgroundSwitchStream = MAINTHEME_L_STREAM;	
		}
		else
		{
			BackgroundSwitchStream = MAINTHEME_R_STREAM;
		}
		
		RandomIndex = rand()%NUM_SOUND_EFFECTS;
		
		
		SoundChannelTemp = LRMatchButtonToActiveSoundChannel(button);
			
		
		if(SoundChannelTemp!=NO_MATCH)
		{
			//if the button already maps to a sound, then just start a new one at the same button
			
			LRSoundChannelInfo[SoundChannelTemp].Active = TRUE;
			LRSoundChannelInfo[SoundChannelTemp].ButtonAssignment = button;
			LRSoundChannelInfo[SoundChannelTemp].CurrentSoundLength = LightRingSoundEffect.Length[RandomIndex];
			
			LRResetSoundChannelTimer(SoundChannelTemp);
			
			AudioNodeEnable(button,SoundChannelTemp,BackgroundSwitchStream,1,1,LRSoundChannelInfo[SoundChannelTemp].CurrentSoundLength,CurrentGameSettings.GameSoundEffectVolume,CurrentGameSettings.GameBackgroundMusicVolume);
			SendNodeNOP();	
			EAudioPlaySound(SoundChannelTemp,LightRingSoundEffect.Index[RandomIndex]);
			
		}
		else
		{
			SoundChannelTemp = LRGetNextSoundChannel(button);
		
			//First Turn off the old button (if there is one)
			
			if(LRSoundChannelInfo[SoundChannelTemp].Active == TRUE)
			{
			//	AudioNodeEnable(SoundChannelInfo[SoundChannelTemp].ButtonAssignment,BACKGROUND_MUSIC_STREAM,BACKGROUND_MUSIC_STREAM,AUDIO_ON_BEFORE_TIMEOUT,ROCKBACKGROUND_WAV_LENGTH,CurrentGameSettings.GameBackgroundMusicVolume,0);
			
			}
			
			LRSoundChannelInfo[SoundChannelTemp].Active = TRUE;
			LRSoundChannelInfo[SoundChannelTemp].ButtonAssignment = button;
			
			LRSoundChannelInfo[SoundChannelTemp].CurrentSoundLength = LightRingSoundEffect.Length[RandomIndex];
			
			LRResetSoundChannelTimer(SoundChannelTemp);
			
			AudioNodeEnable(button,SoundChannelTemp,BackgroundSwitchStream,1,1,LRSoundChannelInfo[SoundChannelTemp].CurrentSoundLength,CurrentGameSettings.GameSoundEffectVolume,CurrentGameSettings.GameBackgroundMusicVolume);
			SendNodeNOP();	
			EAudioPlaySound(SoundChannelTemp,LightRingSoundEffect.Index[RandomIndex]);
			
			
			
		}
		
}	

BOOL CheckVolumeChangeEntrySequence(BYTE button)
{
	BOOL RetVal = FALSE;
	

	
	switch(VolumeChangeEntrySequencePosition)
	{
		
		case 0:
			if(button == VolumeChangeEntrySequence[VolumeChangeEntrySequencePosition])
			{
				VolumeChangeEntrySequencePosition++;
				VC_ENTRY_TIMER = 0;
				RetVal = FALSE;
			}
		break;
		
		case 1:
		case 2:
		case 3:
		case 4:
		
			if((button == VolumeChangeEntrySequence[VolumeChangeEntrySequencePosition])  && (VC_ENTRY_TIMER<VC_ENTRY_TIME))
			{
				VolumeChangeEntrySequencePosition++;
				
					if(VolumeChangeEntrySequencePosition == 5)
					{
						RetVal = TRUE;	
					}
					else
					{
						VC_ENTRY_TIMER = 0;
						RetVal = FALSE;
					}
			}
			else
			{
				VolumeChangeEntrySequencePosition = 0;
				VC_ENTRY_TIMER = 0;
				RetVal = FALSE;	
			}
		break;
		
		default:
			VolumeChangeEntrySequencePosition = 0;	
			VC_ENTRY_TIMER = 0;
			RetVal = FALSE;
		break;	
		
		
	}
	
	return RetVal;
	
}		
	
BOOL CheckGameCountEntrySequence(BYTE button)
{
	BOOL RetVal = FALSE;
	

	switch(GameCountEntrySequencePosition)
	{
		
		case 0:
			if(button == GameCountEntrySequence[GameCountEntrySequencePosition])
			{
				GameCountEntrySequencePosition++;
				GC_ENTRY_TIMER = 0;
				RetVal = FALSE;
			}
		break;
		
		case 1:
		case 2:
		case 3:
		case 4:
		
			if((button == GameCountEntrySequence[GameCountEntrySequencePosition])  && (GC_ENTRY_TIMER<GC_ENTRY_TIME))
			{
			GameCountEntrySequencePosition++;
				
					if(GameCountEntrySequencePosition == 5)
					{
						RetVal = TRUE;	
					}
					else
					{
						GC_ENTRY_TIMER = 0;
						RetVal = FALSE;
					}
			}
			else
			{
				GameCountEntrySequencePosition = 0;
				GC_ENTRY_TIMER = 0;
				RetVal = FALSE;	
			}
		break;
		
		default:
			GameCountEntrySequencePosition = 0;	
			GC_ENTRY_TIMER = 0;
			RetVal = FALSE;
		break;	
		
		
	}
	
	return RetVal;
	
}			
	
void MoveToVolumeChange()
{
	ResetAudioAndLEDS();
	GameState = VOLUME_CHANGE_INIT;
	MAIN_GAME_TIMER = 0;
	
}	

void MoveToGameCountDisplay()
{

	GameState = DISPLAY_GAME_COUNT;
	DisplayGameCount();
	Game0PlayButtonFeebackSound(AudioGlobalVolume, 1);
	MAIN_GAME_TIMER = 0;
	
}
	
void Game0PlayButtonFeebackSound(BYTE Volume, BYTE Repeats)
{

  PlayInternalNodeSound(0xFF,INTERNAL_SOUND_POSITIVE_FEEDBACK,Volume,Repeats,0,0,0);

}	

	
	
