ehughes/NEOS_2ND_GENERATION/SRC/PRODUCTION_RELEASE/MASTER/SHREK/SRC/__Game_Ninja.c

#include "__Game_Ninja.h"
#include "SystemVariables.h"
#include "_GameVariables.h"
#include "_RootButtonHandler.h"
#include "_GameProcess.h"
#include <stdlib.h>
#include "LED-Display.h"
#include "SystemUtilities.h"
#include "Audio.h"
#include "CanRoutines.h"
#include "DataTypes.h"
#include "SoundMapping.h"
#include "GameMapping.h"
#include "InternalButtonSoundMapping.h"
#include "TimerRoutines.h"

//*************************************************
//*******Game Parameters***************************
//*************************************************

#define SHOW_PATTERN_SIGNED_INTERVAL				 50
#define RESPONSE_TIME						 400
#define RESPONSE_TIME_2P					 500
#define PAUSE_BEFORE_NEXT_PATTERN_TIME 		 90
#define PAUSE_BEFORE_NEXT_PATTERN_TIME_2P	 90
#define NINJA_HIT						  	 5
#define NINJA_HIT_BONUS						 15
#define NINJA_HIT_BONUS_FIRST				 35
#define MAX_PATTERN_ELEMENTS 				 4
#define MIN_PATTERN_ELEMENTS 				 2

//*************************************************
//******** AUDIO STREAM MAPPING *******************
//*************************************************

#define BACKGROUND_MUSIC_STREAM			0x00
#define P1_NODE_SOUND_EFFECT_STREAM		0x01
#define P2_NODE_SOUND_EFFECT_STREAM		0x02
#define HUGE_HIT_STREAM					0x03

//*************************************************
//******** System Timer MACROS*********************
//*************************************************

#define MAIN_GAME_TIMER		 	  	 GPTimer[0]
#define SHOW_PATTERN_TIMER			 GPTimer[1]
#define WAIT_FOR_RESPONSE_TIMER		 GPTimer[2]

//*************************************************
//******** GAME STATE MACROS*** *******************
//*************************************************

#define NINJA_1P					0x01
#define NINJA_2P					0x02
#define NINJA_END					0x03
#define NINJA_INIT					0x04

#define NINJA_SHOW_PATTERN  	  	 0x00
#define NINJA_WAIT_FOR_RESPONSE 	 0x01
#define PAUSE_BEFORE_NEXT_PATTERN	 0x02

//*************************************************
//*******Game Variables****************************
//*************************************************

static BYTE NinjaSubState = NINJA_SHOW_PATTERN;
static BOOL PatternElementDisplayed = FALSE;
static BYTE CurrentPatternElementDisplay;
static BYTE P1HitCount;
static BYTE P2HitCount;
static volatile BOOL P1PatternFinished;
static volatile BOOL P2PatternFinished;
static BYTE RandomStartPosition;
static BOOL MistakeMade;
static BOOL ExtendedOnePlayerMode;
static const BYTE NinjaPatternBuffer2Players[] = {
							 
							 
							2, 1, 2,
							2, 6, 5,
							3, 1, 2, 3,
							3, 7, 6, 5,
							2, 1, 0,
							2, 4, 5,
							3, 1, 0, 7,
							3, 3, 4, 5,
							3, 1, 7, 0,
							3, 4, 2, 3,
							3, 7, 5, 6,
							3, 2, 0, 1,
							3, 5, 2, 7,
							3, 3, 0, 5,
							3, 1, 3, 2,
							3, 6, 0, 7,
							3, 3, 5, 4,
							3, 0, 2, 1,
							3, 5, 0, 3,
							3, 7, 2, 5,
							4, 1, 7, 0, 6,
							4, 2, 4, 3, 5,

							0xFF
							};
							
static const BYTE NinjaPatternBuffer1Player[] = {
					
					
							2, 1, 2,
							2, 6, 5,
							3, 1, 2, 3,
							3, 7, 6, 5,
							2, 1, 0,
							2, 4, 5,
							3, 1, 0, 7,
							3, 3, 4, 5,
							3, 1, 7, 0,
							3, 4, 2, 3,
							3, 7, 5, 6,
							3, 2, 0, 1,
							3, 5, 2, 7,
							3, 3, 0, 5,
							3, 1, 3, 2,
							3, 6, 0, 7,
							3, 3, 5, 4,
							3, 0, 2, 1,
							3, 5, 0, 3,
							3, 7, 2, 5,
							4, 1, 7, 0, 6,
							4, 2, 4, 3, 5,
						
							4, 1, 2, 3, 4,
							4, 4, 3, 2, 1, 
							3, 1, 4, 7,
							3, 3, 6, 1,
							4, 1, 0, 7, 6,
							4, 6, 7, 0, 1, 
							3, 1, 6, 3,
							3, 7, 4, 1,
							1, 1,
							1, 5,
							4, 1, 2, 3, 4, 
							4, 1, 0, 7, 6,
							4, 1, 3, 0, 4,
							4, 0, 2, 7, 3,
							4, 7, 1, 6, 2,
							4, 6, 0, 5, 1,
							4, 5, 7, 4, 0,
							4, 4, 6, 3, 7,
							4, 3, 5, 2, 6,
							4, 2, 4, 1, 5,
							4, 1, 7, 2, 6,
							4, 2, 0, 3, 7,
							4, 3, 1, 4, 0,
							4, 4, 2, 5, 1,
							4, 5, 3, 6, 2,
							4, 6, 4, 7, 3,
							4, 7, 5, 0, 4,
							4, 8, 6, 1, 5,

							0xFF
							};
					
	
static WORD CurrentPatternBufferPosition = 0;

typedef struct{
				
				BYTE PatternLength;
				BYTE Pattern[MAX_PATTERN_ELEMENTS];
				BYTE HitFlag[MAX_PATTERN_ELEMENTS];
				
			} NinjaPattern;
		  		

NinjaPattern CurrentNinjaPatternP1;
NinjaPattern UserEnteredNinjaPatternP1;
NinjaPattern CurrentNinjaPatternP2;
NinjaPattern UserEnteredNinjaPatternP2;

//*************************************************
//*******Game Helper Function Declarations*********
//*************************************************

void GetRandomNinjaPattern(NinjaPattern *NewNinjaPattern);
void NinjaPlayNodeSound(BYTE Player, BYTE button);
void NinjaPlayBadGong();
void NinjaPlayQuickHit(BYTE Player, BYTE button);
void NinjaPlayHugeHit(BYTE button);
BOOL PatternsEqual(NinjaPattern *Pattern1,NinjaPattern *Pattern2);
BOOL IsPartofPattern(BYTE button,NinjaPattern *PatternToCheck);
BOOL PatternsEqual(NinjaPattern *Pattern1,NinjaPattern *Pattern2);
BOOL IsPartofPatternSubset(BYTE button,NinjaPattern *PatternToCheck, BYTE SubSetLength);
BOOL GetNextNinjaPattern(BYTE *PatternBuffer, NinjaPattern * PatternToPopulate);
void Generate2PPattern(NinjaPattern * P1Pattern,NinjaPattern * P2Pattern);
void ResetNinjaPatternStateVariables();
void ClearNinjaPattern(NinjaPattern * NPattern);
BYTE WhereInPatternIsElement(BYTE button,NinjaPattern *PatternToCheck);
void RenderNinjaPattern(NinjaPattern * NPattern, BYTE ColorOnR, BYTE ColorOnG, BYTE ColorOnB);
void MoveToNinjaEnd();


//*************************************************
//*******Game Functions****************************
//*************************************************

void Ninja(void)
{

	switch (GameState)
	{
		
		case INIT:
			ResetAudioAndLEDS();
			SendNodeNOP();
			SendNodeNOP();
			
			MAIN_GAME_TIMER = 0;
			GameState = NINJA_INIT;
		
		break;

	 	case NINJA_INIT:
	 	
			 	if(MAIN_GAME_TIMER > 10)
			 	{
					if(GamePlayers == 1)
					{
						AudioNodeEnable(ENABLE_ALL,BACKGROUND_MUSIC_STREAM,BACKGROUND_MUSIC_STREAM,AUDIO_ON_BEFORE_AFTER_TIMEOUT,NO_TIMEOUT,CurrentGameSettings.GameBackgroundMusicVolume,CurrentGameSettings.GameBackgroundMusicVolume);
						SendNodeNOP();	
						EAudioPlaySound(BACKGROUND_MUSIC_STREAM,NINJABACKGROUND_WAV);
					
						GameState = NINJA_1P;
						
						CurrentPatternBufferPosition = 0;
						
						ResetNinjaPatternStateVariables();
						GetNextNinjaPattern((BYTE *)(&NinjaPatternBuffer1Player[0]),&CurrentNinjaPatternP1);
						
						ScoreManagerEnabled = FALSE;
						Player1Score = 0;
						Player2Score = 0;
						RandomStartPosition = RandomButton(NO_EXCLUDE, NO_EXCLUDE, NO_EXCLUDE);
							
						P1ScoreDisplayState = SCORE_NORMAL;
						P2ScoreDisplayState = SCORE_BLANK;
						
						
						MistakeMade = FALSE;
						ExtendedOnePlayerMode = FALSE;
					
					}
					else
					{
					
				    	AudioNodeEnable(ENABLE_ALL,BACKGROUND_MUSIC_STREAM,BACKGROUND_MUSIC_STREAM,AUDIO_ON_BEFORE_TIMEOUT,NINJABACKGROUND_WAV_LENGTH,CurrentGameSettings.GameBackgroundMusicVolume,0);
						SendNodeNOP();	
						EAudioPlaySound(BACKGROUND_MUSIC_STREAM,NINJABACKGROUND_WAV);
					
						GameState = NINJA_2P;
						MAIN_GAME_TIMER = 0;
						CurrentPatternBufferPosition = 0;
						ResetNinjaPatternStateVariables();
					
						GetNextNinjaPattern((BYTE *)NinjaPatternBuffer2Players,&CurrentNinjaPatternP1);
						Generate2PPattern(&CurrentNinjaPatternP1,&CurrentNinjaPatternP2);
						
						Player1Score = 0;
						Player2Score = 0;
						
						P1ScoreDisplayState = SCORE_NORMAL;
						P2ScoreDisplayState = SCORE_NORMAL;
						RandomStartPosition = RandomButton(NO_EXCLUDE, NO_EXCLUDE, NO_EXCLUDE);
					}
					
					ScoreManagerEnabled = TRUE;
					MAIN_GAME_TIMER = 0;
				}	
	 	
	 	break;

		case NINJA_1P:
	
		if(ExtendedOnePlayerMode == FALSE)
		{
			if(MAIN_GAME_TIMER>=NINJABACKGROUND_WAV_LENGTH-12)
			{
				if(MistakeMade == TRUE)
				{
					MoveToNinjaEnd();
				}
				else
				{
					ExtendedOnePlayerMode = TRUE;	
				}	
			}
		}
		else
		{
				if(Player1Score >= 999)
				{
					MoveToNinjaEnd();	
				}	
		}		
		
						
		switch(NinjaSubState)
				{
				   case NINJA_SHOW_PATTERN:
						
				    if(SHOW_PATTERN_TIMER>SHOW_PATTERN_SIGNED_INTERVAL)
					{
						SHOW_PATTERN_TIMER = 0;
						
						NinjaPlayNodeSound(PLAYER_1,CurrentNinjaPatternP1.Pattern[CurrentPatternElementDisplay]);
						SendNodeNOP();
						RenderNinjaPattern(&CurrentNinjaPatternP1,RED);	
							
						CurrentPatternElementDisplay++;
						if(CurrentPatternElementDisplay == CurrentNinjaPatternP1.PatternLength)
						{
							NinjaSubState = NINJA_WAIT_FOR_RESPONSE;
							WAIT_FOR_RESPONSE_TIMER = 0;
						}
					}
					
					break;
					
					case NINJA_WAIT_FOR_RESPONSE:
					
						if(P1PatternFinished==TRUE)
						{
							WAIT_FOR_RESPONSE_TIMER = 0;
							NinjaSubState = PAUSE_BEFORE_NEXT_PATTERN;
						}
						
						if(WAIT_FOR_RESPONSE_TIMER > RESPONSE_TIME)
						{
							WAIT_FOR_RESPONSE_TIMER = 0;
							NinjaPlayBadGong();
							LEDSendMessage(ENABLE_ALL,LEDOFF,LEDOFF,0,0);
						    NinjaSubState = PAUSE_BEFORE_NEXT_PATTERN;
						    MistakeMade = TRUE;
						}
					
					break;	
					
					case PAUSE_BEFORE_NEXT_PATTERN:
					
					if(WAIT_FOR_RESPONSE_TIMER > PAUSE_BEFORE_NEXT_PATTERN_TIME)
					{
						if((MistakeMade == TRUE) && (ExtendedOnePlayerMode == TRUE))
						{
							MoveToNinjaEnd();
						}
						else
						{	
							ResetNinjaPatternStateVariables();
							GetNextNinjaPattern((BYTE *)&NinjaPatternBuffer1Player[0],&CurrentNinjaPatternP1);
							LEDSendMessage(ENABLE_ALL,LEDOFF,LEDOFF,0,0);
						}
					}
					break;
					
					default:
					break;
				}
		
		break;

		
		case NINJA_2P:
		
		if(MAIN_GAME_TIMER>NINJABACKGROUND_WAV_LENGTH)
		{
			MoveToNinjaEnd();
		}
		
		
			switch(NinjaSubState)
				{
				   case NINJA_SHOW_PATTERN:
						
				    if(SHOW_PATTERN_TIMER>SHOW_PATTERN_SIGNED_INTERVAL)
					{
						SHOW_PATTERN_TIMER = 0;
						
						NinjaPlayNodeSound(PLAYER_1,CurrentNinjaPatternP1.Pattern[CurrentPatternElementDisplay]);
						NinjaPlayNodeSound(PLAYER_2,CurrentNinjaPatternP2.Pattern[CurrentPatternElementDisplay]);
						SendNodeNOP();
						RenderNinjaPattern(&CurrentNinjaPatternP1,RED);	
						RenderNinjaPattern(&CurrentNinjaPatternP2,GREEN);		
						
						CurrentPatternElementDisplay++;
						if(CurrentPatternElementDisplay == CurrentNinjaPatternP1.PatternLength)
						{
							NinjaSubState = NINJA_WAIT_FOR_RESPONSE;
							WAIT_FOR_RESPONSE_TIMER = 0;
						}
					}
					
					break;
					
					case NINJA_WAIT_FOR_RESPONSE:
					
						if((P1PatternFinished==TRUE) && (P2PatternFinished==TRUE))
						{
							WAIT_FOR_RESPONSE_TIMER = 0;
							NinjaSubState = PAUSE_BEFORE_NEXT_PATTERN;
						}
						
						if(WAIT_FOR_RESPONSE_TIMER > RESPONSE_TIME_2P)
						{
							WAIT_FOR_RESPONSE_TIMER = 0;
							NinjaPlayBadGong();
							LEDSendMessage(ENABLE_ALL,LEDOFF,LEDOFF,0,0);
						    NinjaSubState = PAUSE_BEFORE_NEXT_PATTERN;
						    
						}
					
					break;	
					
					case PAUSE_BEFORE_NEXT_PATTERN:
					
					if(WAIT_FOR_RESPONSE_TIMER > PAUSE_BEFORE_NEXT_PATTERN_TIME_2P)
					{
							ResetNinjaPatternStateVariables();
							GetNextNinjaPattern((BYTE *)&NinjaPatternBuffer2Players[0],&CurrentNinjaPatternP1);
							Generate2PPattern(&CurrentNinjaPatternP1,&CurrentNinjaPatternP2);
							LEDSendMessage(ENABLE_ALL,LEDOFF,LEDOFF,0,0);
				
					}
					break;
					
					default:
					break;
				}
		
		
		break;
		
		
		case NINJA_END:
		
			if(MAIN_GAME_TIMER>ENDING_WAV_LENGTH)
			{
				ResetToGameSelector();
			}
				
		break;

		default:
		GameState = INIT;
		break;

		}
}



void ResetNinjaPatternStateVariables()
{
	
	ClearNinjaPattern(&CurrentNinjaPatternP1);
	ClearNinjaPattern(&CurrentNinjaPatternP2);
	ClearNinjaPattern(&UserEnteredNinjaPatternP1);
	ClearNinjaPattern(&UserEnteredNinjaPatternP2);

	NinjaSubState = NINJA_SHOW_PATTERN;
    CurrentPatternElementDisplay=0;	
	SHOW_PATTERN_TIMER = SHOW_PATTERN_SIGNED_INTERVAL-1;
	PatternElementDisplayed=FALSE;	
	CurrentPatternElementDisplay=0;	
	P1HitCount = 0;
	P2HitCount = 0;
	P1PatternFinished=FALSE;
	P2PatternFinished=FALSE;
	
}	


void RenderNinjaPattern(NinjaPattern * NPattern, BYTE ColorOnR, BYTE ColorOnG, BYTE ColorOnB)
{
	BYTE i;
	
	for(i=0;i<CurrentPatternElementDisplay+1;i++)
	{
		if(NPattern->HitFlag[i] == TRUE)
			LEDSendMessage(NPattern->Pattern[i] ,LEDOFF,LEDOFF,0,0);	
		else
			LEDSendMessage(NPattern->Pattern[i] ,ColorOnR,ColorOnG,ColorOnB,ColorOnR,ColorOnG,ColorOnB,0,0);		
	}		
}	

void OnButtonPressNinja(BYTE button)
{
	
	BYTE PatternElementLocation;
	
	switch(GameState)
	{
		case NINJA_1P:
		case NINJA_2P:
		
			switch(NinjaSubState)
			{
				
				case NINJA_SHOW_PATTERN:
				case NINJA_WAIT_FOR_RESPONSE:
				
				
				 PatternElementLocation = WhereInPatternIsElement(button,&CurrentNinjaPatternP1);
				
				 if(PatternElementLocation != 0xFF)
					{	
						
						//See if these element has already been hit
						if(CurrentNinjaPatternP1.HitFlag[PatternElementLocation] == TRUE)
						{
							//if this location has already been hit, then exit;
							return;	
							MistakeMade = TRUE;
						}	
						
						CurrentNinjaPatternP1.HitFlag[PatternElementLocation] = TRUE;
						
						//Record this into the actual user hit pattern struct	
																					
						UserEnteredNinjaPatternP1.Pattern[P1HitCount] = button;
						
						LEDSendMessage(button,LEDOFF,LEDOFF,0,0);
						
						P1HitCount++;
										
						if(P1HitCount == (CurrentNinjaPatternP1.PatternLength))
						{
							NinjaPlayHugeHit(button);
							LEDSendMessage(button,LEDOFF,LEDOFF,0,0);
							UserEnteredNinjaPatternP1.PatternLength = P1HitCount;
							
							P1PatternFinished=TRUE;
							
							if(PatternsEqual(&UserEnteredNinjaPatternP1,&CurrentNinjaPatternP1))
							{
								Player1Score += NINJA_HIT_BONUS; 
							}
							else
							{
								Player1Score += NINJA_HIT; 	
								MistakeMade = TRUE;
							}
						}
						else
						{
							Player1Score += NINJA_HIT;
							NinjaPlayQuickHit(PLAYER_1,button);
							LEDSendMessage(button,LEDOFF,LEDOFF,0,0);
						}
					}
					else
					{
						MistakeMade = TRUE;	
					}	
				break;
				
				default:
				break;	
			}					
			if(GamePlayers == 2)
			{	
				 PatternElementLocation = WhereInPatternIsElement(button,&CurrentNinjaPatternP2);
				
				 if(PatternElementLocation != 0xFF)
					{	
						
						//See if these element has already been hit
						if(CurrentNinjaPatternP2.HitFlag[PatternElementLocation] == TRUE)
						{
							//if this location has already been hit, then exit;
							return;	
							MistakeMade = TRUE;
						}	
						
						CurrentNinjaPatternP2.HitFlag[PatternElementLocation] = TRUE;
						
						//Record this into the actual user hit pattern struct	
																					
						UserEnteredNinjaPatternP2.Pattern[P2HitCount] = button;
						
						LEDSendMessage(button,LEDOFF,LEDOFF,0,0);
						
						P2HitCount++;
										
						if(P2HitCount == (CurrentNinjaPatternP2.PatternLength))
						{
							NinjaPlayHugeHit(button);
							LEDSendMessage(button,LEDOFF,LEDOFF,0,0);
							UserEnteredNinjaPatternP2.PatternLength = P2HitCount;
							
							P2PatternFinished=TRUE;
							
							if(PatternsEqual(&UserEnteredNinjaPatternP2,&CurrentNinjaPatternP2))
							{
								Player2Score += NINJA_HIT_BONUS; 
							}
							else
							{
								Player2Score += NINJA_HIT; 	
								MistakeMade = TRUE;
							}
						}
						else
						{
							Player2Score += NINJA_HIT;
							NinjaPlayQuickHit(PLAYER_2,button);
							LEDSendMessage(button,LEDOFF,LEDOFF,0,0);
						}
					}
					else
					{
						MistakeMade = TRUE;	
					}	
		}
		
	
	
	
	
		break;
				
		default:
		break;
	}
	
	
}






void NinjaPlayNodeSound(BYTE Player, BYTE button)
{
	switch(button)
	{
		case 0:
			if(Player == PLAYER_1)
			{
				AudioNodeEnable(button,P1_NODE_SOUND_EFFECT_STREAM,BACKGROUND_MUSIC_STREAM,1,1,NINJA_BUTTON_01_WAV_LENGTH,CurrentGameSettings.GameSoundEffectVolume,CurrentGameSettings.GameBackgroundMusicVolume);
				SendNodeNOP();	
				EAudioPlaySound(P1_NODE_SOUND_EFFECT_STREAM,NINJA_BUTTON_01_WAV);
				
			}
			else
			{
				AudioNodeEnable(button,P2_NODE_SOUND_EFFECT_STREAM,BACKGROUND_MUSIC_STREAM,1,1,NINJA_BUTTON_01_WAV_LENGTH,CurrentGameSettings.GameSoundEffectVolume,CurrentGameSettings.GameBackgroundMusicVolume);
				SendNodeNOP();	
				EAudioPlaySound(P2_NODE_SOUND_EFFECT_STREAM,NINJA_BUTTON_01_WAV);
			
			}
		break;
		
		case 1:
			if(Player == PLAYER_1)
			{
				AudioNodeEnable(button,P1_NODE_SOUND_EFFECT_STREAM,BACKGROUND_MUSIC_STREAM,1,1,NINJA_BUTTON_02_WAV_LENGTH,CurrentGameSettings.GameSoundEffectVolume,CurrentGameSettings.GameBackgroundMusicVolume);
				SendNodeNOP();	
				EAudioPlaySound(P1_NODE_SOUND_EFFECT_STREAM,NINJA_BUTTON_02_WAV);
			
			}
			else
			{
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
				SendNodeNOP();	
				EAudioPlaySound(P2_NODE_SOUND_EFFECT_STREAM,NINJA_BUTTON_08_WAV);
				
			}
		break;
	
		default:
		break;
	}
	
}	



void NinjaPlayBadGong()
{
		BYTE i;
	
	
		for(i=0;i<CurrentNinjaPatternP1.PatternLength;i++)
		{
			AudioNodeEnable(CurrentNinjaPatternP1.Pattern[i],P1_NODE_SOUND_EFFECT_STREAM,BACKGROUND_MUSIC_STREAM,1,1, NINJA_BADGONG_01_WAV_LENGTH,CurrentGameSettings.GameSoundEffectVolume,CurrentGameSettings.GameBackgroundMusicVolume);
		
			if(GameState == NINJA_2P)
			{
				AudioNodeEnable(CurrentNinjaPatternP2.Pattern[i],P1_NODE_SOUND_EFFECT_STREAM,BACKGROUND_MUSIC_STREAM,1,1, NINJA_BADGONG_01_WAV_LENGTH,CurrentGameSettings.GameSoundEffectVolume,CurrentGameSettings.GameBackgroundMusicVolume);
			
			}
		}
		
		SendNodeNOP();	
		EAudioPlaySound(P1_NODE_SOUND_EFFECT_STREAM, NINJA_BADGONG_01_WAV);
}



void NinjaPlayQuickHit(BYTE Player, BYTE button)
{

	BYTE RandomHit;
	
	BYTE Sound;
	WORD SoundLength;
	BYTE Stream;
	
	RandomHit = rand() & 0x7;
	
	if(RandomHit>4)
	{
		RandomHit -= 5;	
	}
	
	switch(RandomHit)
	{
		case 0:
			SoundLength =  NINJA_QUICKHIT_01_WAV_LENGTH;
			Sound = NINJA_QUICKHIT_01_WAV;
		break;	
		
		case 1:
			SoundLength =  NINJA_QUICKHIT_02_WAV_LENGTH;
			Sound = NINJA_QUICKHIT_02_WAV;
		break;	
		
		
		case 2:
			SoundLength =  NINJA_QUICKHIT_03_WAV_LENGTH;
			Sound = NINJA_QUICKHIT_03_WAV;
		break;	
				
		case 3:
			SoundLength =  NINJA_QUICKHIT_04_WAV_LENGTH;
			Sound = NINJA_QUICKHIT_04_WAV;
		break;	
		
		
		case 4:
			SoundLength =  NINJA_QUICKHIT_05_WAV_LENGTH;
			Sound = NINJA_QUICKHIT_05_WAV;
		break;	
			
		
		default:
		break;
		
	}
	
	
	if(Player == PLAYER_1)
	{
		Stream = P1_NODE_SOUND_EFFECT_STREAM;
	}
	else
	{
		Stream = P2_NODE_SOUND_EFFECT_STREAM;	
	}
	
	AudioNodeEnable(button,Stream,BACKGROUND_MUSIC_STREAM,1,1, SoundLength,CurrentGameSettings.GameSoundEffectVolume,CurrentGameSettings.GameBackgroundMusicVolume);
	AudioNodeEnable((button+1)&0x07,Stream,BACKGROUND_MUSIC_STREAM,1,1, SoundLength,CurrentGameSettings.GameSoundEffectVolume,CurrentGameSettings.GameBackgroundMusicVolume);
	AudioNodeEnable((button-1)&0x07,Stream,BACKGROUND_MUSIC_STREAM,1,1, SoundLength,CurrentGameSettings.GameSoundEffectVolume,CurrentGameSettings.GameBackgroundMusicVolume);
	
	SendNodeNOP();	
	EAudioPlaySound(Stream, Sound);
	
}


void NinjaPlayHugeHit(BYTE button)
{

	BYTE RandomHit;
	
	RandomHit = rand() & 0xF;
	
	BYTE Sound;
	WORD SoundLength;
	
	if(RandomHit>9)
	{
		RandomHit -= 10;	
	}
	
	switch(RandomHit)
	{
		case 0:
			SoundLength =  NINJA_HUGEHIT_01_WAV_LENGTH;
			Sound = NINJA_HUGEHIT_01_WAV;
		break;	
		
		case 1:
			SoundLength =  NINJA_HUGEHIT_02_WAV_LENGTH;
			Sound = NINJA_HUGEHIT_02_WAV;
		break;	
		
		
		case 2:
			SoundLength =  NINJA_HUGEHIT_03_WAV_LENGTH;
			Sound = NINJA_HUGEHIT_03_WAV;
		break;	
				
		case 3:
			SoundLength =  NINJA_HUGEHIT_04_WAV_LENGTH;
			Sound = NINJA_HUGEHIT_04_WAV;
		break;	
		
		
		case 4:
			SoundLength =  NINJA_HUGEHIT_05_WAV_LENGTH;
			Sound = NINJA_HUGEHIT_05_WAV;
		break;	
			

		case 5:
			SoundLength =  NINJA_BIGHIT_01_WAV_LENGTH;
			Sound = NINJA_BIGHIT_01_WAV;
		break;	
		
		case 6:
			SoundLength =  NINJA_BIGHIT_02_WAV_LENGTH;
			Sound = NINJA_BIGHIT_02_WAV;
		break;	
		
		
		case 7:
			SoundLength =  NINJA_BIGHIT_03_WAV_LENGTH;
			Sound = NINJA_BIGHIT_03_WAV;
		break;	
				
		case 8:
			SoundLength =  NINJA_BIGHIT_04_WAV_LENGTH;
			Sound = NINJA_BIGHIT_04_WAV;
		break;	
		
		
		case 9:
			SoundLength =  NINJA_BIGHIT_05_WAV_LENGTH;
			Sound = NINJA_BIGHIT_05_WAV;
			
		break;		
		
		default:
		break;
		
	}


	AudioNodeEnable(button,HUGE_HIT_STREAM,BACKGROUND_MUSIC_STREAM,1,1, SoundLength,CurrentGameSettings.GameSoundEffectVolume,CurrentGameSettings.GameBackgroundMusicVolume);
	AudioNodeEnable((button+1)&0x07,HUGE_HIT_STREAM,BACKGROUND_MUSIC_STREAM,1,1, SoundLength,CurrentGameSettings.GameSoundEffectVolume,CurrentGameSettings.GameBackgroundMusicVolume);
	AudioNodeEnable((button-1)&0x07,HUGE_HIT_STREAM,BACKGROUND_MUSIC_STREAM,1,1, SoundLength,CurrentGameSettings.GameSoundEffectVolume,CurrentGameSettings.GameBackgroundMusicVolume);
	AudioNodeEnable((button+2)&0x07,HUGE_HIT_STREAM,BACKGROUND_MUSIC_STREAM,1,1, SoundLength,CurrentGameSettings.GameSoundEffectVolume,CurrentGameSettings.GameBackgroundMusicVolume);
	AudioNodeEnable((button-2)&0x07,HUGE_HIT_STREAM,BACKGROUND_MUSIC_STREAM,1,1, SoundLength,CurrentGameSettings.GameSoundEffectVolume,CurrentGameSettings.GameBackgroundMusicVolume);
	
	
	SendNodeNOP();	
	EAudioPlaySound(HUGE_HIT_STREAM, Sound);
		
	
}





BOOL IsPartofPatternSubset(BYTE button,NinjaPattern *PatternToCheck, BYTE SubSetLength)
{
	BYTE i;
	
	if(SubSetLength == 0 || SubSetLength>PatternToCheck->PatternLength)
	{
		return FALSE;	
	}
	
	for(i=0; i< SubSetLength; i++)
	{
		if(button == PatternToCheck->Pattern[i])
		{
			return TRUE;	
		}
	}
	
	return FALSE;
}

	

BOOL PatternsEqual(NinjaPattern *Pattern1,NinjaPattern *Pattern2)
{
	BYTE i;
	
	if(Pattern1->PatternLength != Pattern2->PatternLength)
	{
		return FALSE;
	}
	
	for(i=0;i<Pattern1->PatternLength;i++)
	{
		if(Pattern1->Pattern[i] != Pattern2->Pattern[i])
		{
			return FALSE;	
		}
	}

	return TRUE;
}

	


void GetRandomNinjaPattern(NinjaPattern *NewNinjaPattern)
{
	
	BYTE i;
	
	if(rand()&0x01)
	{
		NewNinjaPattern->PatternLength = 2;	
		
	}
	else
	{
		if(rand()&0x01)
			{
			  NewNinjaPattern->PatternLength = 3;		
			}
			else
			{
		   	 NewNinjaPattern->PatternLength = 4;	
			}
	}
	
	for(i=0;i<NewNinjaPattern->PatternLength;i++)
	{
			
		NewNinjaPattern->Pattern[i] = RandomButton(NO_EXCLUDE, NO_EXCLUDE, NO_EXCLUDE);
	}
	
}	

BOOL GetNextNinjaPattern(BYTE *PatternBuffer, NinjaPattern * PatternToPopulate)
{
	BYTE i;

	
	if(PatternBuffer[CurrentPatternBufferPosition] == 0xFF)
	{
		CurrentPatternBufferPosition = 0;
		//return FALSE;	
	}
	
	PatternToPopulate->PatternLength = PatternBuffer[CurrentPatternBufferPosition];
	CurrentPatternBufferPosition++;
	
	for(i=0;i<PatternToPopulate->PatternLength;i++)
	{			
		PatternToPopulate->Pattern[i] = (PatternBuffer[CurrentPatternBufferPosition]) ;
		CurrentPatternBufferPosition++;
	}
	
	return TRUE;
}



void Generate2PPattern(NinjaPattern * P1Pattern,NinjaPattern * P2Pattern)
{
	BYTE i;

	P2Pattern->PatternLength = P1Pattern->PatternLength;
		
	for(i=0;i<P1Pattern->PatternLength;i++)
	{			
		P2Pattern->Pattern[i] = (P1Pattern->Pattern[i] + 4) & 0x7;
		
	}

}


void ClearNinjaPattern(NinjaPattern * NPattern)
{
	BYTE i;
	
	NPattern->PatternLength = 0;
		
	for(i=0;i<MAX_PATTERN_ELEMENTS;i++)
	{
	
		NPattern->Pattern[i] = 0xFF;
		NPattern->HitFlag[i] = FALSE;
	}
}




BOOL IsPartofPattern(BYTE button,NinjaPattern *PatternToCheck)
{
	BYTE i;
	
	for(i=0; i<PatternToCheck->PatternLength;i++)
	{
		if(button == PatternToCheck->Pattern[i])
		{
			return TRUE;	
		}
	}
	
	return FALSE;
}


BYTE WhereInPatternIsElement(BYTE button,NinjaPattern *PatternToCheck)
{
	BYTE i;
	
	for(i=0; i<PatternToCheck->PatternLength;i++)
	{
		if(button == PatternToCheck->Pattern[i])
		{
			return i;	
		}
	}
	
	return 0xFF;
}


void MoveToNinjaEnd()
{
	GameState = NINJA_END;
	MAIN_GAME_TIMER = 0;
	AudioNodeEnable(ENABLE_ALL,BACKGROUND_MUSIC_STREAM,BACKGROUND_MUSIC_STREAM,AUDIO_ON_BEFORE_TIMEOUT,ENDING_WAV_LENGTH,CurrentGameSettings.FinaleMusicVolume,0);
	SendNodeNOP();	
	EAudioPlaySound(BACKGROUND_MUSIC_STREAM,ENDING_WAV);		
	LEDSendMessage(ENABLE_ALL,LEDOFF,LEDOFF,0,0);
				
	if(GamePlayers == 1)
	{
		P1ScoreDisplayState = SCORE_FLASHING;
		P2ScoreDisplayState = SCORE_BLANK;
	}
		
	else
	{
	  SyncDisplayFlashing();
		if(Player1Score > Player2Score)
			{
				P1ScoreDisplayState = SCORE_FLASHING;
				P2ScoreDisplayState = SCORE_NORMAL;
			}
		else if(Player2Score > Player1Score)
			{
					P2ScoreDisplayState = SCORE_FLASHING;
					P1ScoreDisplayState = SCORE_NORMAL;
			}
		else 
		{
				P2ScoreDisplayState = SCORE_FLASHING;
				P1ScoreDisplayState = SCORE_FLASHING;
		}
	}
	
}	
