ehughes/NEOS_2ND_GENERATION/SRC/PRODUCTION_RELEASE/SLAVE/SRC/InteralSounds.c

#include "InternalSounds.h"

const unsigned char PositiveFeedback[4967] __attribute__((space(__auto_psv__)))={
0xED,0xED,0xED,0xED,0xED,0xED,0xED,0xED,0xED,0xED,0xFE,0x0E,0xFF,0xF9,0xEC,0xE2,0xD8,0xCF,0xC7,0xBF,0xB9,
0xB5,0x13,0x4F,0x30,0x2A,0x11,0xFE,0xEA,0xD7,0xC7,0xB7,0xAB,0xA0,0x97,0x9D,0x5C,0x75,0x3C,0x2C,0x12,
0xFE,0xEA,0xD8,0xC8,0xBA,0xAD,0xA5,0xAB,0xAD,0x4D,0x79,0x35,0x21,0x03,0xEB,0xD3,0xBF,0xAC,0xAA,0xEC,
0xCD,0xBA,0xAF,0x34,0x7E,0x32,0x21,0x03,0xEB,0xD4,0xC1,0xB0,0xB2,0xEF,0xCD,0xBC,0xAF,0x18,0x7F,0x30,
0x20,0x03,0xEC,0xD7,0xC4,0xB4,0xB5,0xF2,0xD1,0xC0,0xB2,0xFC,0x7E,0x2D,0x1E,0x03,0xED,0xD8,0xC7,0xB7,
0xB9,0xF4,0xD4,0xC4,0xB6,0xE6,0x7B,0x2D,0x1D,0x03,0xEF,0xDB,0xCA,0xBB,0xBC,0xF5,0xD8,0xC7,0xBA,0xD6,
0x75,0x2D,0x1B,0x03,0xF0,0xDD,0xCD,0xBF,0xBF,0xF5,0xDB,0xC9,0xBC,0xC9,0x6D,0x2F,0x1B,0x04,0xF1,0xE0,
0xCF,0xC3,0xC1,0xF6,0xDC,0xCC,0xBE,0xC3,0x61,0x32,0x19,0x05,0xF2,0xE1,0xD2,0xC5,0xC4,0xF6,0xDE,0xCD,
0xC0,0xC0,0x51,0x36,0x18,0x07,0xF2,0xE2,0xD3,0xC8,0xC7,0xF6,0xE1,0xD1,0xC3,0xBF,0x40,0x39,0x17,0x07,
0xF2,0xE3,0xD6,0xCA,0xC9,0xF6,0xE3,0xD2,0xC5,0xC0,0x2F,0x3B,0x16,0x07,0xF4,0xE5,0xD7,0xCD,0xCA,0xF7,
0xE6,0xD4,0xC8,0xC3,0x1D,0x3C,0x14,0x08,0xF4,0xE6,0xD8,0xCF,0xCE,0xF7,0xE7,0xD7,0xCA,0xC4,0x0D,0x3F,
0x14,0x08,0xF5,0xE7,0xDB,0xD2,0xD1,0xF6,0xE7,0xD8,0xCC,0xC5,0xFF,0x3F,0x14,0x08,0xF5,0xE7,0xDC,0xD4,
0xD3,0xF6,0xE8,0xD9,0xCD,0xC7,0xF4,0x3C,0x14,0x08,0xF5,0xE8,0xDD,0xD7,0xD6,0xF7,0xE8,0xDB,0xCF,0xC9,
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
0xC8,0xD5,0xEC,0xFD,0x0D,0x24,0x35,0x38,0x38,0x38,0x29,0x12,0x01,0xF0,0xD8,0xC9,0xC8,0xC6,0xC9,0xDA,
0xF1,0x01,0x15,0x2C,0x39,0x39,0x3A,0x35,0x22,0x0B,0xFB,0xE7,0xD0,0xC7,0xC7,0xC7,0xCE,0xE4,0xF9,0x0A,
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
