ehughes/NEOS_2ND_GENERATION/SRC/PRODUCTION_RELEASE/MASTER/LIGHT_RING/SRC/__Game_JamCircle.c

#include "__Game_JamCircle.h"
#include "SystemVariables.h"
#include "_GameVariables.h"
#include "_RootButtonHandler.h"
#include "_GameProcess.h"
#include <stdlib.h>
#include "LED-Display.h"
#include "SystemUtilities.h"
#include "Audio.h"
#include "CanRoutines.h"
#include "DataTypes.h"
#include "SoundMapping.h"
#include "GameMapping.h"
#include "InternalButtonSoundMapping.h"
#include "TimerRoutines.h"
#include "config.h"

//*************************************************
//*******Game Parameters***************************
//*************************************************

#define NUM_SOUNDS_PER_BUTTON	3

#define NUM_SOUND_CHANNELS	3


//*************************************************
//******** AUDIO STREAM MAPPING *******************
//*************************************************

#define	BACKGROUND_MUSIC_STREAM 3


//*************************************************
//******** GAME STATE MACROS*** *******************
//*************************************************

#define JAM_CIRCLE			0x01
#define JAM_CIRCLE_SELECT	0x02
#define JAM_CIRCLE_END		0x03



//*************************************************
//******** System Timer MACROS*********************
//*************************************************

#define MAIN_GAME_TIMER			GPTimer[0]
#define SOUND_CHANNEL0_TIMER	GPTimer[1]
#define SOUND_CHANNEL1_TIMER	GPTimer[2]
#define SOUND_CHANNEL2_TIMER	GPTimer[3]
#define SHOW_TIMER				GPTimer[4]


//*************************************************
//*******Game Variables****************************
//*************************************************
WORD JamCirclesBaseLocation = 150;

BYTE NextAvailableSoundChannel = 0;

#define NO_MATCH	0xFF

struct {
	
		BOOL Active;
		DWORD CurrentSoundLength;
		WORD ButtonAssignment;
	
}	SoundChannelInfo[3];	

struct{
	
	WORD Index[NUM_SOUNDS_PER_BUTTON][NUM_BUTTONS];
	DWORD Length[NUM_SOUNDS_PER_BUTTON][NUM_BUTTONS];
	BYTE CycleCnt[NUM_BUTTONS];
	
} ButtonSound ;
	

//*************************************************
//*******Game Helper Function Declarations*********
//*************************************************

void InitJamCircleChannels();
void JamCircleInitButtonSounds();


void ResetSoundChannelTimer(BYTE  Channel);
BYTE MatchButtonToActiveSoundChannel(BYTE button);
BYTE GetNextSoundChannel(BYTE button);
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
