ehughes/NEOS_2ND_GENERATION/(commit log)

2008-09-12 1st commit: Lightring has skeleton working.
    [ELC0100R3.DRL, ELC0100R3.GBL, ELC0100R3.GBO, ELC0100R3.GBS, ELC0100R3.GM1, ELC0100R3.GTL, ELC0100R3.GTO, ELC0100R3.GTS]
2008-09-22 Got initial version of teather ball for the light ring working. Power test now measures voltage drop accross the entire bus and correctly cylces through the number of game buttons defined by NUM_BUTT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
    [Diagnostics.c, ErrorCodes.h, SystemUtilities.c, SystemUtilities.h, __Game_Duck_Duck_Goose.c, __Game_TeatherBall.c, can.c]
2008-09-29 Fixed small bug in teatherball. During a serve, ball changes to correct color. Before, If Player 1 (green) wont he serve,m ball would stay green.
    [__Game_Comet.c, __Game_TeatherBall.c]
2008-10-02 Jam Circle and Surround Sound are more tolerable. The sharing of sound channels is more dynamic and there is no more garble background tracks when someone hits a button fast.
    [__Game_JamCircle.c, __Game_SurroundSound.c, main.c]
2008-10-06 Added a game called flip flop to replace comet. Change Jamcircle to new music (baby einstien style). Fixed light ring bug where same bug can be be picked twice. After a game is played, last game is r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
    [GameMapping.h, SoundMapping.h, _GameProcess.c, _RootButtonHandler.c, __Game_Comet.c, __Game_Duck_Duck_Goose.c, __Game_FlipFlop.c]
2008-10-06 Forgot to return the last build to go into boot mode after reset.
    [main.c]
2008-10-07 The light ring and all around projects now use relative links to the source files. This is get rids of the problem of opening the project on other machines.
    [Diagnostics.c, LED-Display.c, SystemUtilities.c, SystemUtilities.h, __Game_Double_Dots.c, __Game_LightGrabber.c, __Game_Ninja.c, __Game_Zig_Zag.c]
2008-10-22 Fixed Really bad Bug with internal sound playback. Volume levels other than FF would get really distorted as the code did not interpret the sign of the sound data correctly.
    [Audio.c, InteralSounds.c]
2008-10-24 Fixed music after boot, was distorted sometimes. Added a delay state in between Audio reset and starting the music. Fixed the MusicWake State machine. Fixed the Main Theme ending time so there wasn't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
    [_RootButtonHandler.c, __Game_RootGame0.c]
2008-10-24 When one presses the diagnostic button to get to addressing mode, you can not leave addressing mode until 6 buttons are addressed. Before you could leave the addressing mode early cause serious addre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
    The power check sequence now allows for a voltage down to 8V for the test to pass
    [Audio.c, Diagnostics.c, Diagnostics.h, EEPROM.c, EEPROMRoutines.h, SystemVariables.c]
2008-11-06 Fixed the diagnostics mode for >12v bus voltages. Had to change the BusVoltage variable from a WORD to DWORD to handle possible averaging filter overflows. Cleaned up alot of the other spport files. 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
    [ADC.c, Audio.c, Audio.h, Diagnostics.c, EEPROM.c, InternalButtonSoundMapping.h, SystemUtilities.c]
2008-11-06 Added 3 easter eggs to the Selector Routine. Random Bug fixes and feature updates. Ninja now works properly. Rodeo intro sound is fixed. Double dots 1P is not the old 2 player. The 2 Player mode is n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
    [SoundMapping.h, _GameVariables.h, __Game_Double_Dots.c, __Game_FireFighter.c, __Game_Ninja.c, __Game_Rodeo.c, __Game_RootGame0.c, __Game_SurroundSound.c]
2008-11-07 Cleaned up the code and added code to display version number on power up
2008-11-10 Some key port initialization code got cut out after the last committ...... Audio wasn't enabled on port G
2008-11-10 Fixed some volume issues on the selector game. The selector button presses always defaulted to max volume as well as the background music and heart beat. It now follows the GlobalVolume stored in FLA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
    [_GameVariables.h, __Game_RootGame0.c, __Game_SurroundSound.c]
2008-11-12 Added the Little ICD adapter Project Outputs for ICD_ADAPTER
    [ICD_ADAPTER.PcbDoc, ICD_ADAPTER.PrjPcb, ICD_ADAPTER.SchDoc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]
2010-05-26 Cleaned up code. Code rid of Nasty NI Leds and replaced with open source LB Industrial Controls Leds.
2010-10-22 Removing Old Scoreboard Project
    [Score V4.SchDoc, Score.PrjPCB, ScoreLED.PcbDoc]
2010-10-22 Work in Progress Commit...... 1st commit of official scoreboard build. Not quite ready for file submission.
    [ELC102 - Assembly Notes.SchDoc, ELC102 - Green Digits.SchDoc, ELC102 - Old Circuits.SchDoc, ELC102 - Red Digits.SchDoc, ELC102 - Score Board - Green Digits.SchDoc, ELC102 - Score Board - Red Digits.SchDoc, ELC102 - Score Board.PcbDoc, ELC102 - ScoreBoard - TopLevel.SchDoc]
2010-10-26 These the project files used to Build the first 2nd source prototype. Schematic BOM and connector assembly drawings a work in progress.
    [ELC102 - Assembly Notes.SchDoc, ELC102 - Green Digits.SchDoc, ELC102 - Old Circuits.SchDoc, ELC102 - Red Digits.SchDoc, ELC102 - Score Board.PcbDoc, ELC102 - ScoreBoard - TopLevel.SchDoc, ELC102 - Switch Interface.SchDoc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]
2010-10-29 Fixed some BOM issues and updated the outjob. This version is what is being used for the 1st Micki build of the scoreboard
    [Bill of Materials-ELC102 - Scoreboard(MAIN_BUILD).xls, ELC102 - Assembly Notes.SchDoc, ELC102 - Green Digits.SchDoc, ELC102 - Old Circuits.SchDoc, ELC102 - Red Digits.SchDoc, ELC102 - Score Board.PcbDoc, ELC102 - ScoreBoard - TopLevel.SchDoc, ELC102 - Scoreboard.PrjPcb]
2010-10-29 After looking at the Master Slave electronics, it was notice that pin 8 of the switching power supply chip (the heat sink tab) was not connected to ground. I added this connected and edited the PCB s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
    [ELC102 - Score Board.PcbDoc, ELC102 - ScoreBoard - TopLevel.SchDoc]
2010-10-31 This is the 1st commit of the official Playworld sourced build package for ELC0103 and ELC 0104 (NEOS Master / Slave). This slave has the 0.1uF fix for the NEOS 360. Build Package zipped and send to 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
    [Bill of Materials-NEOS Master-Slave(MASTER - ELC0104).xls, ELC0103 - MasterBoard - Wiring.SchDoc, ELC0104 - SlaveBoard - Wiring.SchDoc, Master-Slave.SchDoc, NEOS Master-Slave.PrjPcb, NEOS Master-Slave.SchDoc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]
2010-11-03 1st cut at build package / documentation for the NEOS ELC0205 Power Entry Module. These are the files that will be sent to Playworld for 1st Megatech build
    [Bill of Materials-ELC0205.xls, ELC0205 - Power Entry Module.PrjPCB, ELC0205-Wiring.SchDoc, ELC0205.PcbDoc, ELC0205.SchDoc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]
2010-11-04 Fixed a design rule issue where some polygons werent getting poured over nets. The default connection style got changed to "No Connect". The gerbers in the last commit looked OK.
    [ELC102 - Score Board.PcbDoc]
2010-11-04 Updated a couple component parameters to make the BOM look nices. The Phoenix programming port had a bad part number.
    [Bill of Materials-ELC102 - Scoreboard(MAIN_BUILD).xls, ELC102 - Green Digits.SchDoc, ELC102 - Old Circuits.SchDoc, ELC102 - Red Digits.SchDoc, ELC102 - ScoreBoard - TopLevel.SchDoc, ELC102 - Switch Interface.SchDoc]
2010-12-13 Rename 1 .....
    [Bill of Materials-ELC102 - Scoreboard(MAIN_BUILD).xls, ELC0102 - Assembly Notes.SchDoc, ELC0102 - Green Digits.SchDoc, ELC0102 - Old Circuits.SchDoc, ELC0102 - Red Digits.SchDoc, ELC0102 - ScoreBoard - TopLevel.SchDoc, ELC0102 - Scoreboard.PrjPcb, ELC0102 - Switch Interface.SchDoc]
2010-12-13 deleting old stuff
    [ELC0100R3.DRL, ELC0100R3.GBL, ELC0100R3.GBO, ELC0100R3.GBS, ELC0100R3.GM1, ELC0100R3.GTL, ELC0100R3.GTO, ELC0100R3.GTS]
2010-12-13 deleting ELC102
    [ELC0102 - Assembly Notes.SchDoc, ELC0102 - Green Digits.SchDoc, ELC0102 - Old Circuits.SchDoc, ELC0102 - Red Digits.SchDoc, ELC0102 - ScoreBoard - TopLevel.SchDoc, ELC0102 - Scoreboard.PrjPcb, ELC0102 - Switch Interface.SchDoc, PCB0010 - Score Board.PcbDoc]
2010-12-13 reanming to ELC0102. This version has the correct 238 decoder chip and 8.192MHz Crystal. To be sent to Megatech
    [ELC0102 - Assembly Notes.SchDoc, ELC0102 - Green Digits.SchDoc, ELC0102 - Old Circuits.SchDoc, ELC0102 - Red Digits.SchDoc, ELC0102 - ScoreBoard - TopLevel.SchDoc, ELC0102 - Scoreboard.PrjPcb, ELC0102 - Switch Interface.SchDoc, PCB0010 - Score Board.PcbDoc]
2010-12-13 more renaming...... This should now be what is sent to megatech
    [Pick Place for PCB0010 - Score Board(MAIN_BUILD).csv]
2010-12-13 Adding zip files to be sent to megatech. Also forgot to add some outputs in the last committ
    [Bill of Materials-ELC0102 - Scoreboard(MAIN_BUILD).xls]
2015-01-20 dev commit updated sounds with latest from Scott. Maybe some of the bug fixes last discussed
    [SoundMapping.h, __Game_Shrek.c]
2015-03-14 added some of the spec documents
    [ICD_ADAPTER.PcbDoc, ICD_ADAPTER.PrjPcb, NEOS Master-Slave.PrjPcb, NEOS Master-Slave.SchDoc, NEOS_CAN.PcbDoc, NEOS_CAN.PrjPcb, NEOS_CAN.SchDoc, PCB0008.PcbDoc]
